aibrainag/Gretchen/README.md

# Gretchen
Gretchen -- An Open-Source Humanoid Robot Development Platform.

## Assembly Manual (wip)
https://github.com/aibrainag/Gretchen/blob/master/documentation/documentation.adoc
