aibrainag/Gretchen/documentation/documentation.adoc

= Gretchen Assembly Documentation
Doc Writer <kubisch@informatik.hu-berlin.de>
v0.1, 2019-03-28
:imagesdir: ./images
:toc:

_This is the Gretchen assembly manual. Following these steps will enable you to build your gretchen walking robot from the assembly kit. We encourage everybody to contribute to this project. Please share your ideas, upgrades, schematics, source-code and tricks._

== Tool and Part List
NOTE: Before starting the assembly. Check that you have all the tools and parts in place. We recommend to read this manual once before starting the assembly.

WARNING: Self-manufacturing of the parts is encouraged but can not be officially supported and hence is to your own risk. If you decide to manufacture your own parts then tolerances may vary depending on the machines and methods you are using.

=== Recommended Tools

You will need these tools to assemble the Gretchen (Dev0) robot.

* Allen keys (hex drivers) sizes M4, M2, M1.6
* Ring spanner and socket wrench, size M8
* Small Phillips screw driver
* Soldering iron with a very fine tip for motor assembly, up to 400°C (regulated) temperature
* Brushes for painting the parts
* Tweezers for motor control board assembly
* Flat-nosed pliers or a crimp tool for custom cabling
* Side-cutting pliers
* Wire stripper
* Utility knife
* crimp tool (see section cable confection)
* Multimeter
* Taps (threading drills), sizes M4, M8
* Clamps (5-10) for glueing parts together
* Sandpaper or files
* Acrylic paint (< 0.5m², color of your choice)
* Acrylic clear coat
* Wood Glue (Express)
* Superglue

*For self-manufacturing the body parts:*

* Lab or home quality 3D printer, e.g. Ultimaker using ABS or tough PLA filament
* Laser cutting or milling machine for the wooden parts

=== Gretchen Assembly Kit Parts

[cols=2*]
|===
2+| *Wooden Parts*
| 2  | Torso plates, 5mm plywood
| 4  | Thigh plates, 5mm plywood
| 4  | Shank plates, 5mm plywood
2+| *3D-Printed Parts*
| 8  | Pulley, D-spline Motor 42T
| 2  | Pulley, D-Spline Motor 33T
| 2  | Pulley, M8 Hexnut
| 2  | Hip X/Y with integrated Pulley
| 2  | Knee (outer part, L/R, with integrated Pulley)
| 2  | Knee (inner part, L/R)
| 2  | Foot
| 2  | Gimbal (Ankle)
| 2  | Pulley for Gimbal 42T
| 2  | Pulley for Gimbal 33T
| 10 | Motor Cover (Sensorimotor to Hitec HS805MG)
| 20 | Belt-Tensioner (optional)
2+| *Drive Parts*
| 20 | Flange Pillow Block Bearing KFL08
| 8  | Timing Belt GT3, U=303mm, D=6mm
| 2  | Timing Belt GT3, U=174mm, D=6mm
2+| *Electronic Parts*
| 12 | Hitec Servo Motor (10 + 2 Spare)
| 10 | Sensorimotor board rev. 1.1
| 10 | Temperature Sensor
| 10 | Electrolytic Capacitor, 220µF
| 10 | Pinheader 2x3 pins
| 20 | Molex SPOX Sockets for Sensorimotor 4-pin rectangluar
| 20 | Molex SPOX Plug 4-pin
| 100 | Molex SPOX crimp terminals
| 15 | Data cable, silicone, black (m)
| 5  | Data cable, silicone, red (m)
| 4 | Termination resistor
| 2   | Sleeving (m)
| 100 | cable ties
2+| *Bolts and Nuts*
2+| *M8*
| 2  | M8 DIN 912, Threaded Bolt, L=70mm, Hex Head, A2
| 6  | M8 DIN 912, Threaded Bolt, L=60mm, Hex Head, A2
| 2  | M8 DIN 912, Threaded Bolt, L=40mm, Hex Head, A2
| 2  | M8 DIN 912, Threaded Bolt, L=30mm, Hex Head, A2
| 28 | M8 DIN 439, Hex Nut, flat form A2
| 20 | M8 DIN 127, Split Lock Spring Washers
| 10 | M8 DIN 125, Split Standard Washers
2+| *M4*
| 4  | M4 DIN 912, Threaded Bolt, L=40mm, Cylinder head, A2
| 2  | M4 DIN 912, Threaded Bolt, L=30mm, Cylinder head, A2
| 16 | M4 DIN 912, Threaded Bolt, L=25mm, Cylinder head, A2
| 48 | M4 DIN 912, Threaded Bolt, L=20mm, Cylinder head, A2
| 16 | M4 DIN 912, Threaded Bolt, L=12mm, Cylinder head, A2
| 64 | M4 DIN 985, Hex Lock Nut
| 80 | M4 DIN 127, Split Lock Spring Washer
| 48 | M4 DIN 125, Standard Washer
2+| *M2*
| 20 | M2 DIN 912, Threaded Bolt, L=30mm, Hex Head, A2
|===

*For self-manufacture your robot's body parts:*

Home or lab-quality printers shall suffice. Print with "Tough" PLA or ABS plastic using 20% infill for the parts.
Print using 0.1 mm layer height for parts that contain pulleys (tooth belts need precision here). Print using 0.2 mm layers for all other parts. We recommend using water soluble support structure if available.

When using professional 3D-printing service, consider SLS (Selective Laser Sintering).

== Glueing

The wooden parts are approx. 5mm thick. Each Gretchen body part (lower torso, thigh or shank) is composed of two 5mm wooden plates glued together to reach the 10mm needed. Hence, in your assembly kit you should have 4x shank, 4x thigh, 2x torso plates.

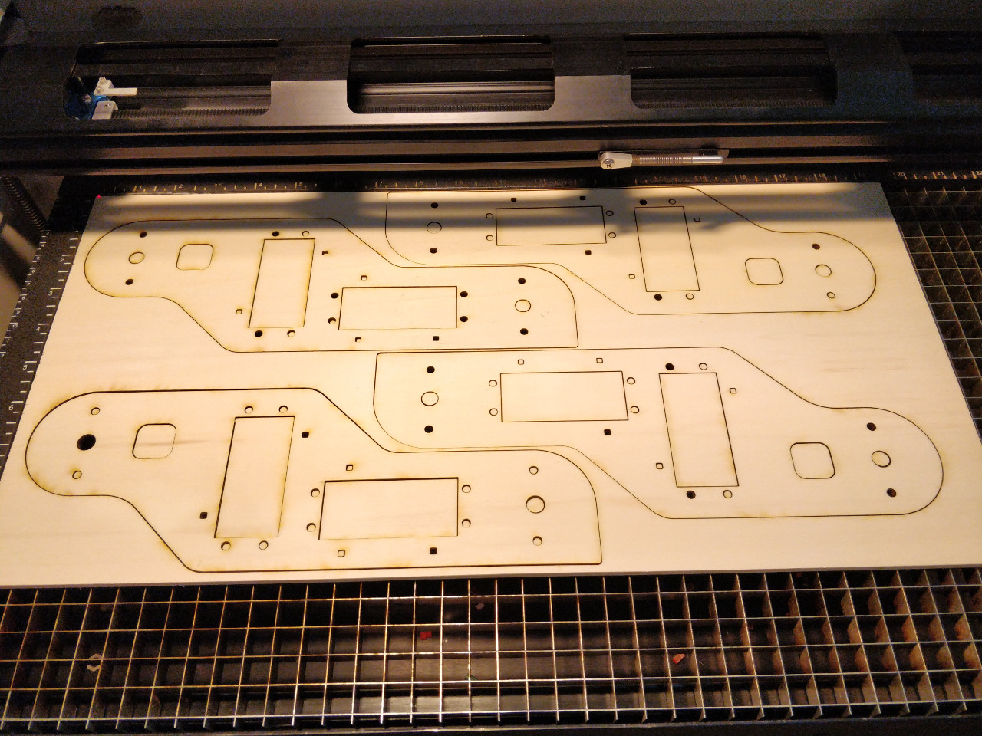
[picture p1: documentation/images/lasercut_parts.jpg]


=== Prepare workbench.
Make sure you have all the tools needed for glueing:

* a lot of clamps (5 - 10 small clamps)
* Sandpaper or fine file
* small screwdriver
* cutter knife
* express wood glue

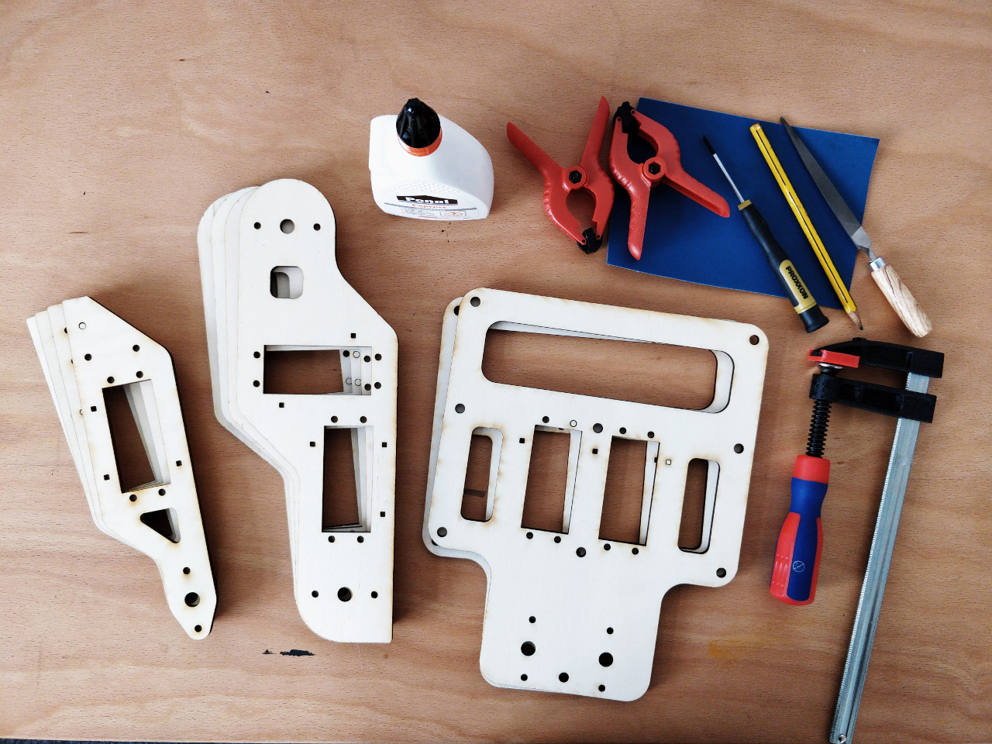
[picture p2: documentation/images/prepare_workbench_and_tools.jpg]


=== Prepare the wood parts for glueing.
Gently remove the remaining loose parts and price stickers, if any are present. Depending on the laser cut depth, it may appear that remaining parts (clippings) must be removed carefully with a cutter knife or sandpaper.

Approximated time needed: 5 - 10 minutes

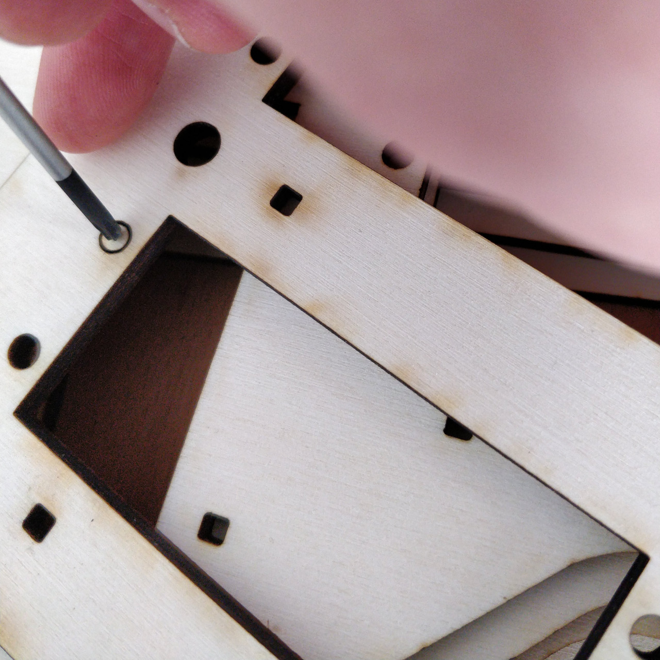
[picture p3: documentation/images/remove_loose_parts.jpg]

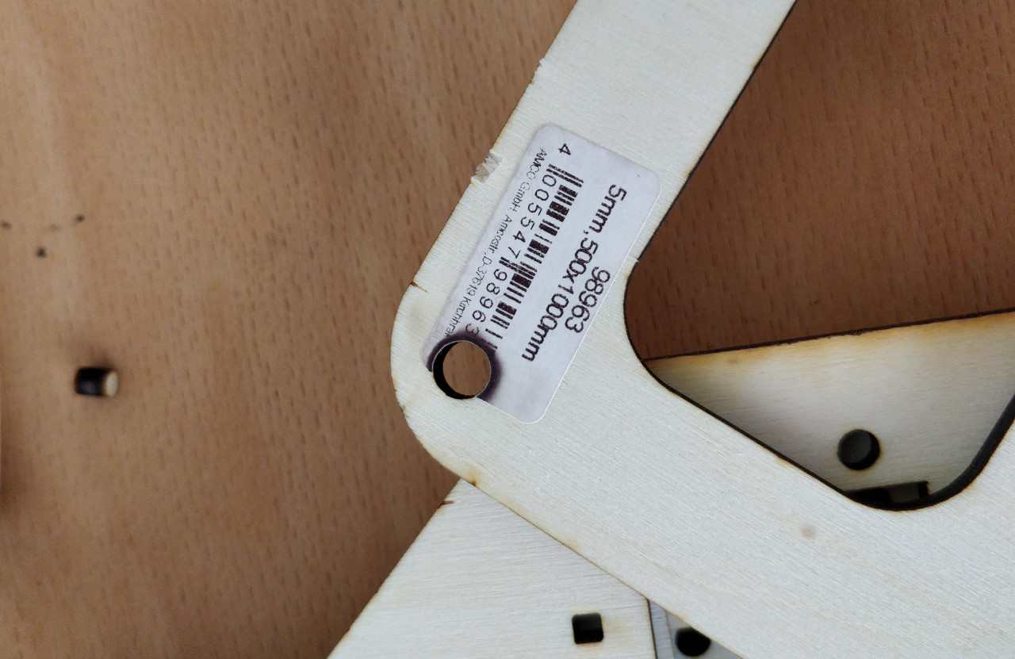
[picture p4: documentation/images/remove_stickers.jpg]


=== Glue the parts together.
Glue the parts together preferably using express wood glue. Apply glue uniformly following the recommendations of the specific glue user manual.

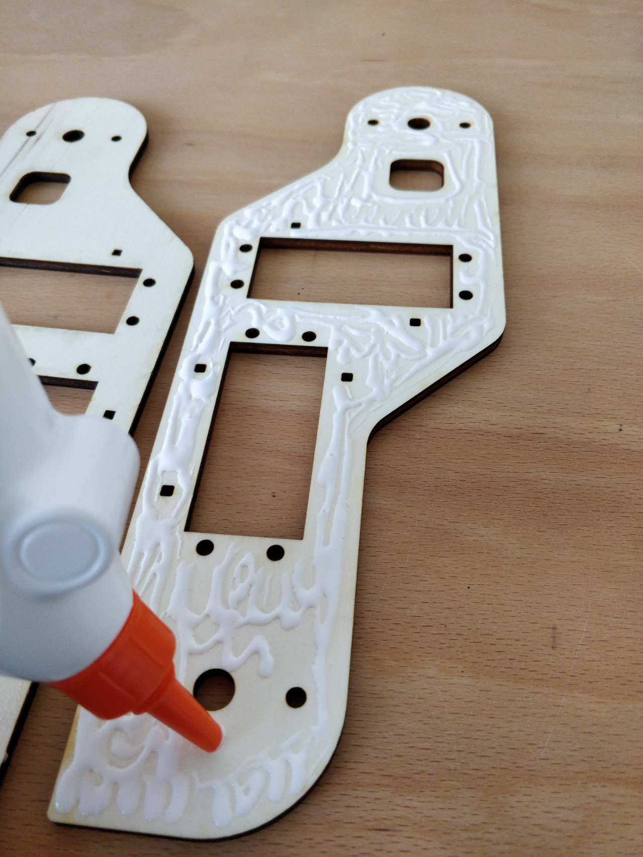
[picture p5: documentation/images/apply_glue_uniformly.jpg]

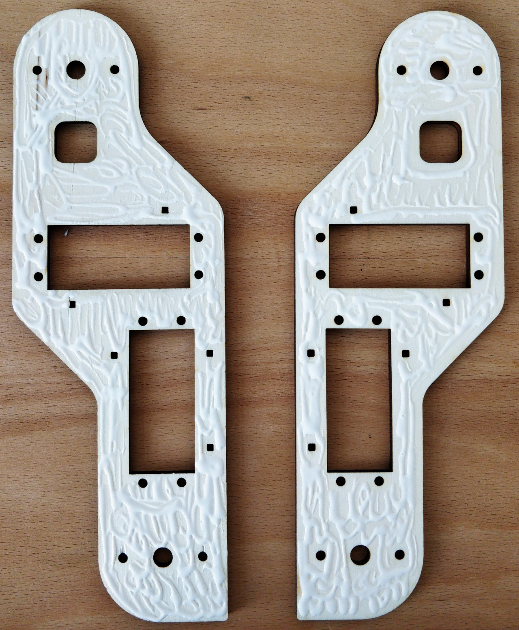
[picture p6: documentation/images/ready_for_glueing.jpg]


Use many small clamps to apply appropriate pressure distributed on the full surface. Use some of M4 screws to hold the parts in place and assure that the parts are nicely aligned before the glue gets dry.

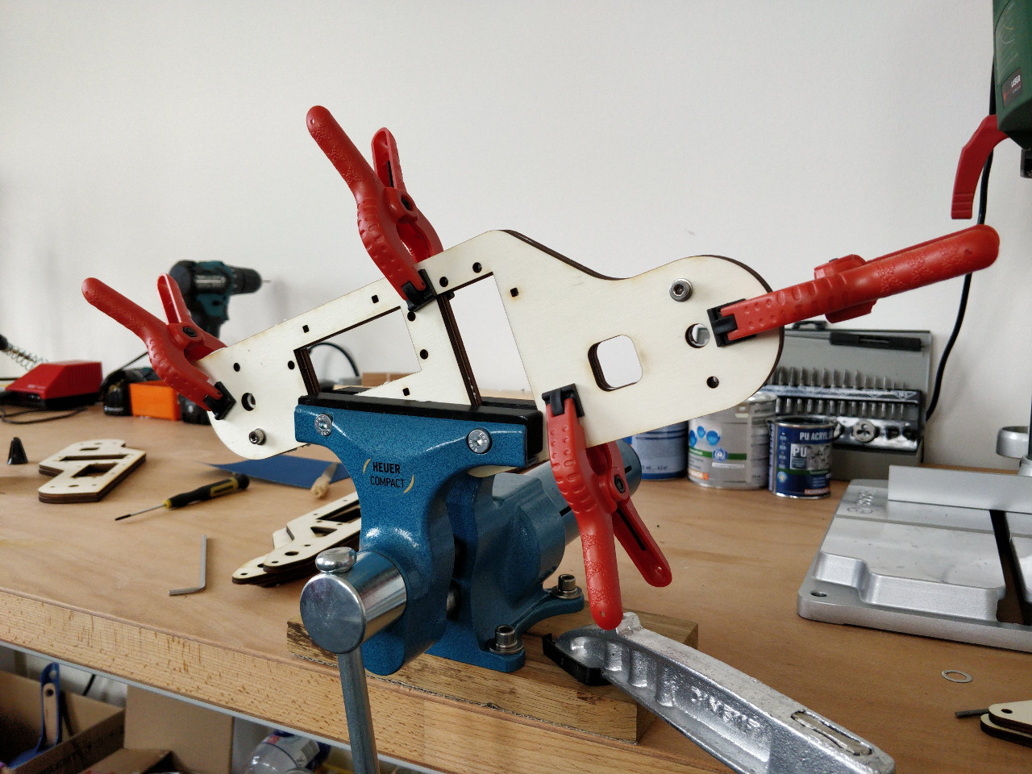
[picture p7: documentation/images/clamping_parts.jpg]

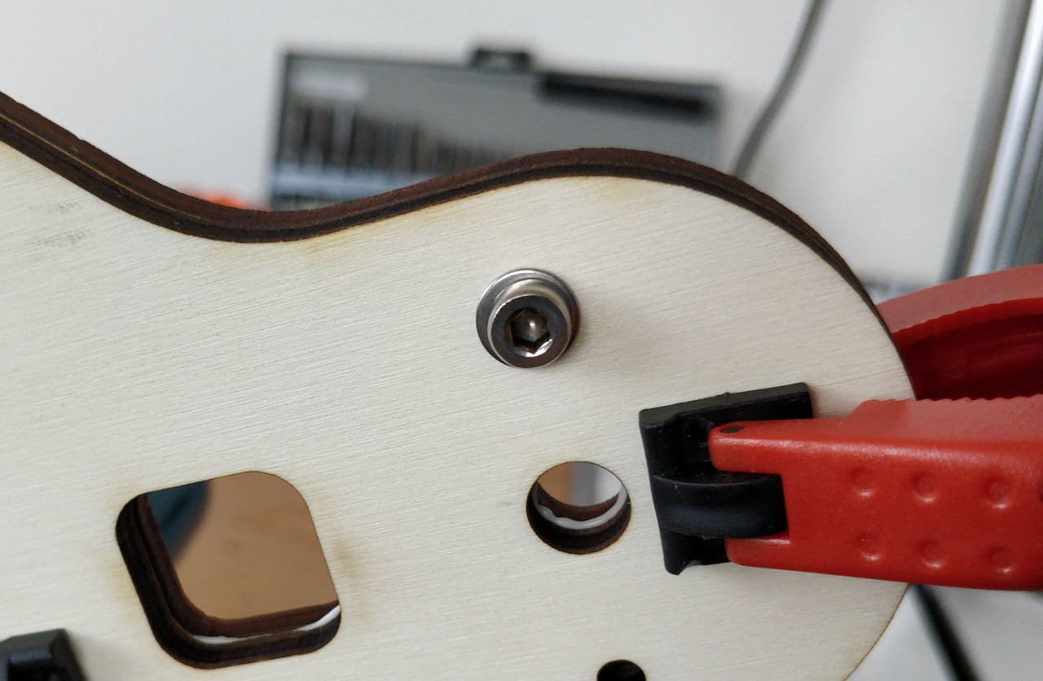
[picture p8: documentation/images/align_and_fix_with_screw.jpg]


Let the assembly dry for some time with the clamps attached. Follow specific instructions depending on the glue you are using. Remove remaining glue _after_ drying. Since otherwise smeared adhesive on the wood parts can not be painted well.

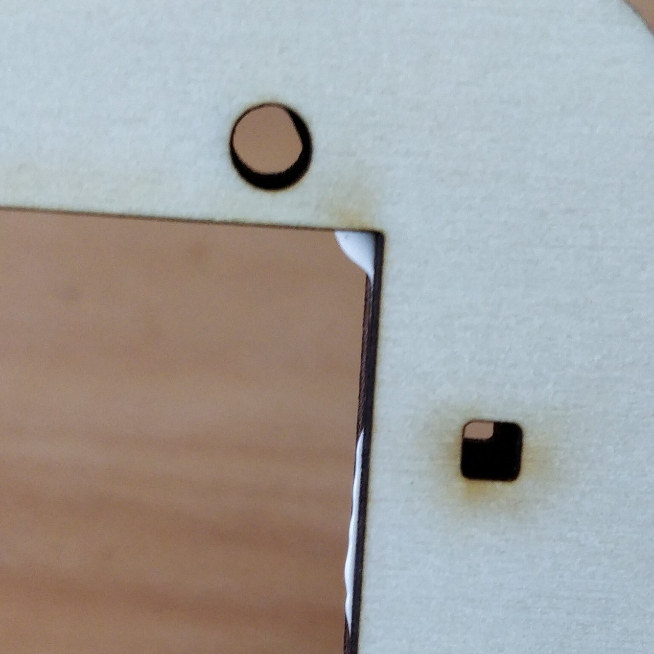
[picture p9: documentation/images/excessive_glue.jpg]


Glueing takes approximately *10 - 15* minutes per part. But drying will probably take *1 - 2* hours depending on the glue you are using. Repeat the process for all wooden parts, i.e. one lower torso, two thighs, two shanks.

The result should look like this:

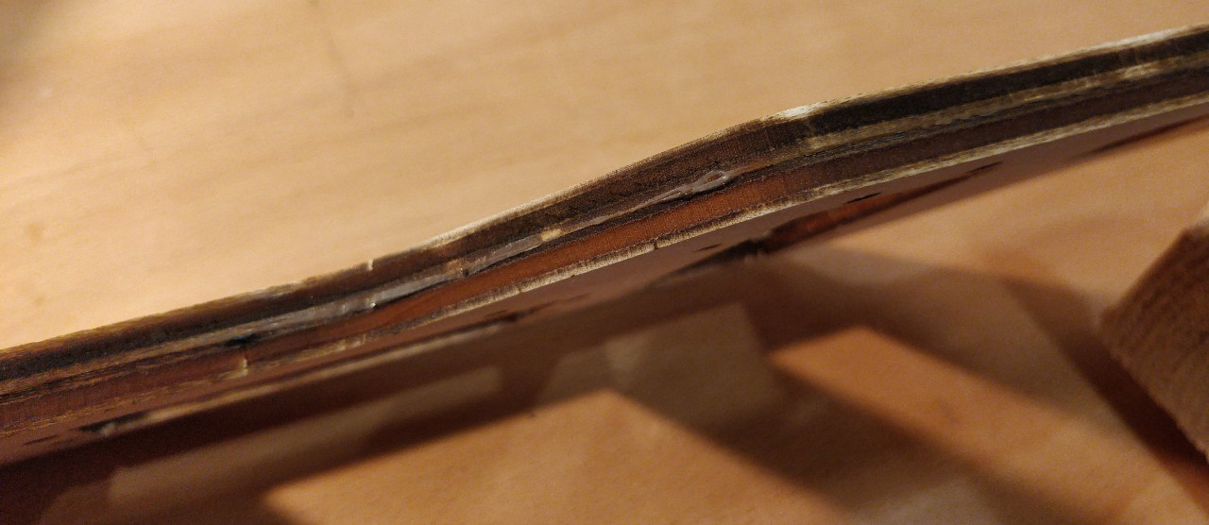
[picture p10: documentation/images/glue_result.jpg]


== Coloring

Color is of course optional but gives your Gretchen an individual character. Nonetheless it is recommended to apply some clear coat to protect the wooden parts from humidity and fat.

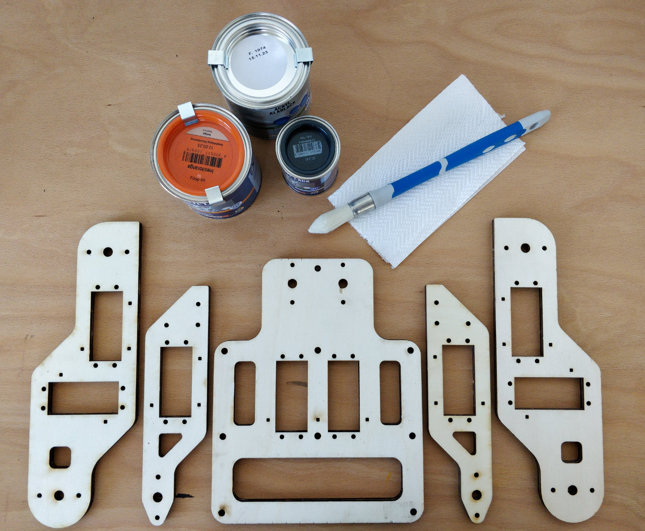
[picture p11: documentation/images/coloring_parts_start.jpg]


=== Paint the parts
We recommend coloring the surfaces of the wooden parts and leave the nicely burned laser cut edges unpainted.

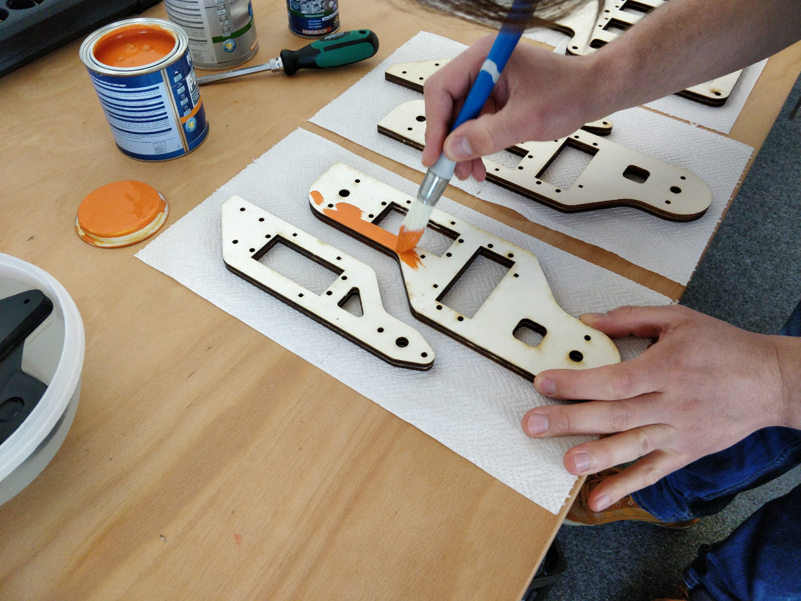
[picture p12: documentation/images/coloring_parts_doing.jpg]


For instance we painted the outer surfaces orange and the inner surfaces antrazit.

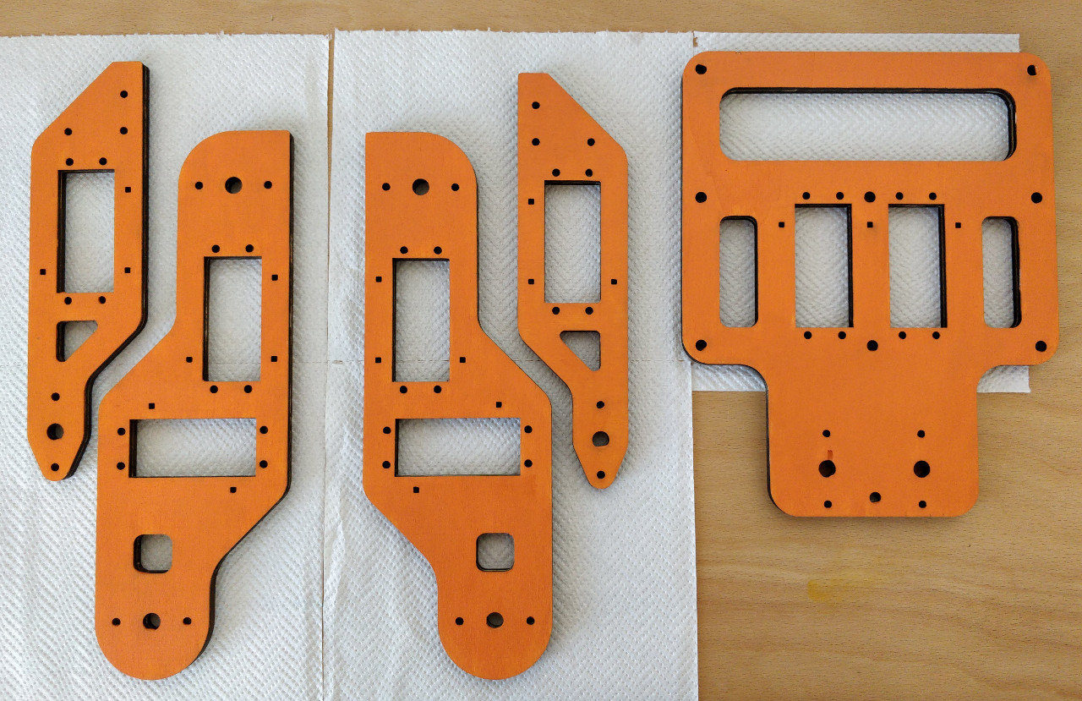
[picture p13: documentation/images/coloring_parts_orange.jpg]

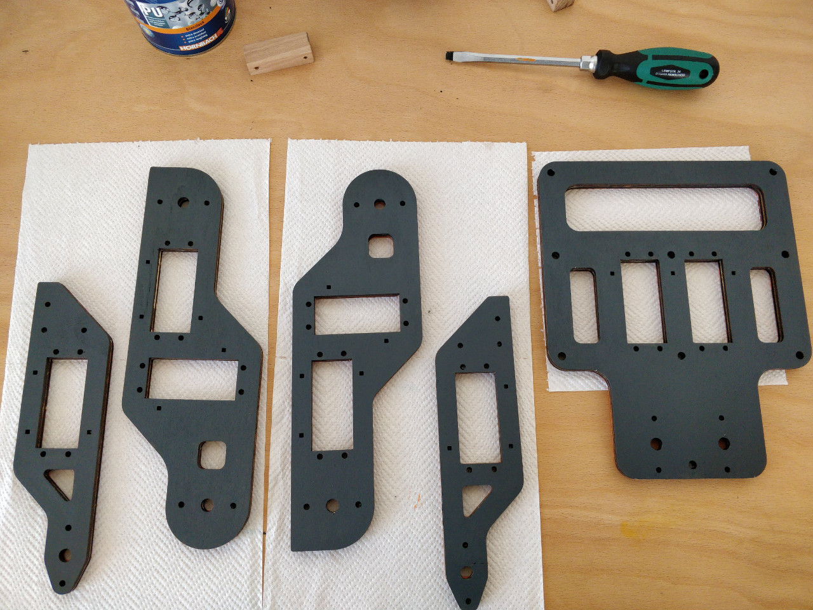
[picture p14: documentation/images/coloring_parts_antrazit.jpg]


In the end it could look like this:

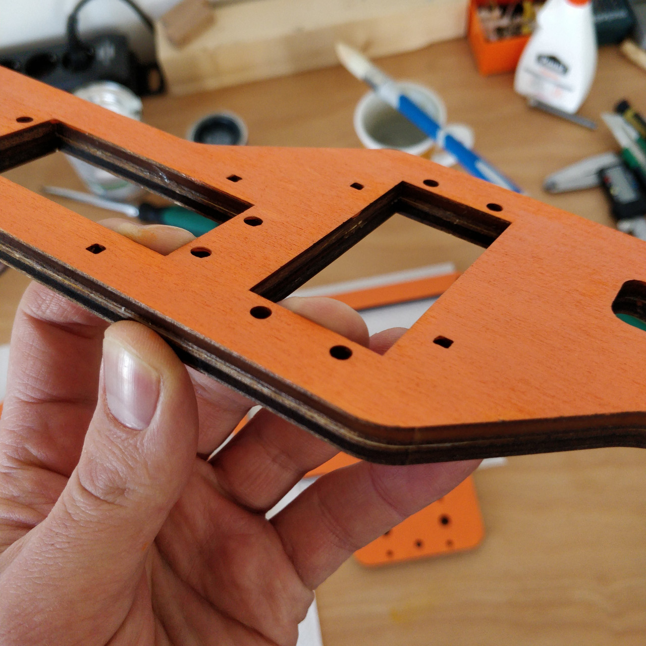
[picture p15: documentation/images/coloring_parts_ready.jpg]


=== Applying clear coat

After coloring or coating the wooden parts for the first time, little bristles come up and the surface feels very rough and bristly.
Before finishing with the last coating layer, carefully use sandpaper to make the surface smooth without removing the color.

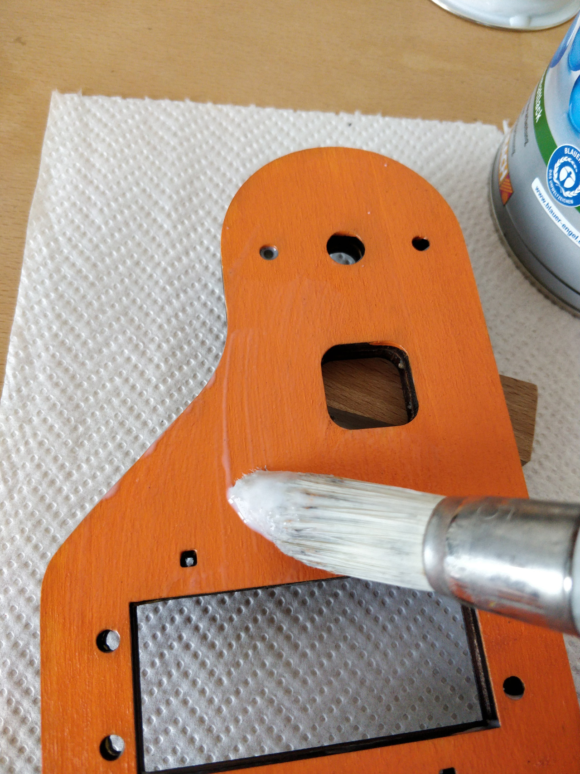
[picture p16: documentation/images/coloring_parts_clearcoat.jpg]


== Assembly

Assembly is done in several steps. Although there are many possible ways to assemble, we recommend the order given in the manual.

=== Bearings

We begin the assembly with mounting the bearings. You need:

* all five wooden parts
* 16 bearings KFL08
* 16 screws M4 x 25 mm
* 16 lock nuts M4
* 32 spring washers M4
* an M4 hex screw driver and complementary a spanner

Note: If you consider to use an electric screw driver we recommend using torque control.

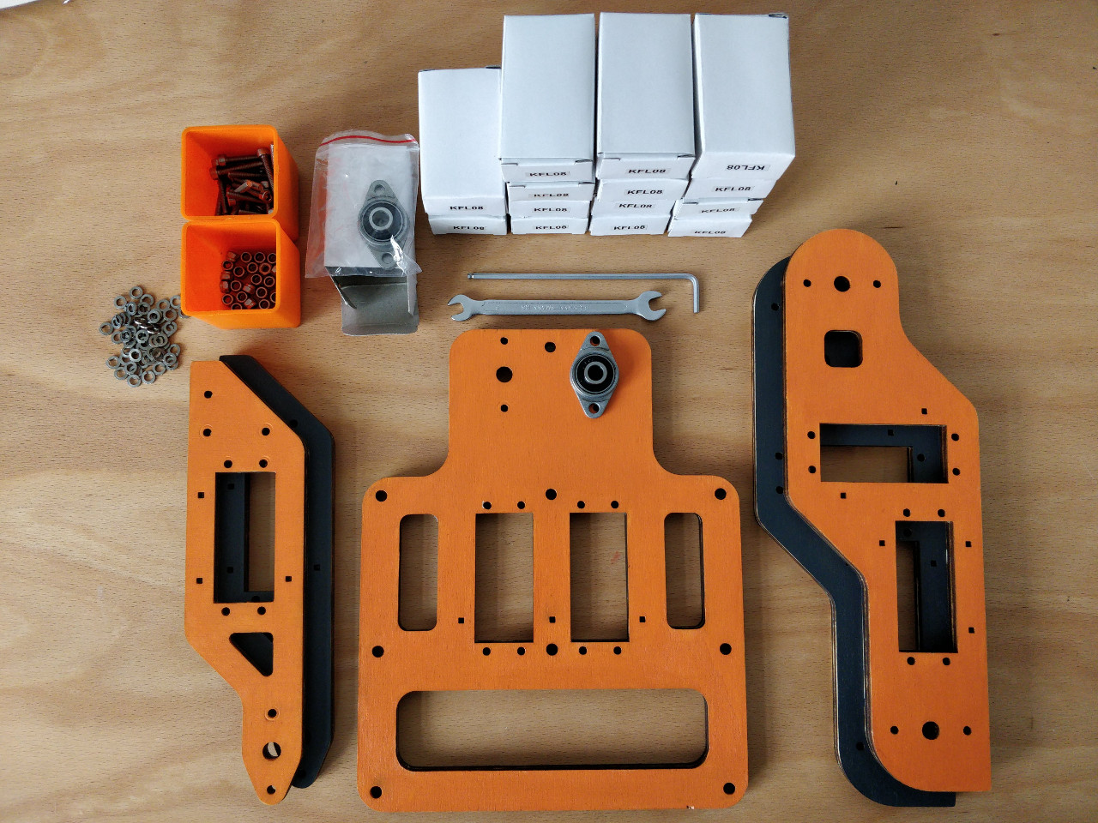
[picture p17: documentation/images/prepare_bearing_mounting.jpg]


Before starting, make sure to remove remaining glue from the screw holes. Use a drill or hex screw driver to remove the dried glue.

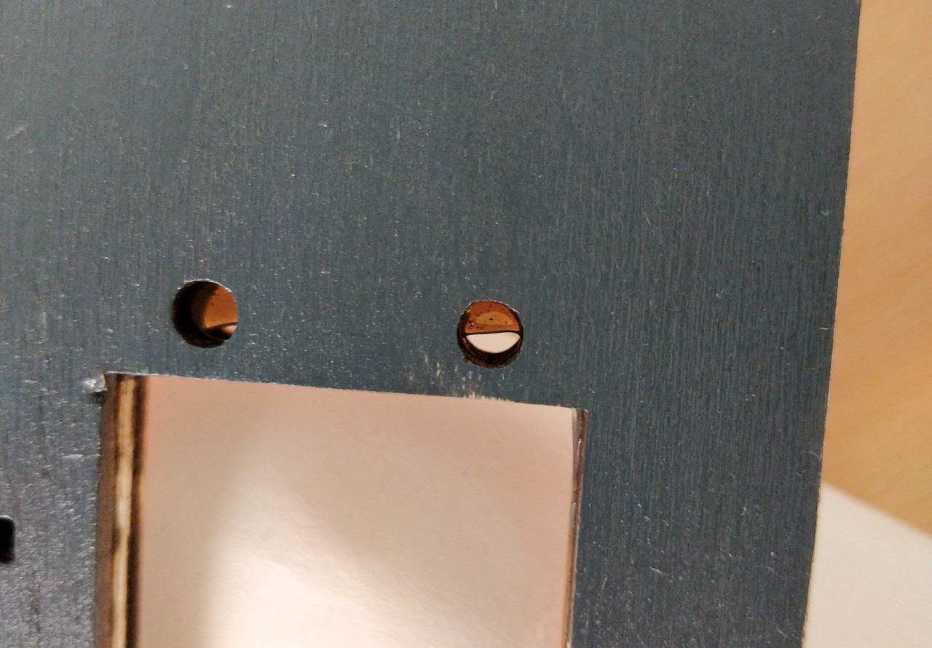
[picture p18: documentation/images/remove_glue_in_holes.jpg]


The bearings are self-aligning, i.e. they can change their axes' direction. Bearings must be properly aligned, to guarantee a solid belt tension later. You should initially move the bearings once to slightly loosen the connection and more easily correct the alignment.

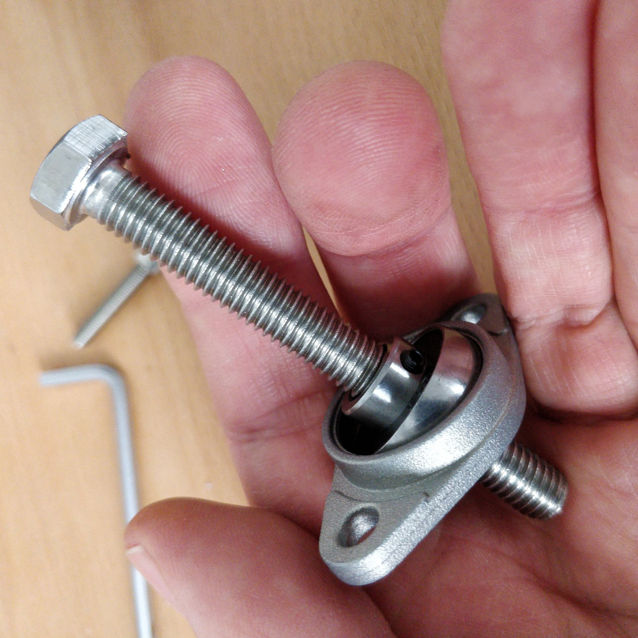
[picture p19: documentation/images/centering_bearings.jpg]


Mount the bearings on both sides (dual bearing) using the M4 x 25 mm screws as shown in the picture. You should only tighten the screws loosely in the first place and than correct the axis to be perpendicular to the surface.

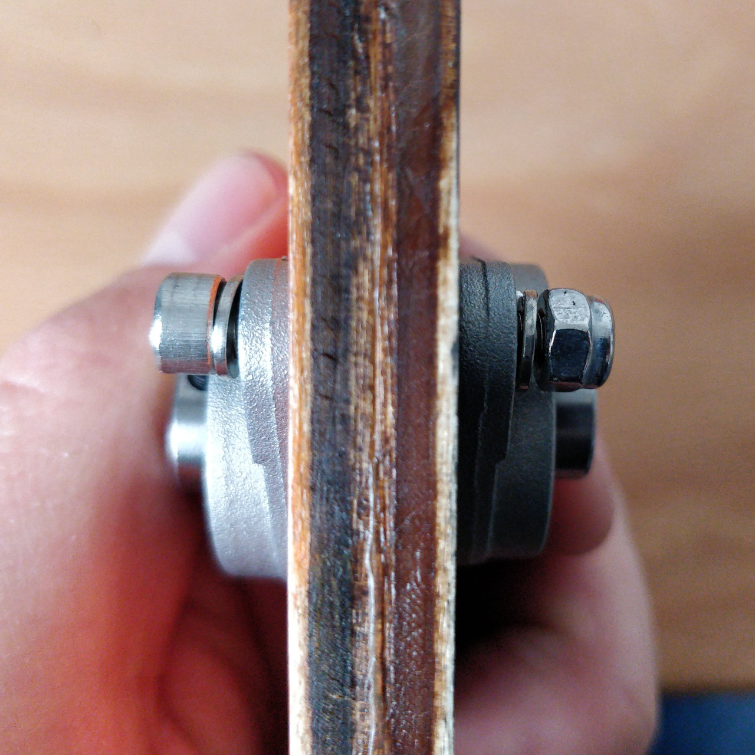
[picture p20: documentation/images/assemble_loosly.jpg]


Check the proper rotation of the axes.

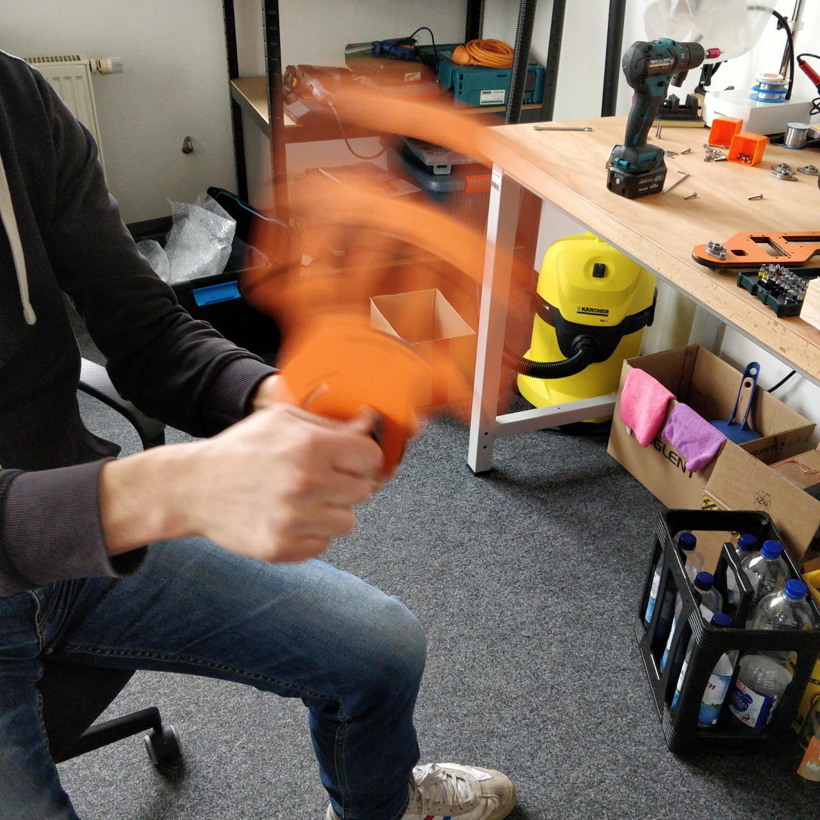
[picture p21: documentation/images/check_bearing.jpg]


After proper centering the bearing, tighten screws. The final result should look like this.

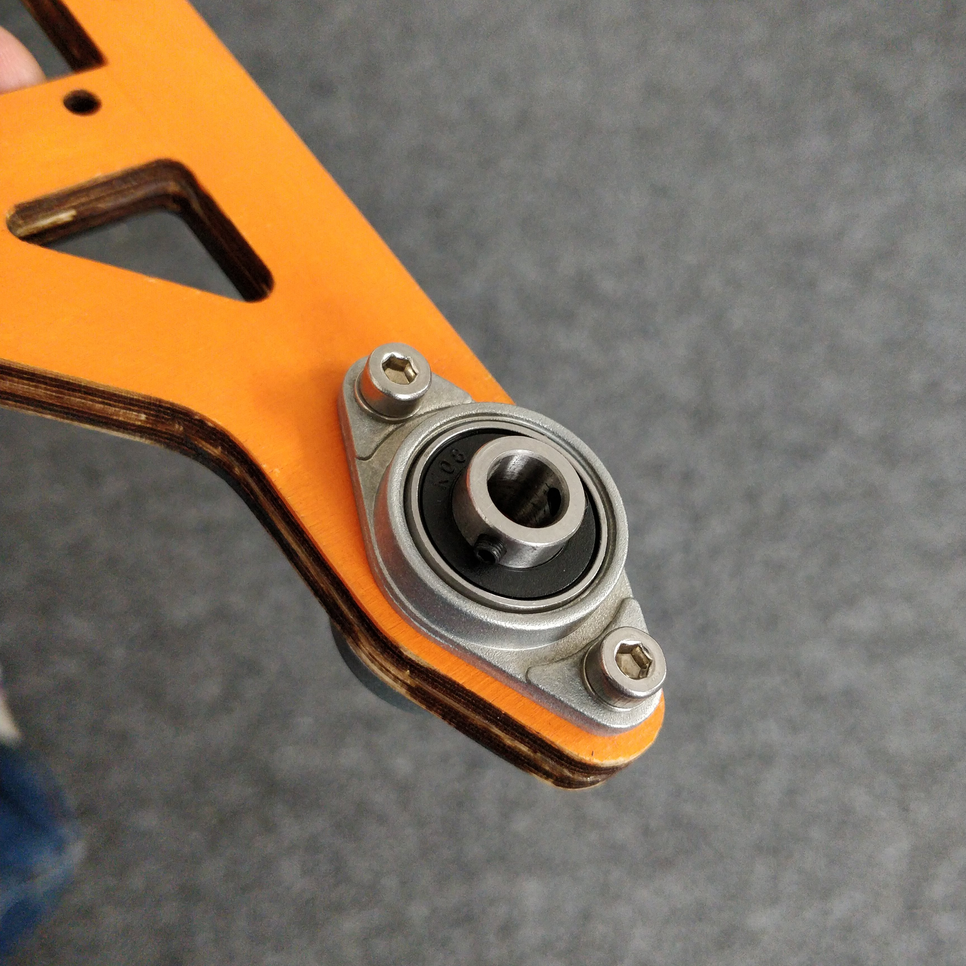
[picture p22: documentation/images/bearing_mounted_0.jpg]


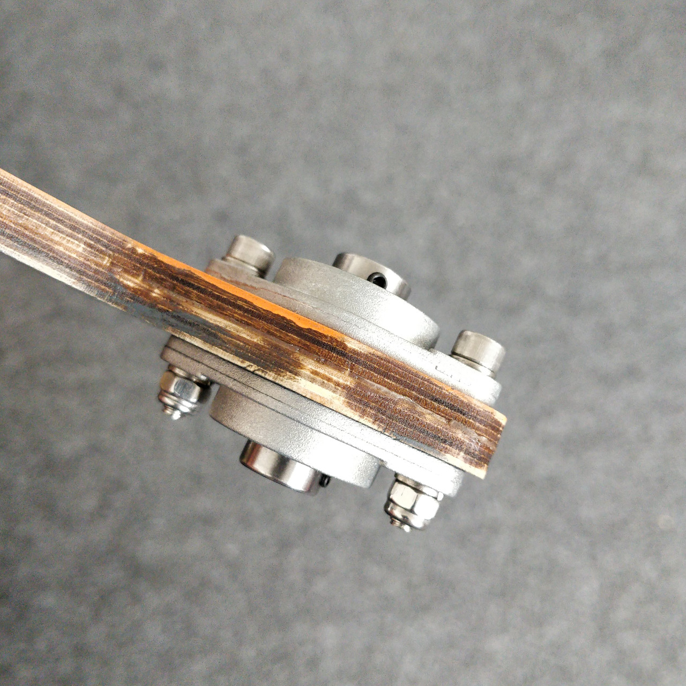
[picture p23: documentation/images/bearing_mounted_1.jpg]


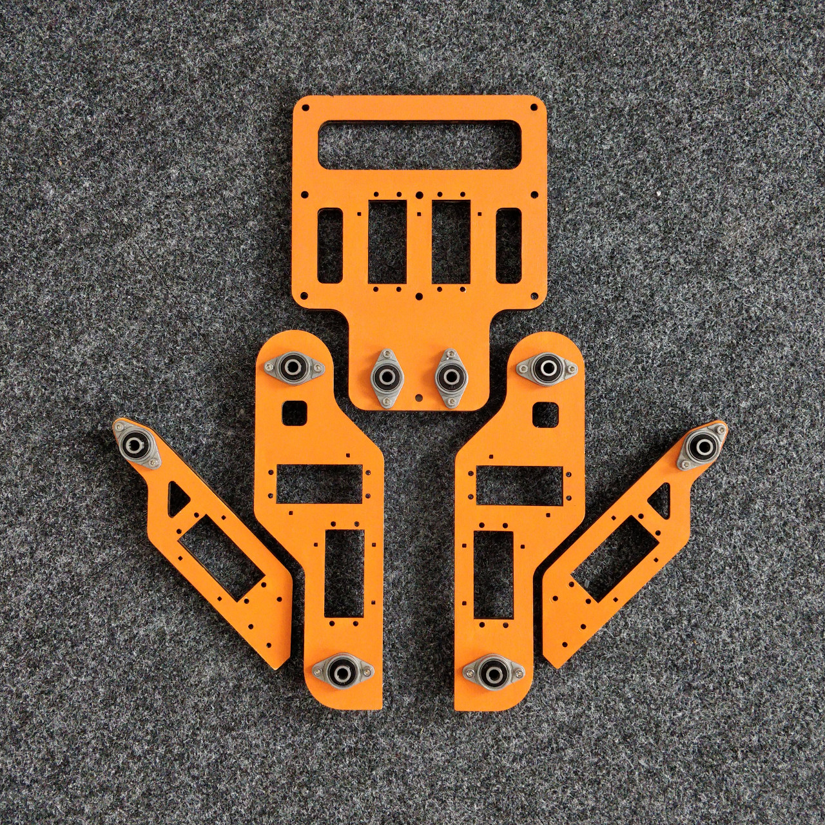
[picture p24: documentation/images/bearing_mounted_finished.jpg]


=== Knee

The next step is mounting the knees. Prepare workbench by compiling the needed parts (per knee):

* shank with bearings
* knee inner
* knee outer (with integrated tooth belt pulley)
* 2x M4 x 40 mm screws
* 1x M4 x 30 mm screw

Tools:

* (electric) screwdriver,
* clamp (optional),
* M5 drill (optional)

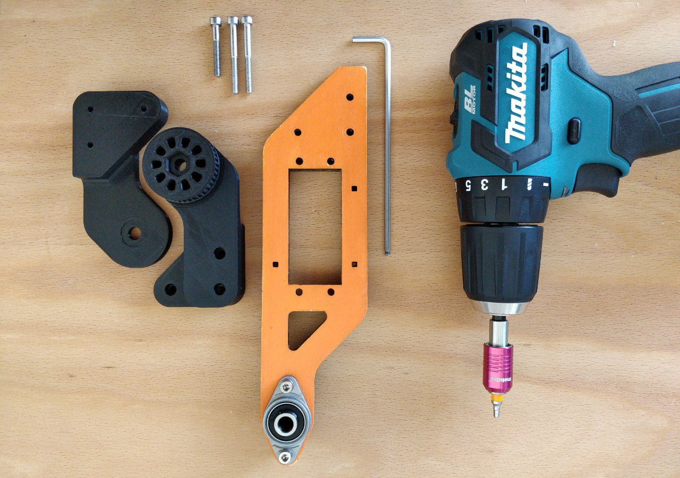
[picture p25: documentation/images/prepare_mounting_knee.jpg]


Insert the 3 screws into the outer knee part (with pulley). Insert only as deep as the screw tips are barely visible, just enough to find the corresponding hole in the wooden part.

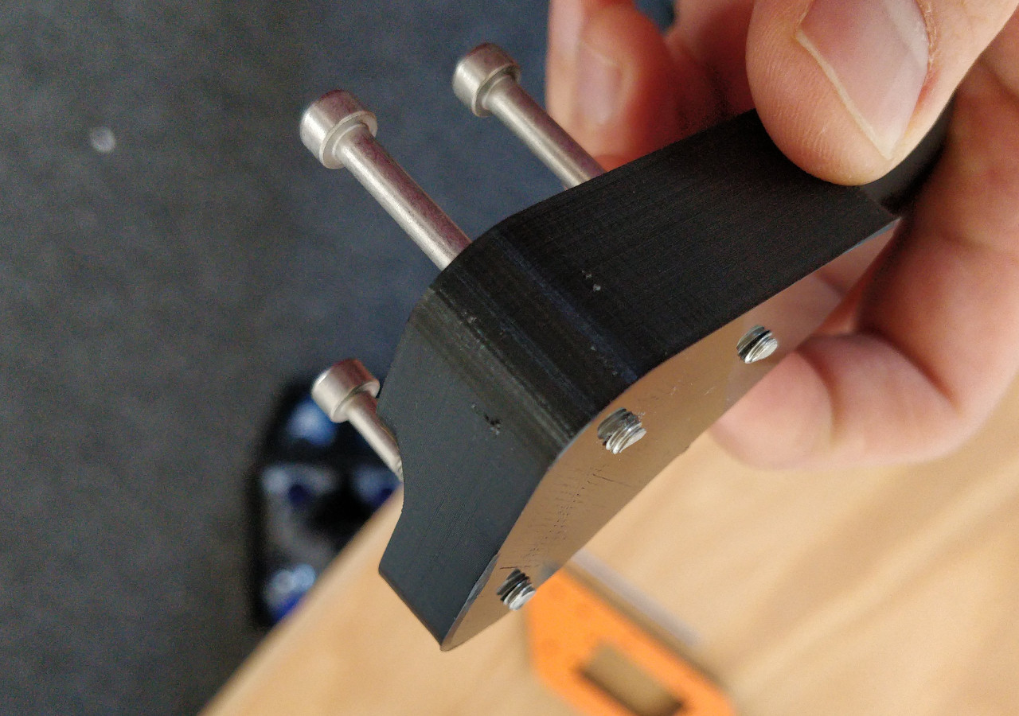
[picture p26: documentation/images/knee_mounting_0.jpg]


Screw the two parts together. Probably pressing the part down to the workbench might help to get the screws inserted. Again, turn only as far as the tips of the screws are barely visible.

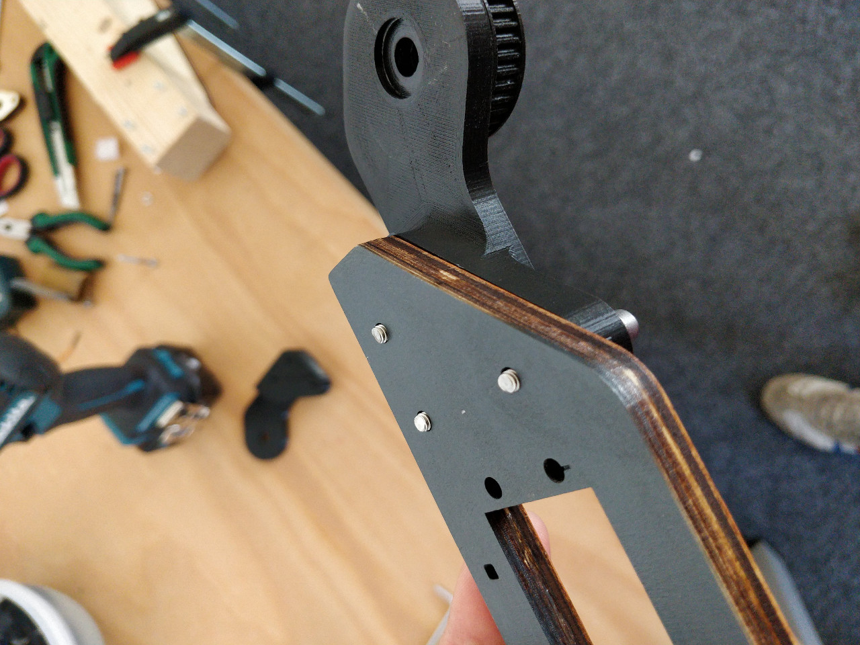
[picture p27: documentation/images/knee_mounting_1.jpg]


Carefully sinking the holes of the inner side of the second plastic part with a drill of size 5mm will help the screws _finding_ the holes. Sink less than 1mm.

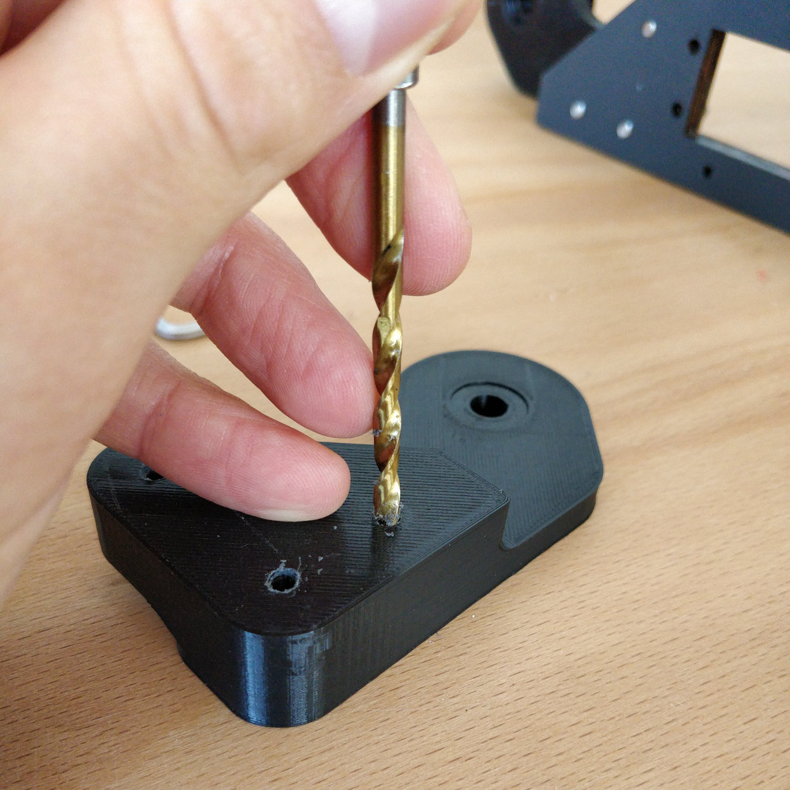
[picture p28: documentation/images/knee_mounting_sink_hole.jpg]


Mount the second part, optionally using a clamp, to have the parts perfectly aligned. Since there are no dedicated nuts here, don't turn to fast and powerful, the screw will create their own thread into the plastic, which must be preserved.

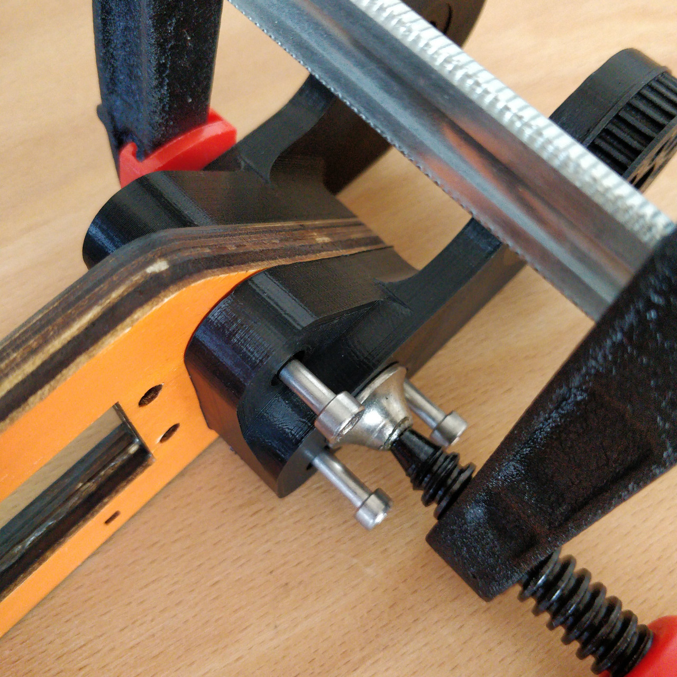
[picture p29: documentation/images/knee_mounting_2.jpg]


After mounting the knee, the result should look like this. Again, don't overturn here. Use torque limiter on your electric screwdriver.

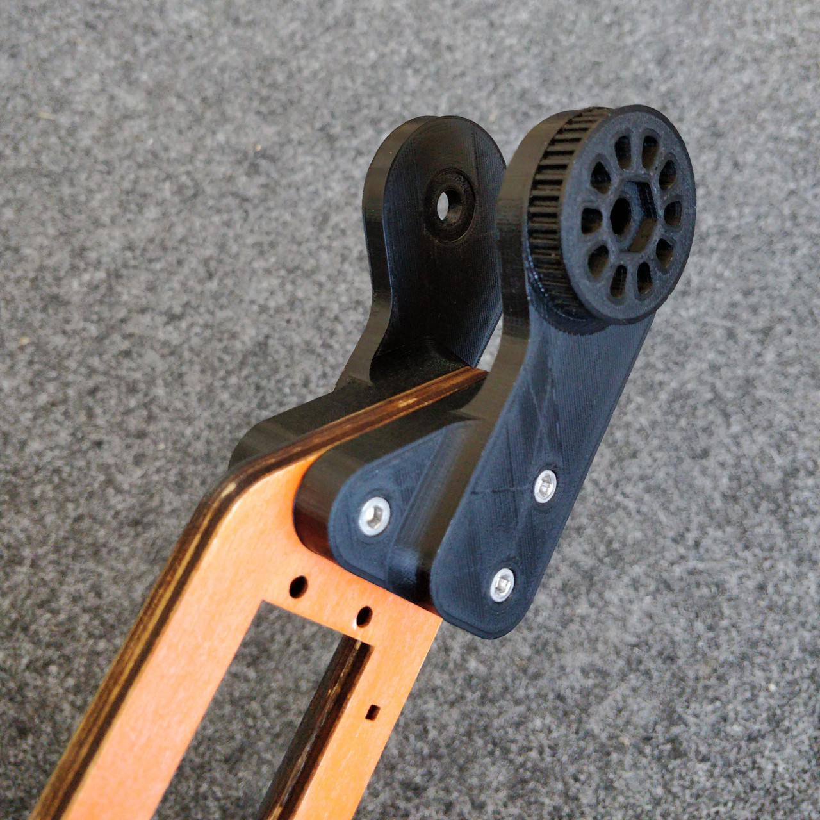
[picture p30: documentation/images/knee_mountin_ready_0.jpg]


Repeat the process with the second knee.

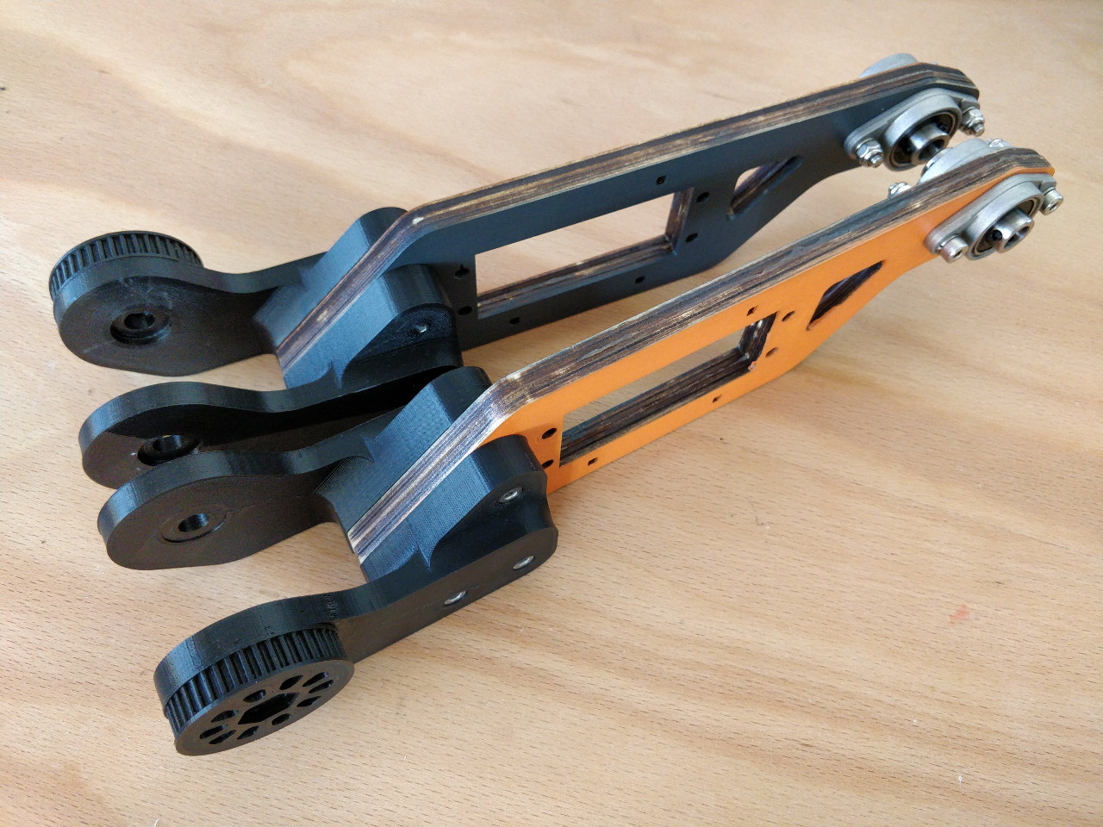
[picture p31: documentation/images/knee_mountin_ready_both.jpg]


=== Hip

Always remember: *Easy does it. Don't push too hard.* In German: "Nach fest kommt ab." (After firmly comes off.)

==== Assemble Hex Nut Pulleys
Prepare workbench for assembly, you need the both pulleys and 2 hex nuts with flat form. Depending on the print tolerances you either need addionally a *clamp* for adding a little force to insert or need some *express glue* to keep the hex nut in place, if it is too loose.

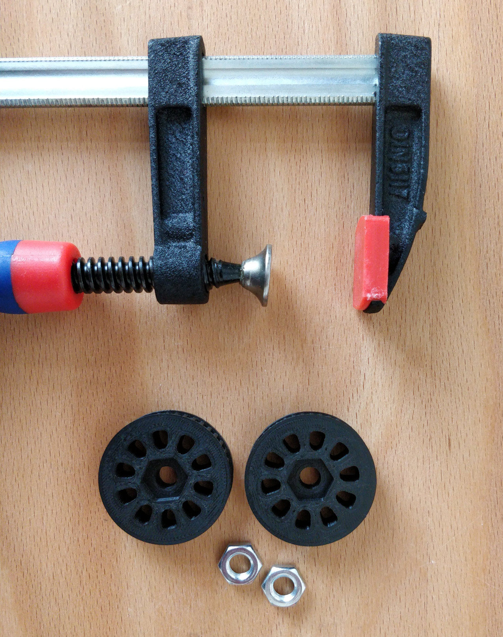
[picture p32: documentation/images/prepare_hex_nut_pulley.jpg]


This is how the hex nut should be inserted.

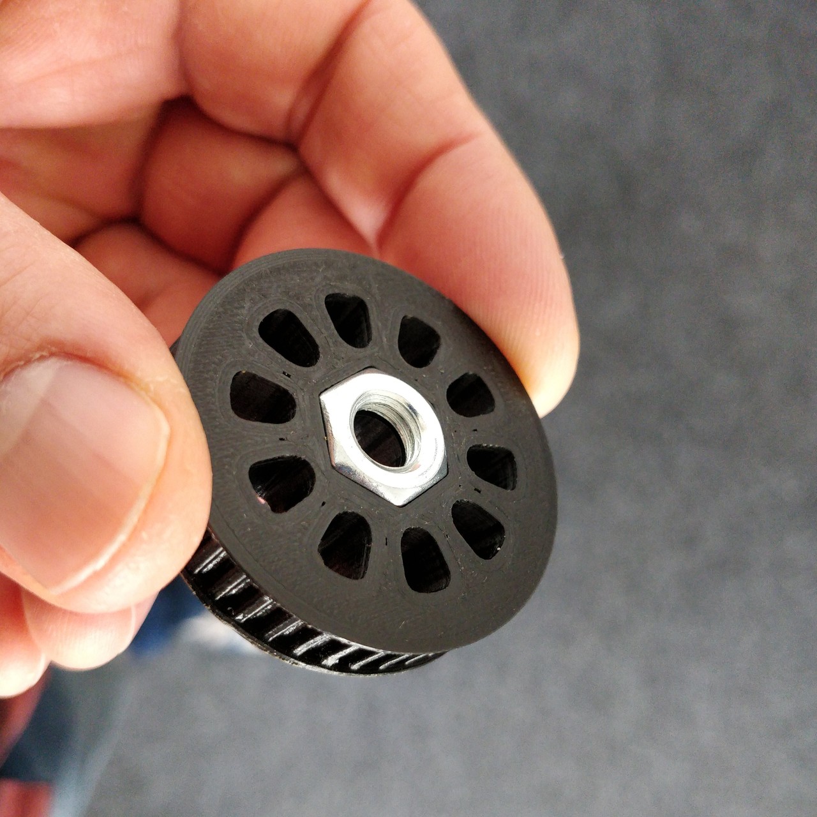
[picture p33: documentation/images/hex_nut_inserted_into_pulley.jpg]


If the pocket is too tight, use the clamp for insertion. If it is too loose use a little drop of express glue to keep it in place.

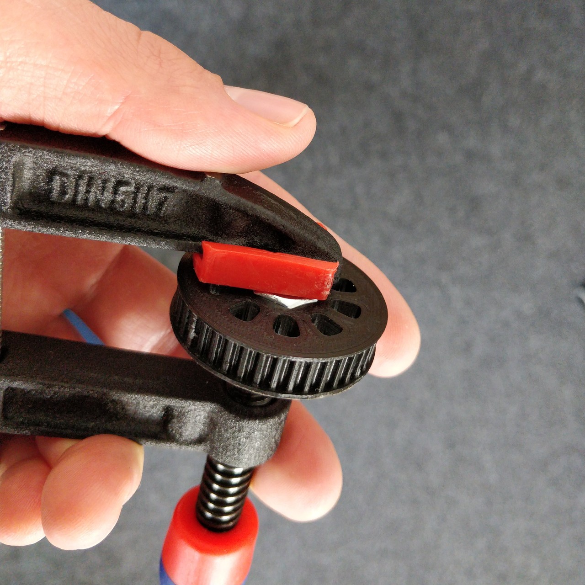
[picture p34: documentation/images/forcing_hex_nut_insertion_with_clamp.jpg]


==== Inserting the bolts' threading into pulley
Next step is to cut the threading into the pulleys.

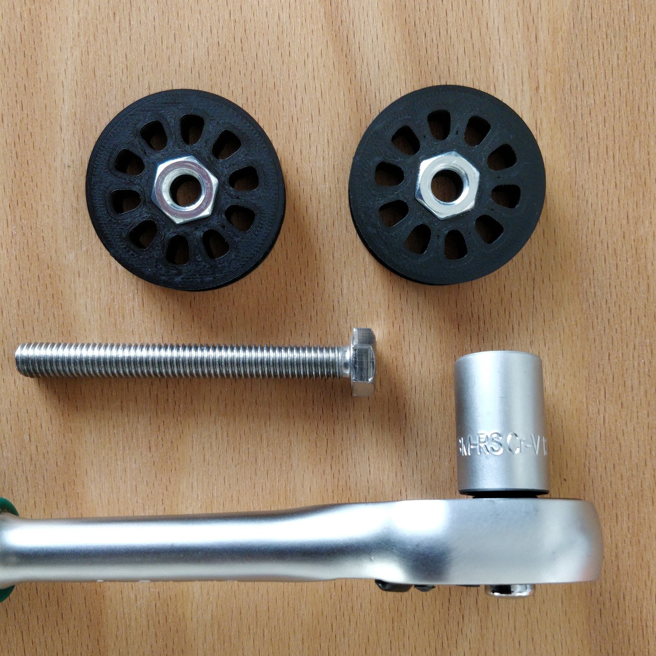
[picture p35: documentation/images/prepare_hex_nut_pulley_bolt_insertion.jpg]


If you have an M8 threading drill at hand, use this, otherwise use the M8 screw directly to cut the threading. Always begin with the cutting from the nut side, in order to assure a continuos threading between nut and plastic.
Using the wrench for cutting will need a little power, so prepare for the turning to need a little more torque than usual.

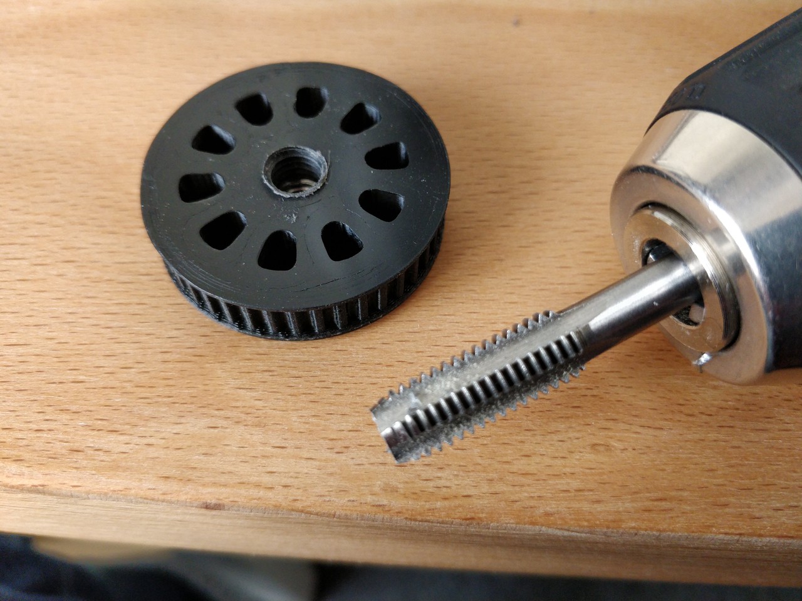
[picture p36: documentation/images/hex_nut_pulley_threading_with_drill.jpg]


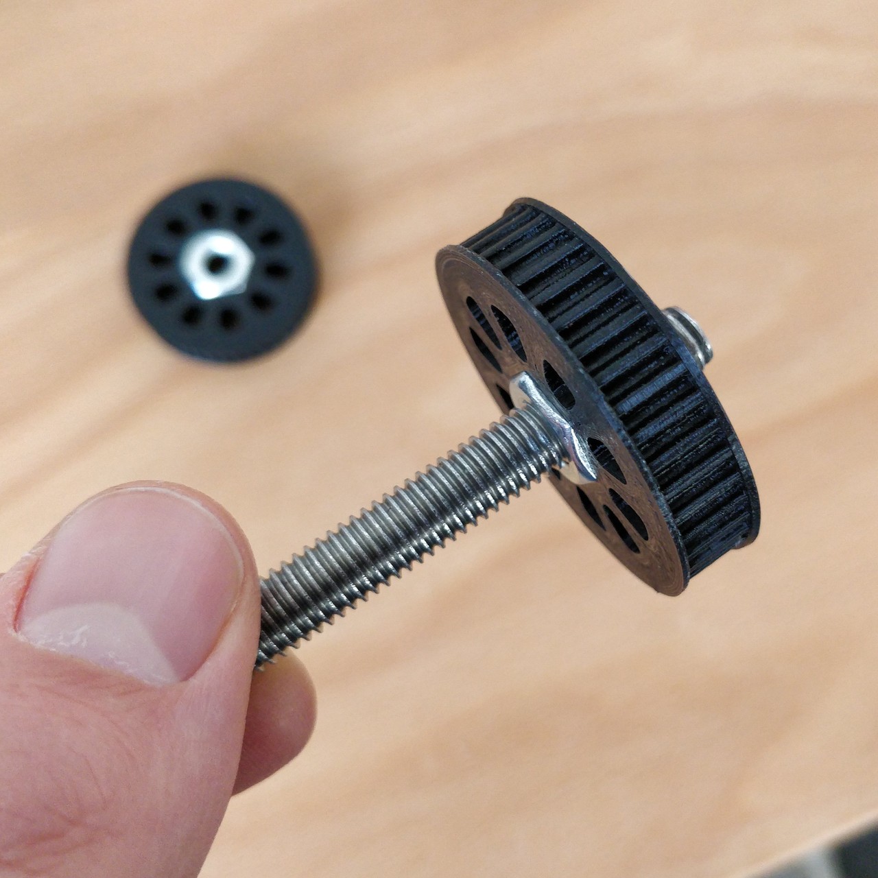
[picture p37: documentation/images/hex_nut_pulley_threading_with_bolt.jpg]


Insert the bolt from the other side and repeat the process for the second pulley.

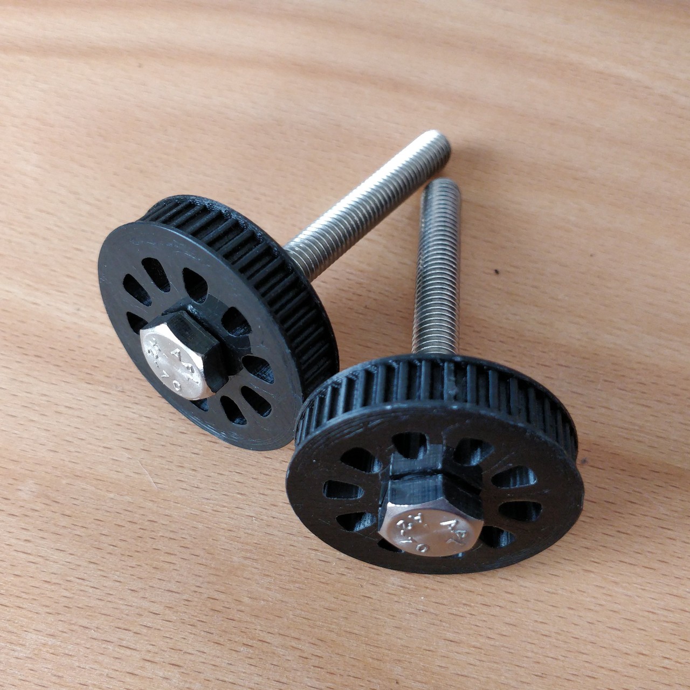
[picture p38: documentation/images/hex_nut_pulleys_with_bolts_ready.jpg]


Remove remaining overextruded plastic or sharp edges using sand paper or cutter.

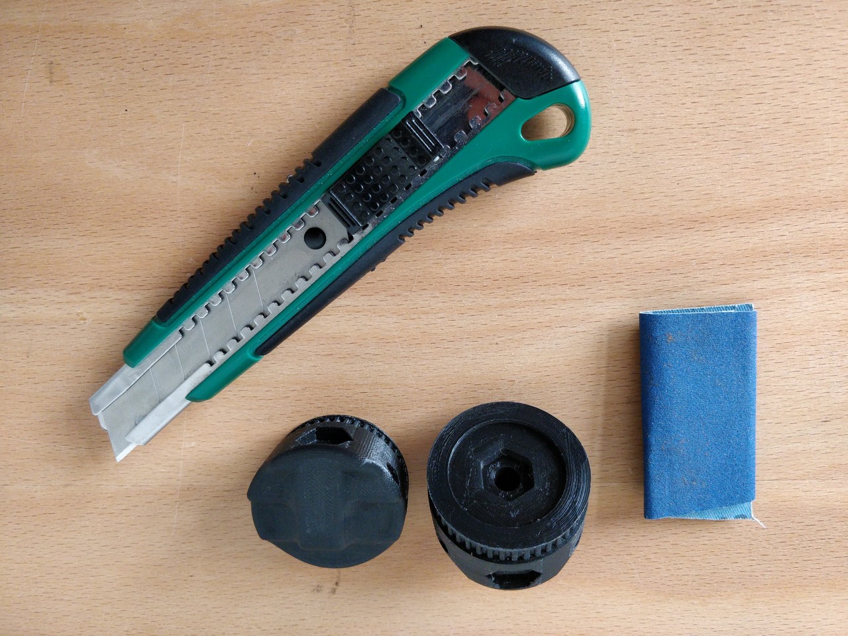
[picture p39: documentation/images/clean_sand_hip_parts.jpg]


Check for clean and even pockets and glue the nuts into the pockets using express glue. Probably check the nut for good quality to guarantee a perpendicular bolt alignment.

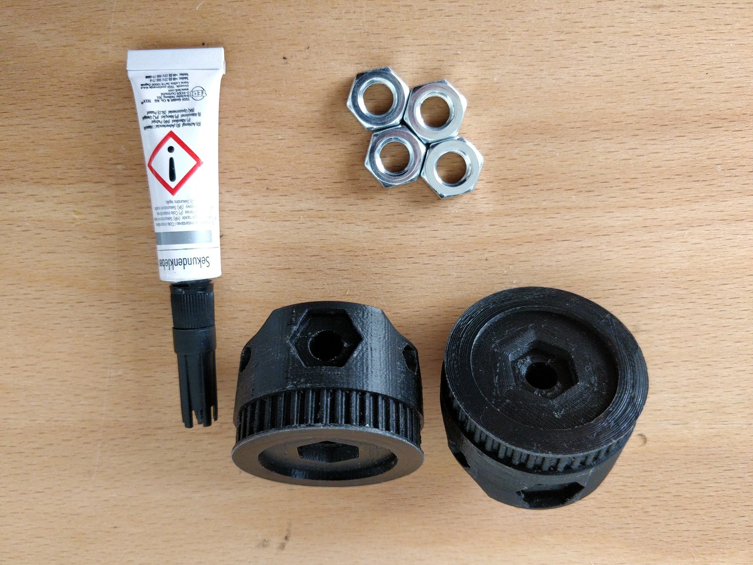
[picture p40: documentation/images/glue_nuts_into_pockets.jpg]


Use clamps while let drying the glue.

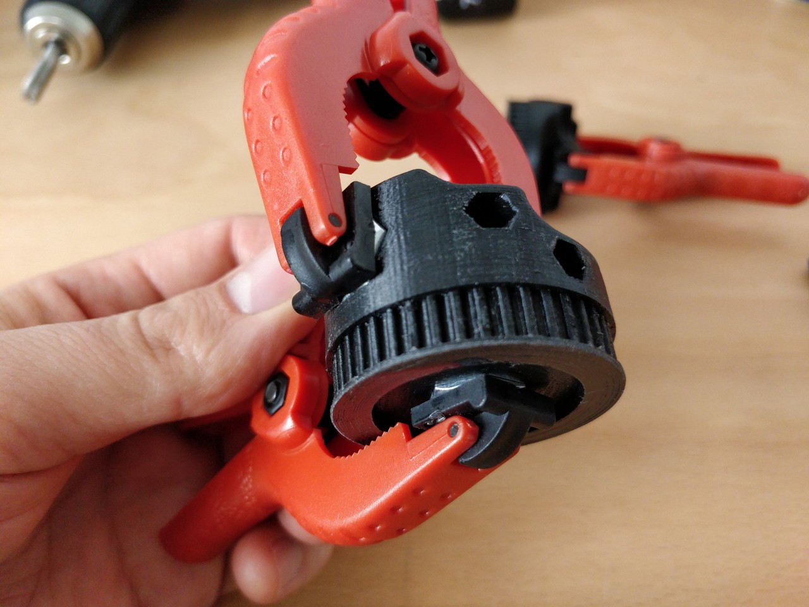
[picture p41: documentation/images/use_clamps_to_dry_glued_nuts.jpg]


As before use the threading drill carefully with limited torque.

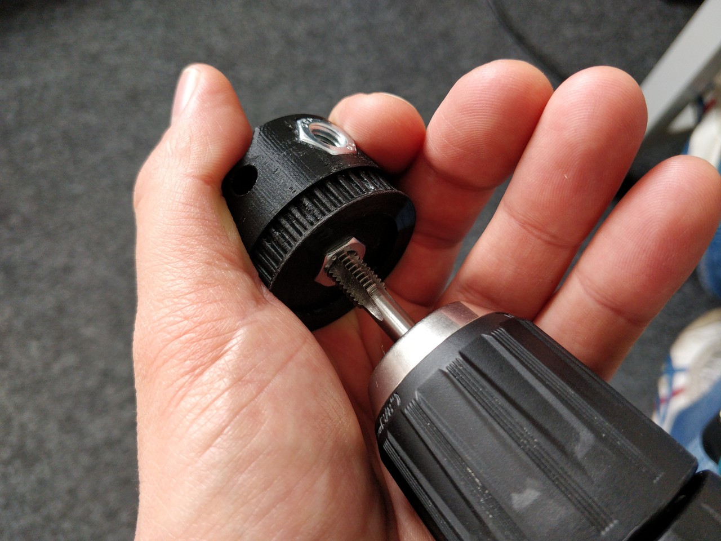
[picture p42: documentation/images/drill_threading_hip_part.jpg]


Turning bolts into threading holes should be moderately easy, otherwise check threading.
Again, always drill using the nut to assure a continouosly cutted threading.

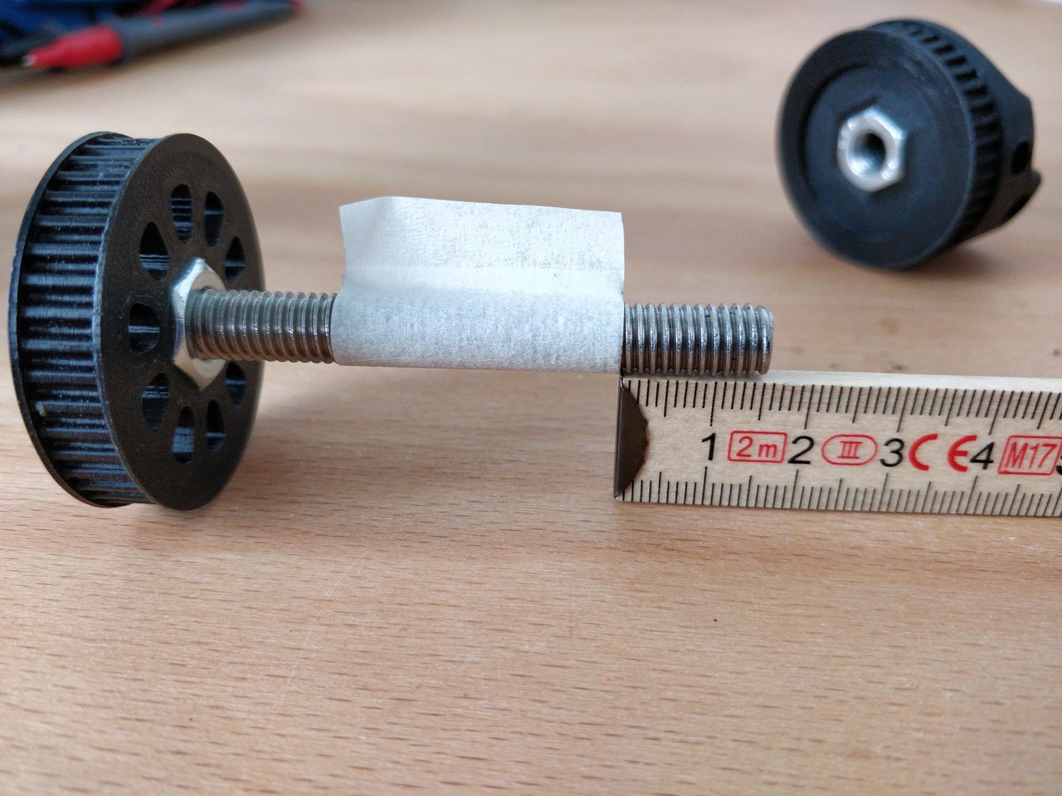
[picture p43: documentation/images/check_hole_depth.jpg]


The holes should be around 15 mm in depth. Check with the bolt and some removable tape for instance.

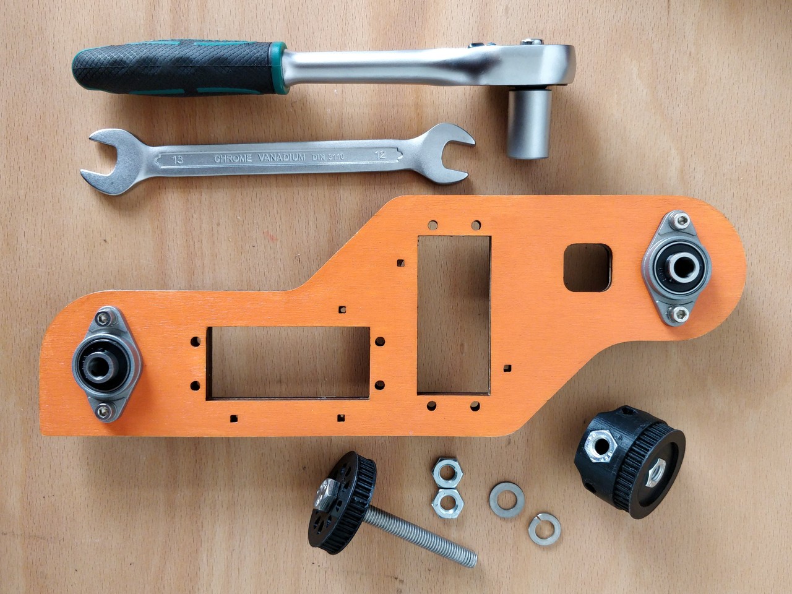
[picture p44: documentation/images/prepare_tools_workbench_hip_assembly.jpg]


Get all tools and parts ready for assembly.
Turn one of the nuts onto the bolt with the pre-assembled pulley and lock it to the nut in the hex pocket to form a solid connection with the bolt (locking nut).

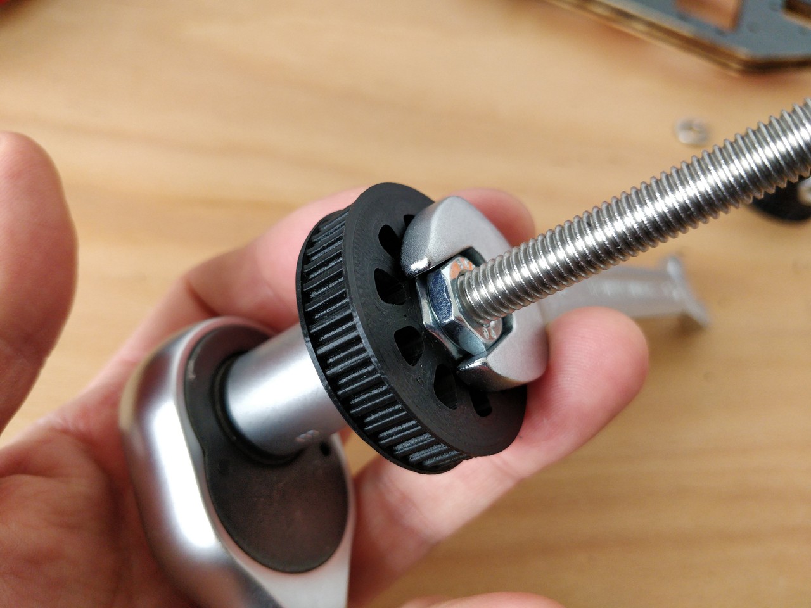
[picture p45: documentation/images/tighten_M8_nut_on_hip.jpg]


Insert the distance washer and thigh as depicted below and finally add the hip axel connector (also using a nut for locking).
The normal washer must be inserted to the outer side (lower profile) and the spring washer to the inner side. The spring washer is just for eating up the free space preventing play and should not be tensed. Check this with turning the axis, if it feels spongy then the spring washer is tensed too much.

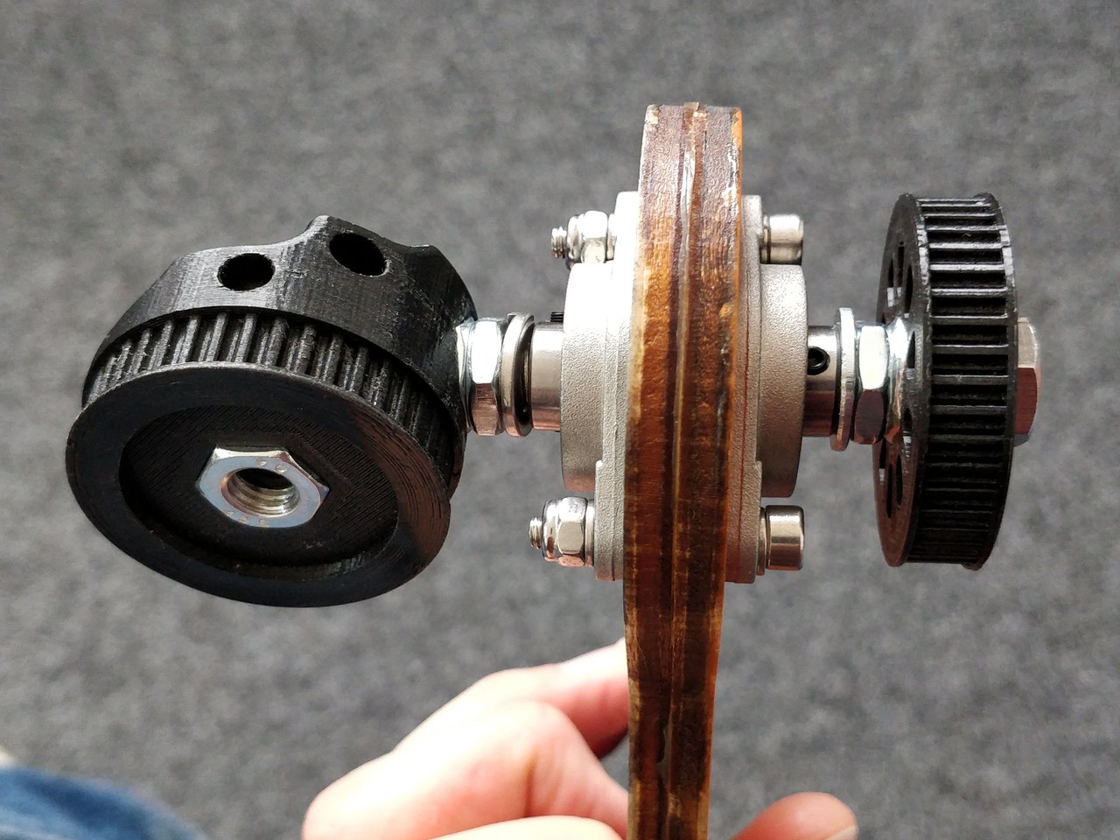
[picture p46: documentation/images/hip_result_using_washers_for_distance.jpg]


Repeat with the second hip accordingly.

=== Foot

=== Motors

Prepare workbench and get all the needed tools.

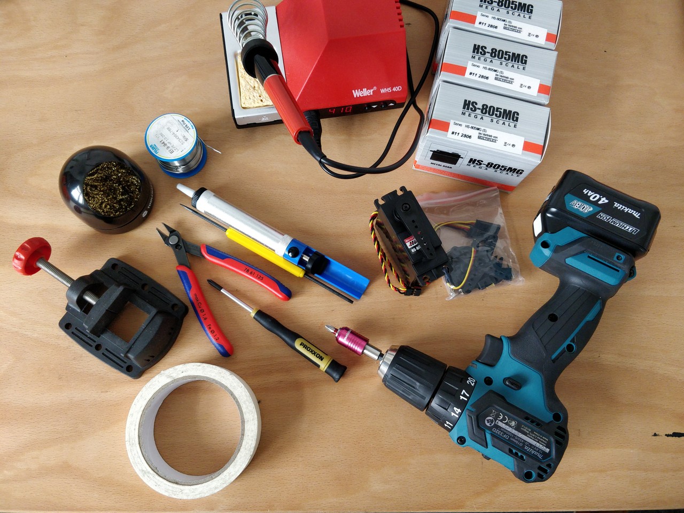
[picture p47: documentation/images/desolder_tools.jpg]


==== Remove servo controller.

See some videos for a quick overview. Read text and see images below for detailed step by step explanations on how to desolder the servo motors printed circuit boards and install the Sensorimotors.

video: https://www.youtube.com/watch?v=jpkWSJoK_m4[sensorimotor_assembly_01_removing_old_controller]

video::jpkWSJoK_m4[youtube]

video:  https://www.youtube.com/watch?v=5hQtV_ZHUZk[sensorimotor_assembly_02_desoldering_detail]

video::5hQtV_ZHUZk[youtube]

Secure the gearbox with some removable tape.

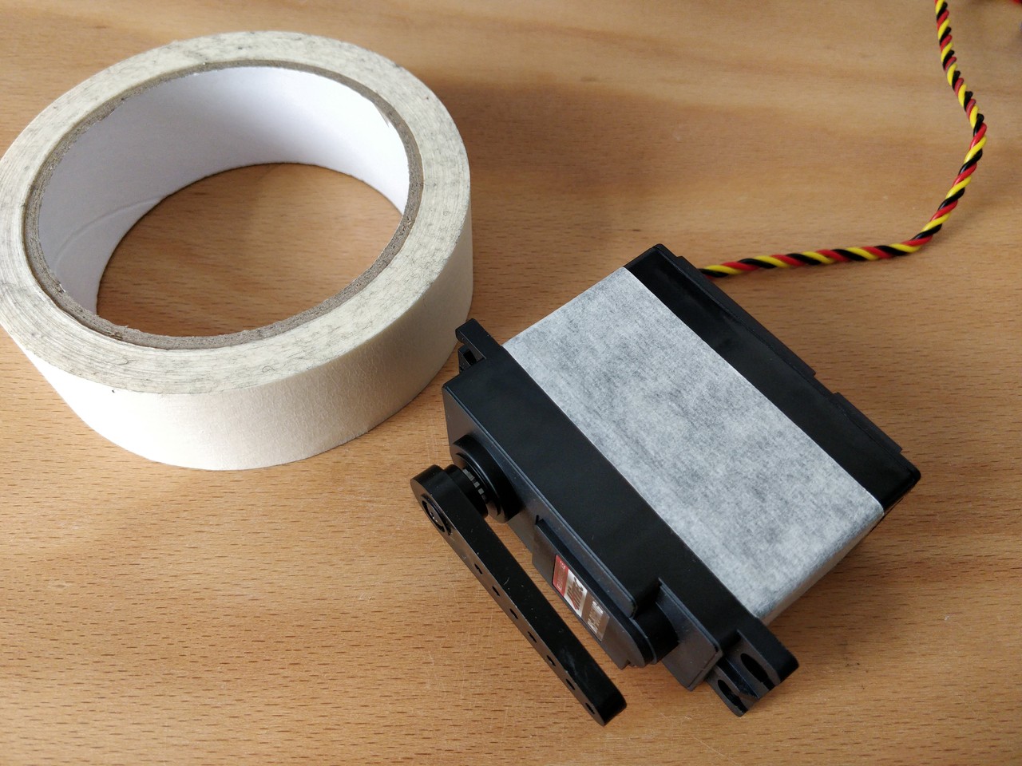
[picture p48: documentation/images/tape_motorbox.jpg]


Unscrew the six housing screws and remove the cover and keep the screws separately (we will need them later).

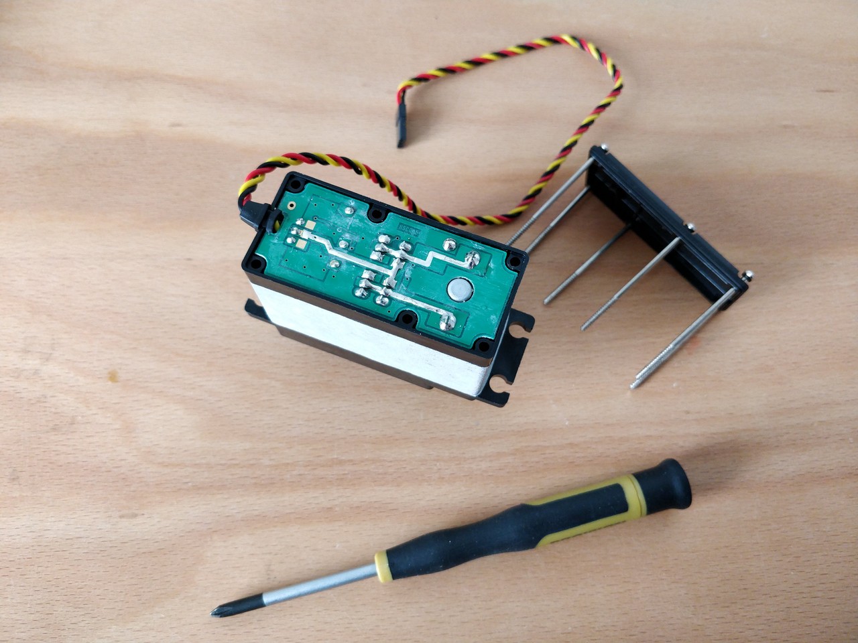
[picture p49: documentation/images/unscrew_motor_cover.jpg]


Stabilize the motor using a clamp or similar.
Use a desolder pump to remove solder from the motor pins.
Consider using a higher soldering temperature (e.g. 410°C) since the (power-)pads will sink a lot of heat. And depending on the soldering station/iron you are using this may drop the temperature on the tip of the iron a little below melting piont, and thus makes desoldering hard. We recommend to always add flux or add a little fresh solder (which has flux included) to make desoldering easier.

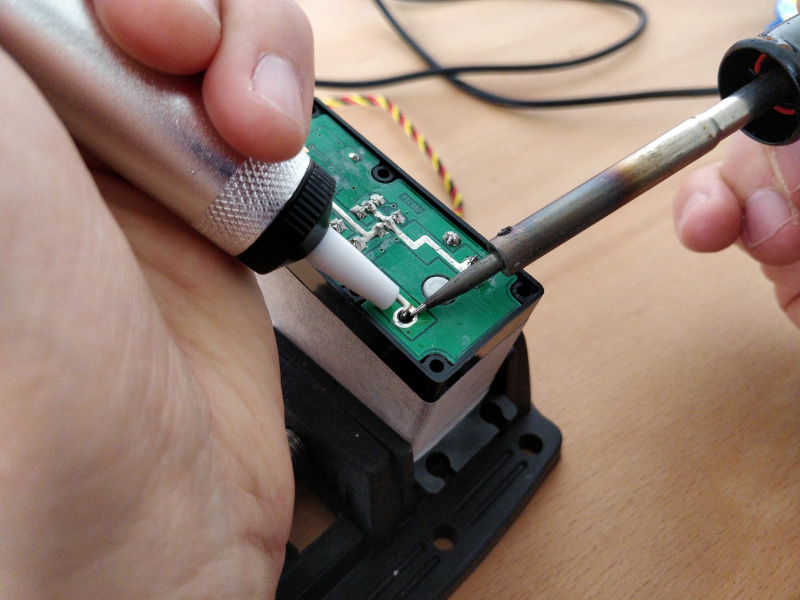
[picture p50: documentation/images/desolder_motorpins.jpg]

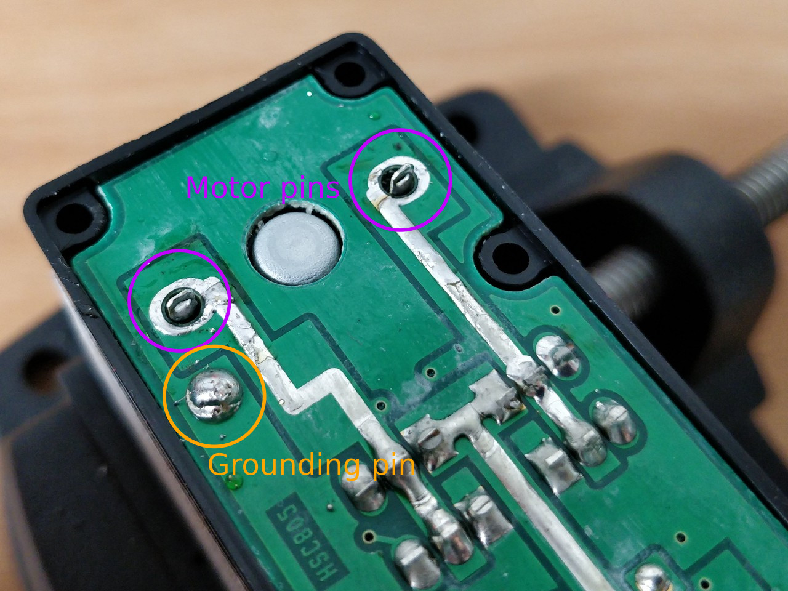
[picture p51: documentation/images/desolder_motorpins_result_commented.jpg]


Heat up the grounding pin and lift the board with a pointed tool while continuing heating. The grounding pin either remains at the motor case or on board side, no matter remove it or leave it for later use.
The grounding pin will sink excessive heat, so be patient and use enough heat and time to thoroughly melt the solder.

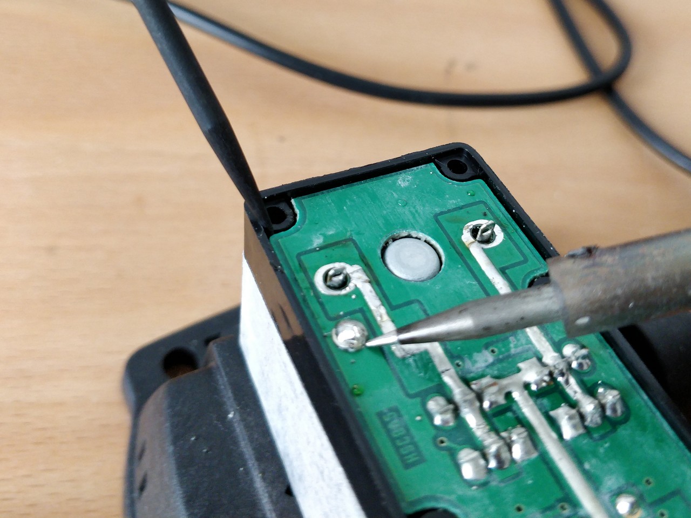
[picture p52: documentation/images/desolder_grounding_pins.jpg]


Cut the red, yellow and green cable very close to the boards and remove the board, be carefull the edges of the board may be hot due to heaten up ground layer which is going close to the edges.

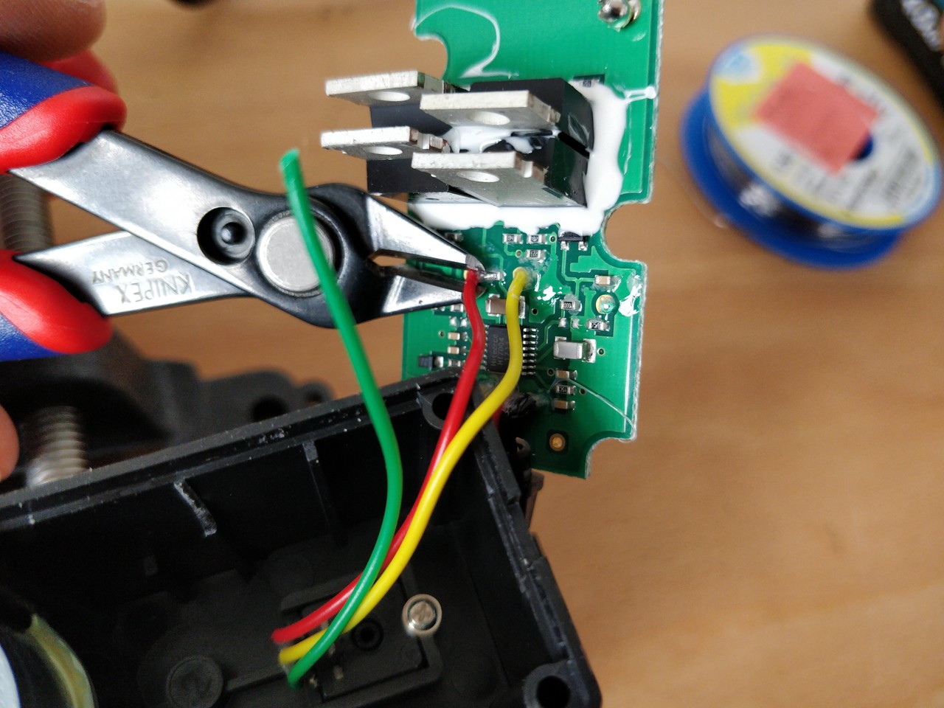
[picture p53: documentation/images/cut_cables_and_remove_board.jpg]


Remove any loose solder remainings carefully. Use vacuum cleaner if needed. Remove any loose glue remaining. Recycle or archive the boards, covers and accessoires, since we do not need them anymore. Keep the screws, will be needed later.

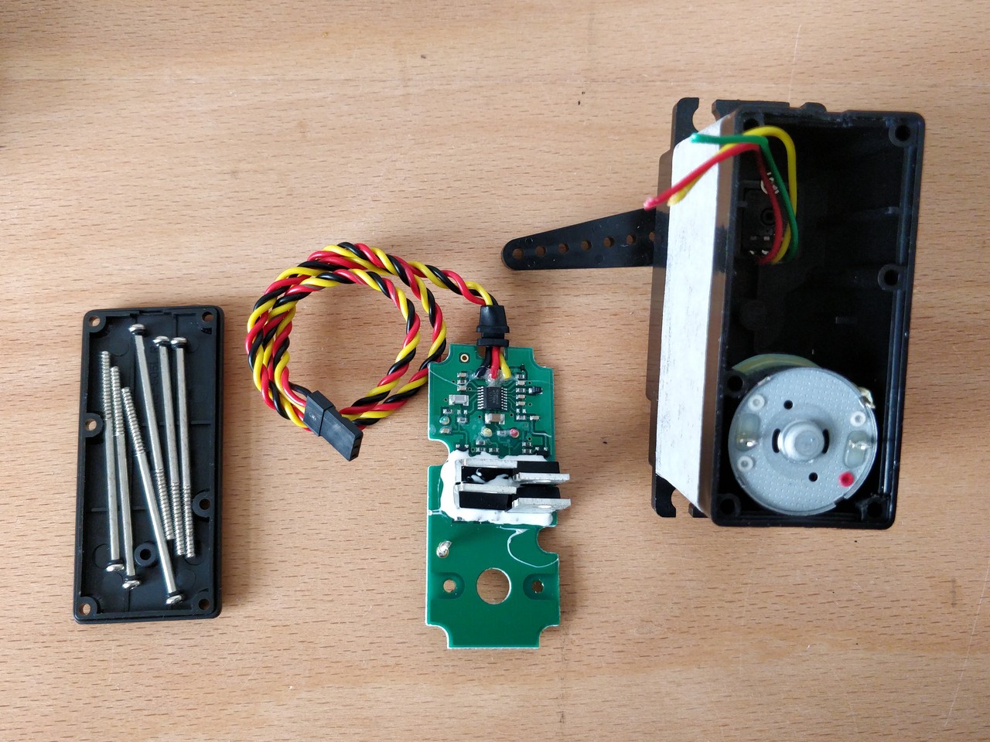
[picture p54: documentation/images/motorboard_removal_complete.jpg]


Repeat the process for all motors.

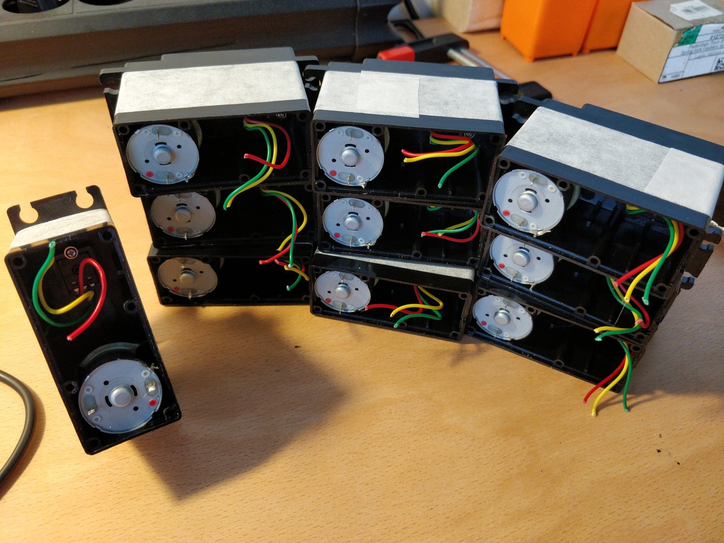
[picture p55: documentation/images/all_motors_ready.jpg]


==== Assemble Sensorimotor Board

video:  https://www.youtube.com/watch?v=D0k9pQJAyEo[sensorimotor_assembly_03_soldering_through_hole_parts]

video::D0k9pQJAyEo[youtube]

Get the 10 sensorimotor board and the through hole parts which need to be soldered.

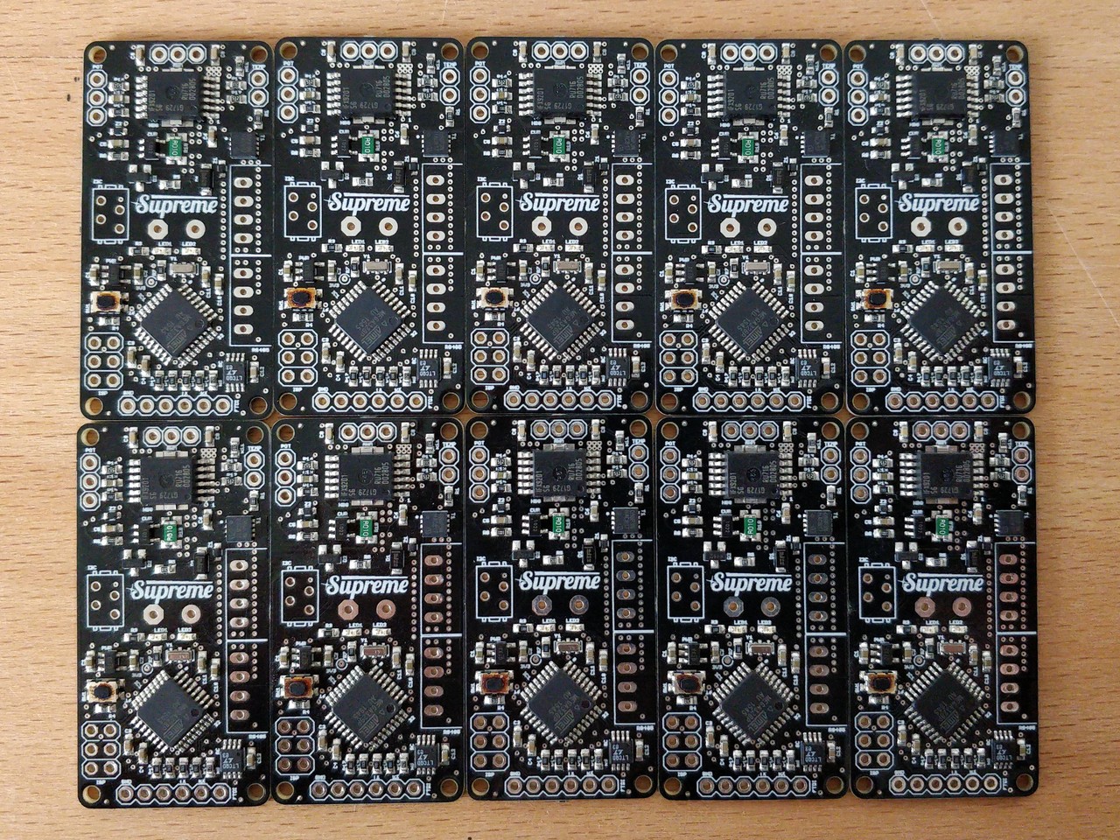
[picture p56: documentation/images/get_sensorimotors.jpg]

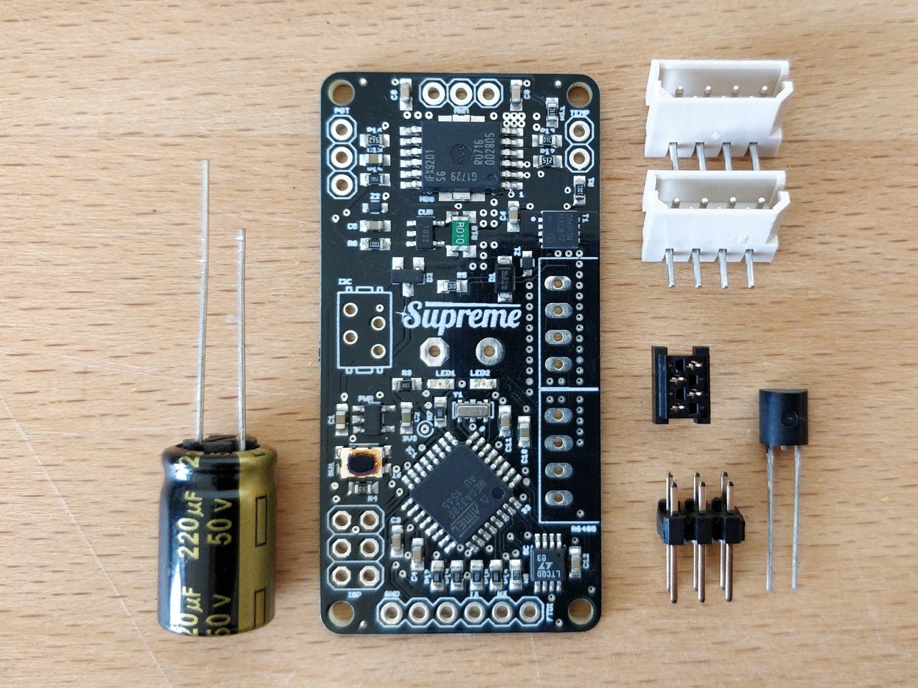
[picture p57: documentation/images/sensorimotor_through_hole_parts.jpg]


Get all the needed and recommended tools. Use a fine solder tip and thin solder for the best quality. Set solder temperature a little above recommended for compensating the heat sink due to power pads.

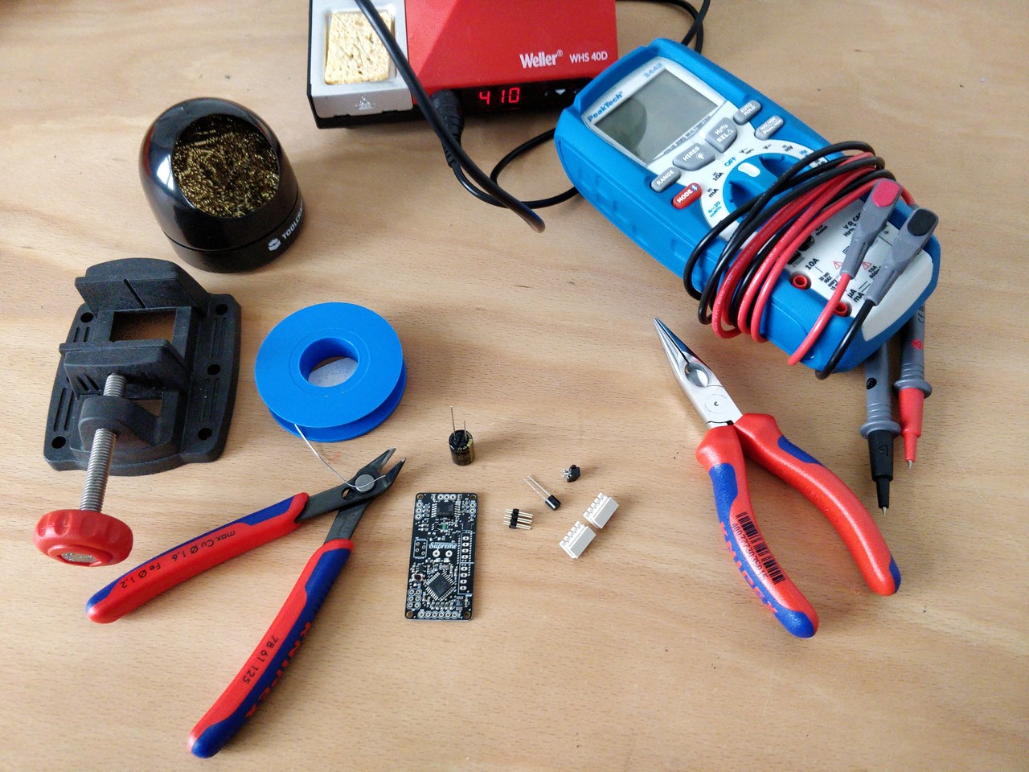
[picture p58: documentation/images/sensorimotor_tools_needed.jpg]

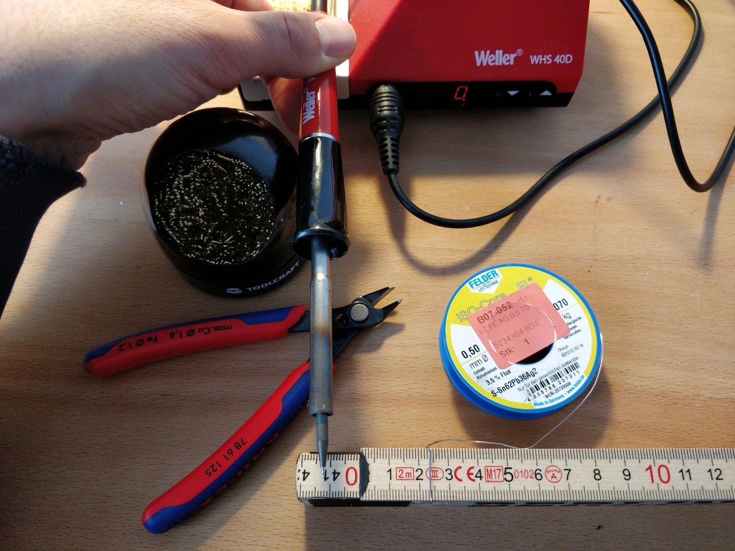
[picture p59: documentation/images/sensorimotor_recommended_solder_tools.jpg]

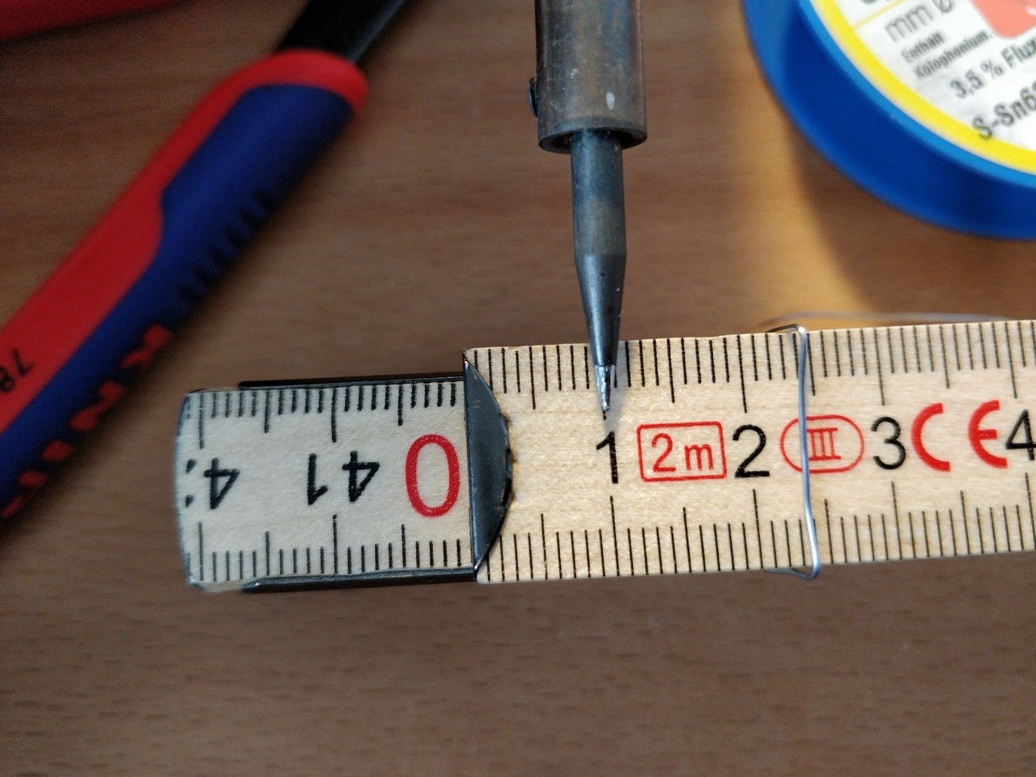
[picture p60: documentation/images/sensorimotor_recommended_fine_pitch_solder_tip.jpg]


Insert the Motorcord (RS485, 4-pin, white, rectangluar) sockets and the I2C connector (black) from top side and solder from bottom side. Check for clearly separated pins.

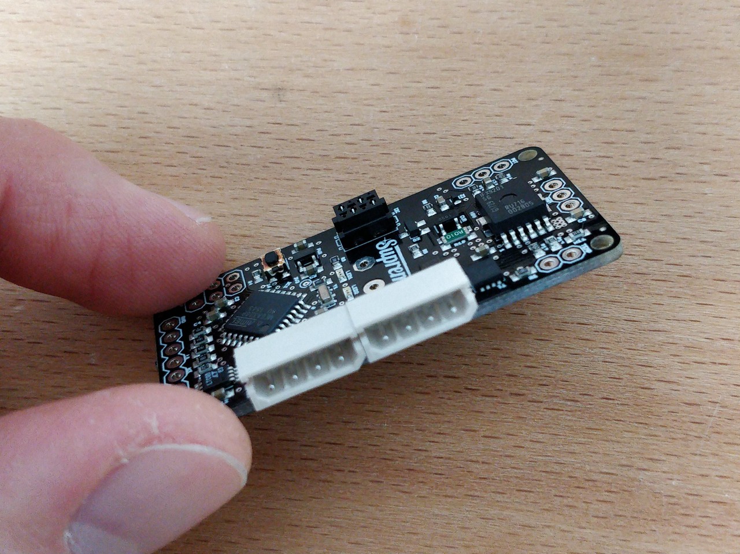
[picture p61: documentation/images/sensorimotor_insert_sockets.jpg]

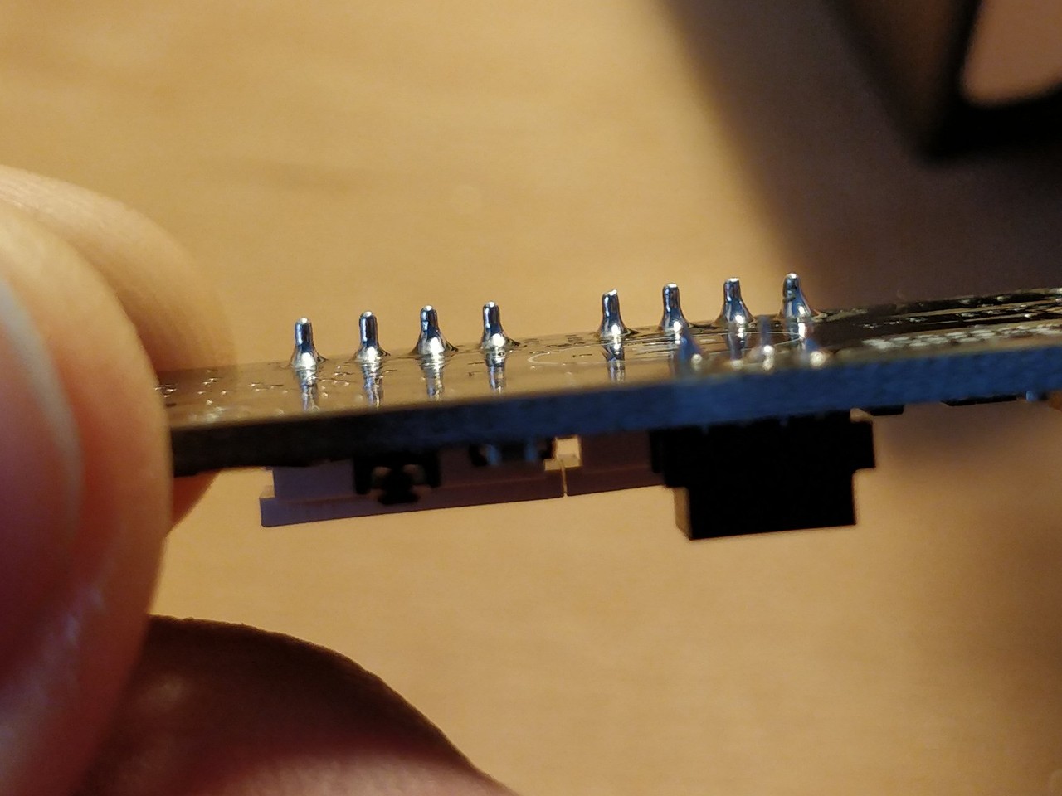
[picture p62: documentation/images/sensorimotor_check_solder_pins.jpg]


Insert and solder the ISP 6-pin header next. You can use the capacitor to balance the board.

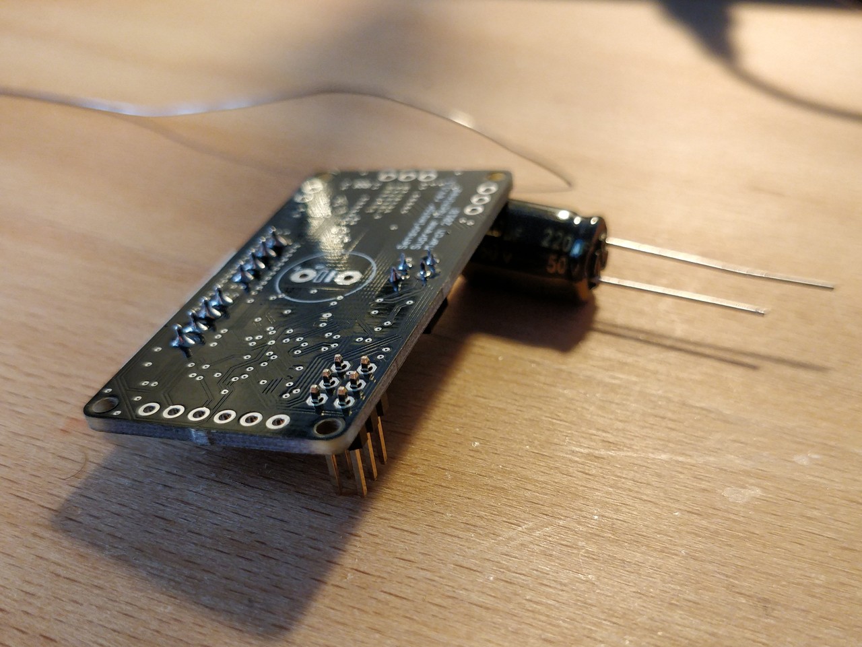
[picture p63: documentation/images/sensorimotor_solder_ISP_header.jpg]

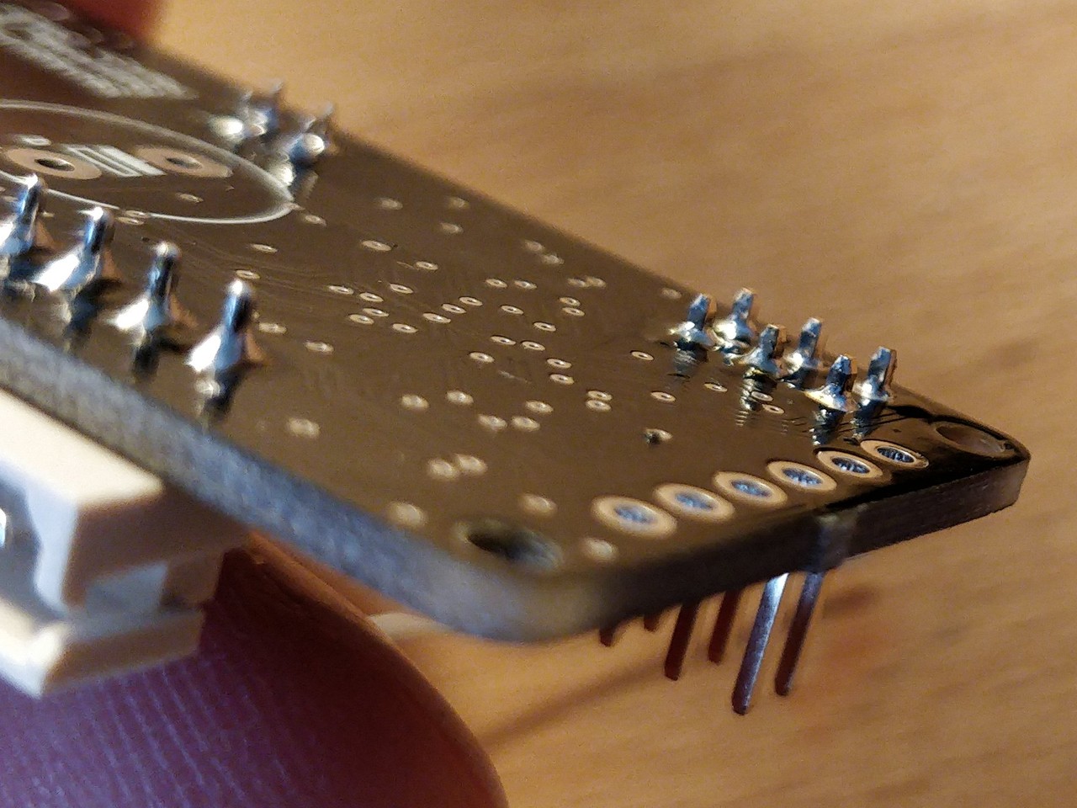
[picture p64: documentation/images/sensorimotor_check_ISP_pins.jpg]


Bend the two pins of the thermistor (TO92 housing) by 90 degrees and solder to the bottom of the board, the thermistor body should be placed left below the H-bridge with the flat side close to the surface.

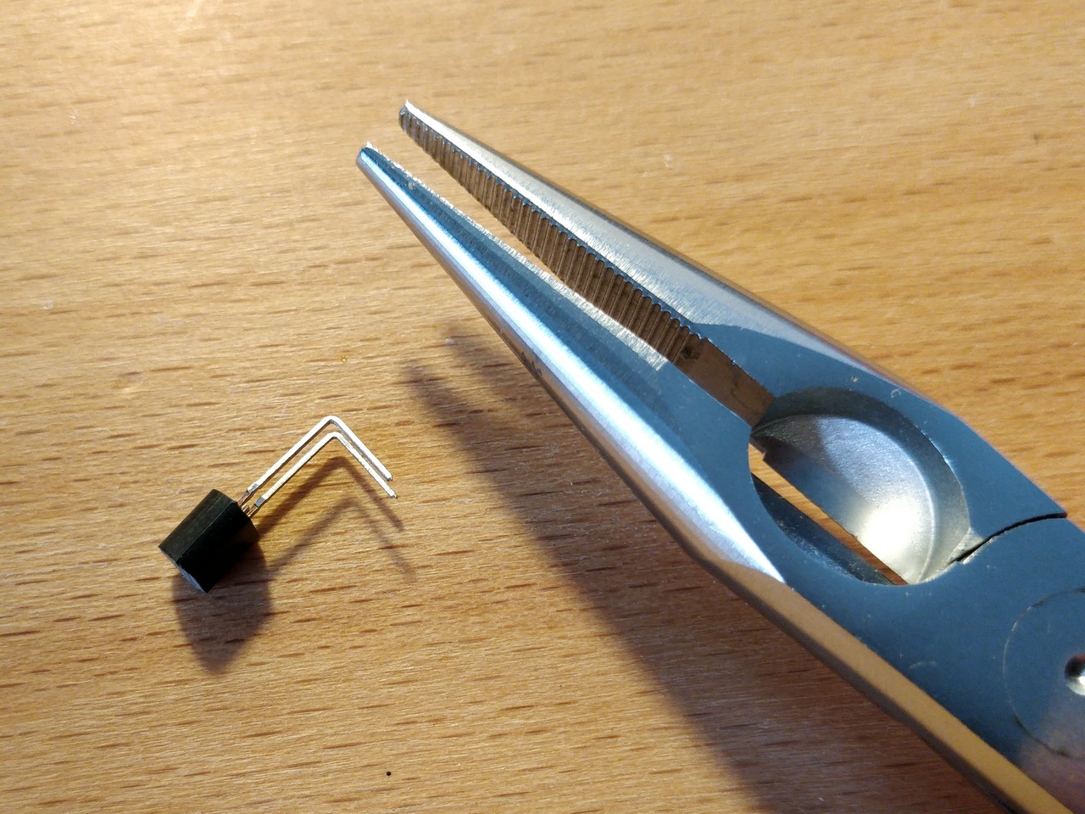
[picture p65: documentation/images/sensorimotor_bend_thermistor.jpg]

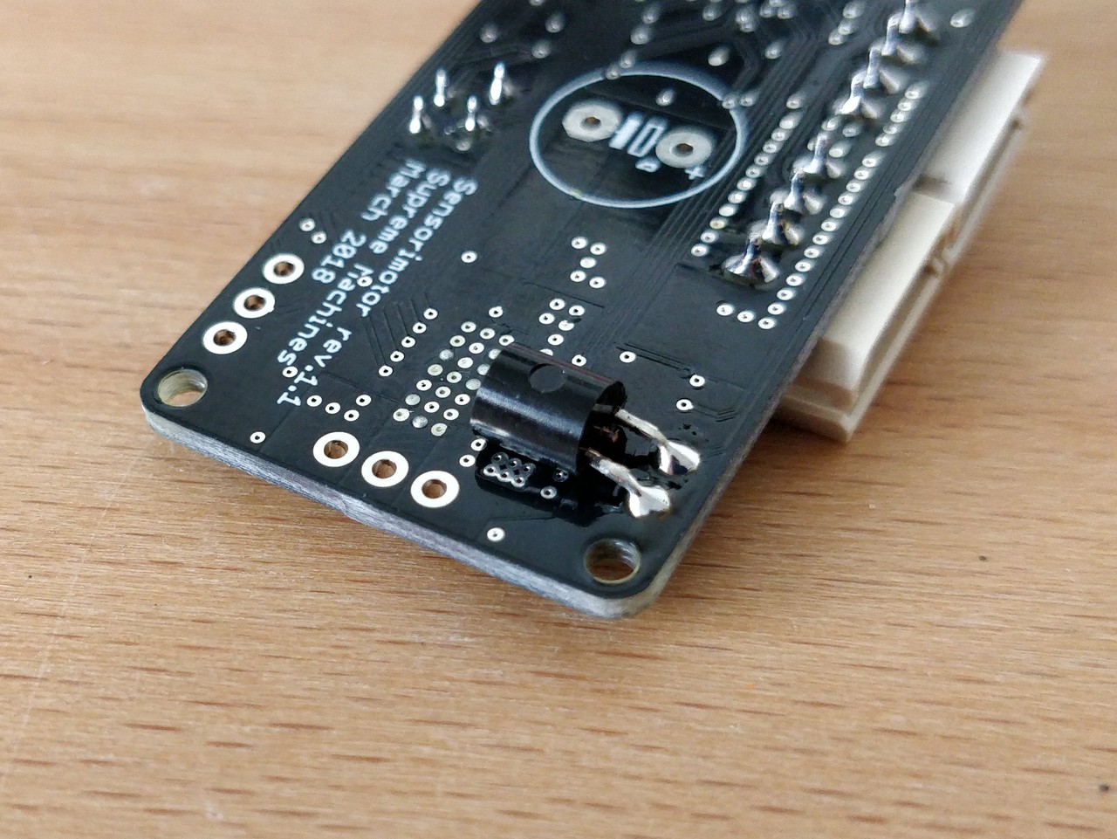
[picture p66: documentation/images/sensorimotor_solder_thermistor.jpg]


Insert the electrolytic capacitor from bottom side, check for correct polarity and solder. The negative (GND) pin will be sinking a lot of heat because it is directly connected to a large ground plane, be prepared for this taking some more seconds for the solder/pad to reach the melting temperature. Cut/remove the remaining material close to the board

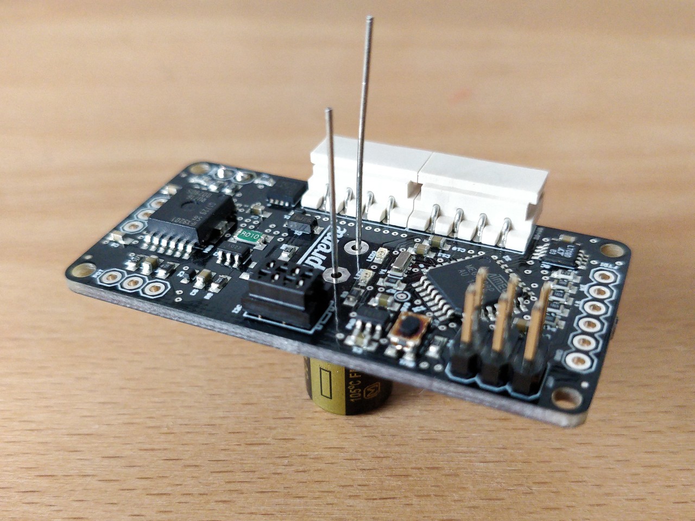
[picture p67: documentation/images/sensorimotor_insert_polarized_capacitor.jpg]

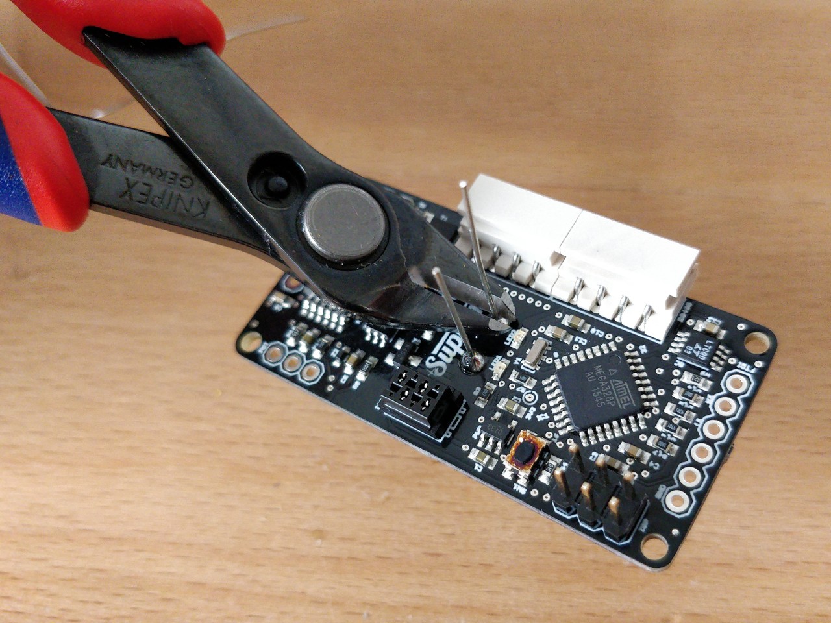
[picture p68: documentation/images/sensorimotor_remove_remaining_pin.jpg]


Repeat the process for all sensorimotor boards.

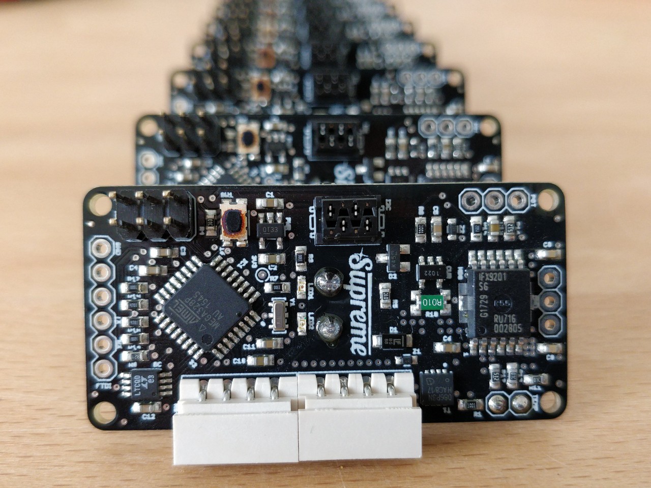
[picture p69: documentation/images/sensorimotor_ready_1.jpg]


==== Installing Sensorimotor into Servo

video:  https://www.youtube.com/watch?v=W5wTd_JIoqk[sensorimotor_assembly_04_prepare_cover]

video::W5wTd_JIoqk[youtube]

video:  https://www.youtube.com/watch?v=vMh9dKeaUrc[sensorimotor_assembly_05_installing board]

video::vMh9dKeaUrc[youtube]

Get all the tools and prepare workbench for installation.

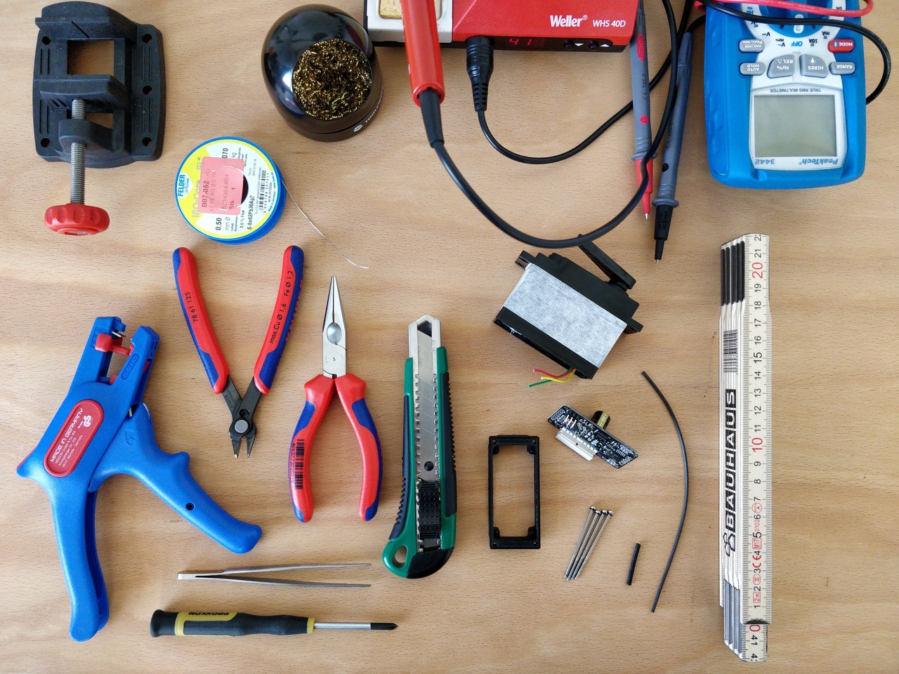
[picture p70: documentation/images/tools_for_installing_sensorimotor.jpg]


Check if cover fits to the servo box, remove any remaining support material or grain. Check if Sensorimotor board fits into cover frame.

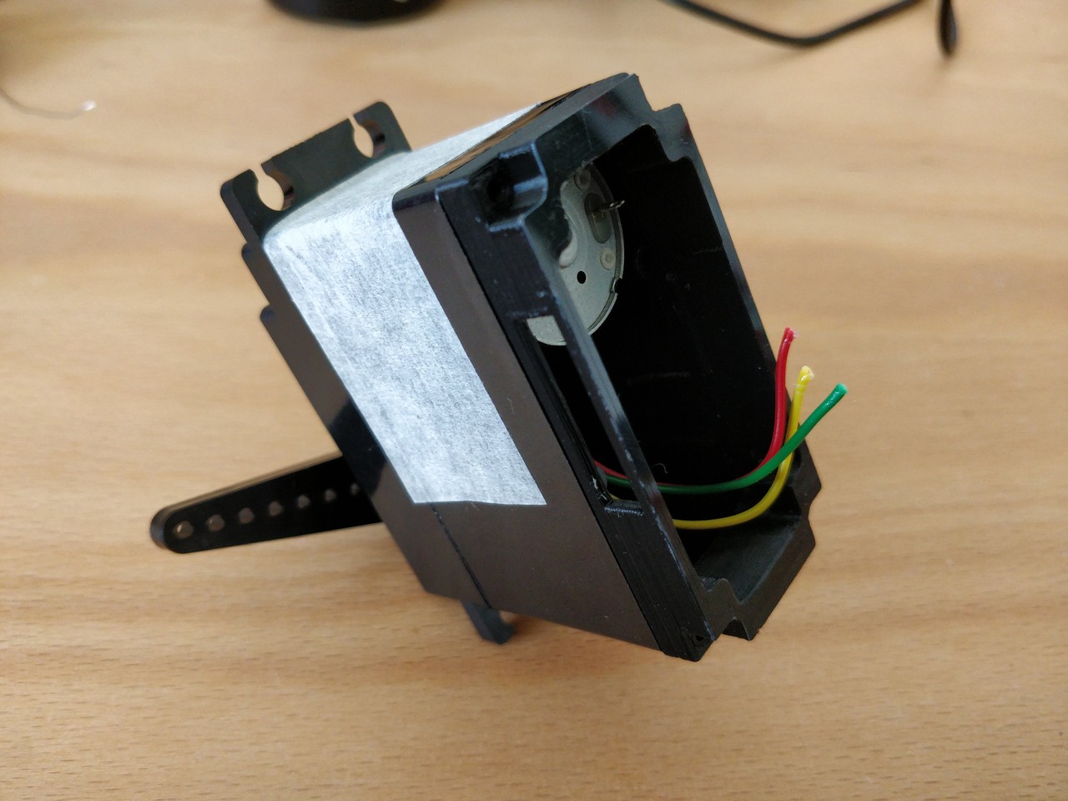
[picture p71: documentation/images/check_cover_fits_on_motorbox.jpg]

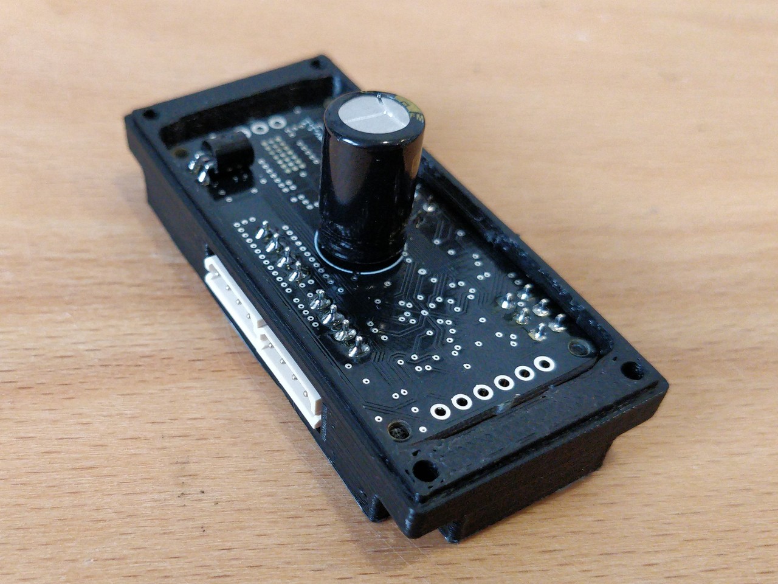
[picture p72: documentation/images/check_sensorimotor_fits_into_cover.jpg]


Strip the wires of the potentiometer, twist/focus the wires' ends with your finger tips and pre-solder the wires to best fit into solder holes.

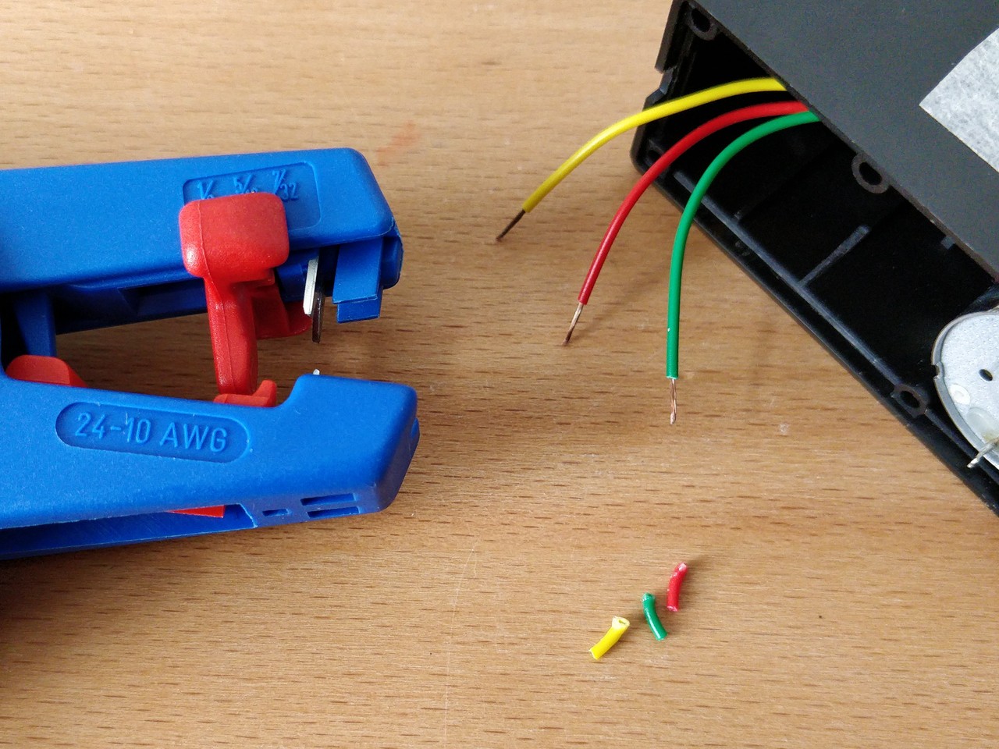
[picture p73: documentation/images/strip_wires_of_potentiometer.jpg]

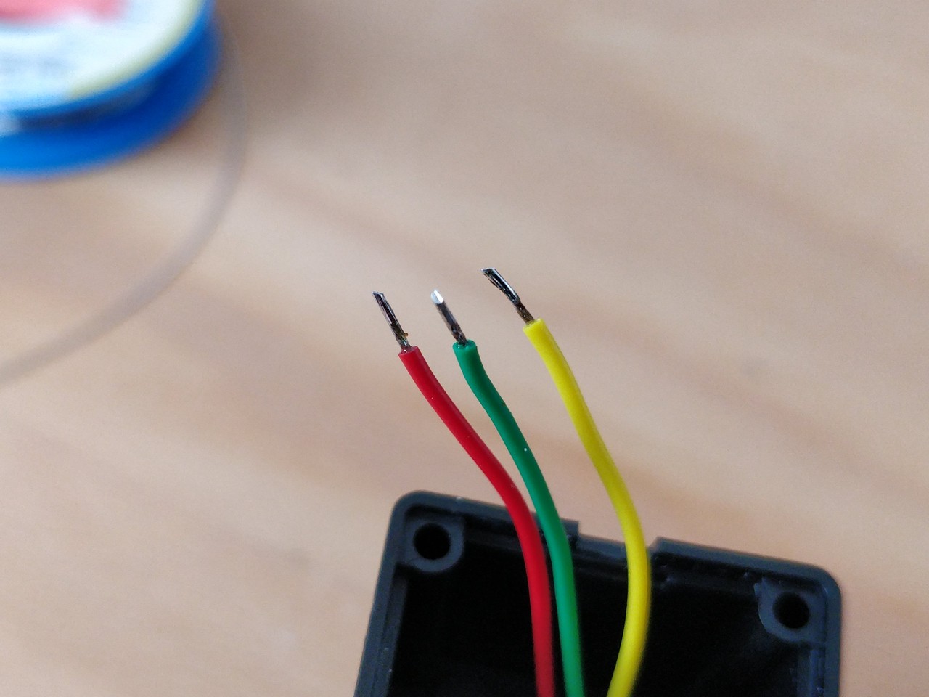
[picture p74: documentation/images/potentiometer_wires_pre-soldered.jpg]


Solder potentiometer pins in the shown order! Be careful, the cables' isolation may melt (and then retract) quickly. Cut the cables' ends close above the board.

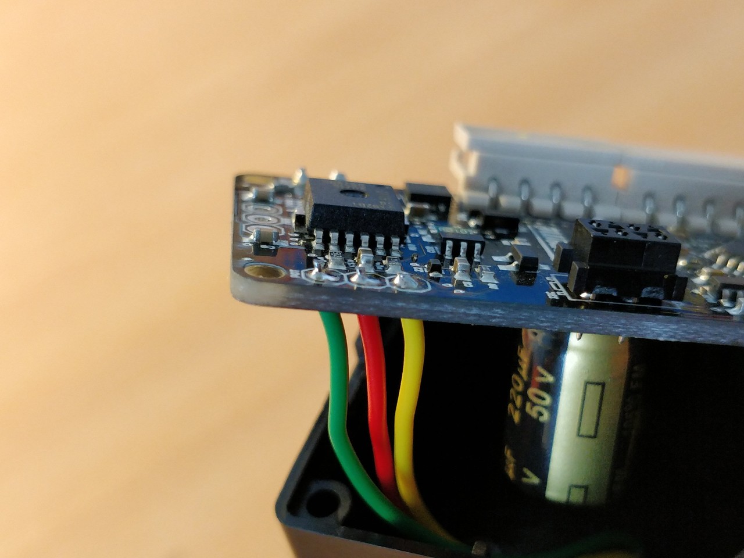
[picture p75: documentation/images/solder_potentiometer_pins.jpg]


Cut, strip and pre-solder the motor wires, approximately 5cm each.

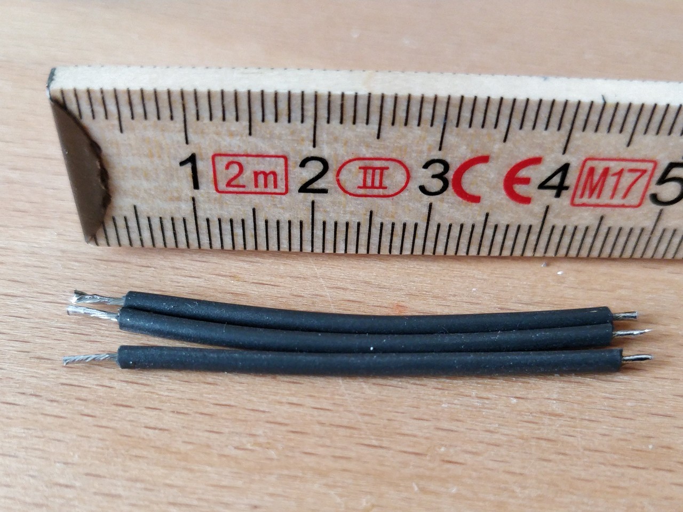
[picture p76: documentation/images/motor_wires_5cm.jpg]


Solder the motor wires and the grounding cable in the shown order. Soldering the ground cable to the motor shielding is sinking much heat, this will probably require to give your soldering station a boost (e.g. I use to solder this cable with 450°C).
Attention: We recommend to use shrinking tubing to isolate the motor pins here, since the cables will be very close to each other and short circuits are otherwise very likely.

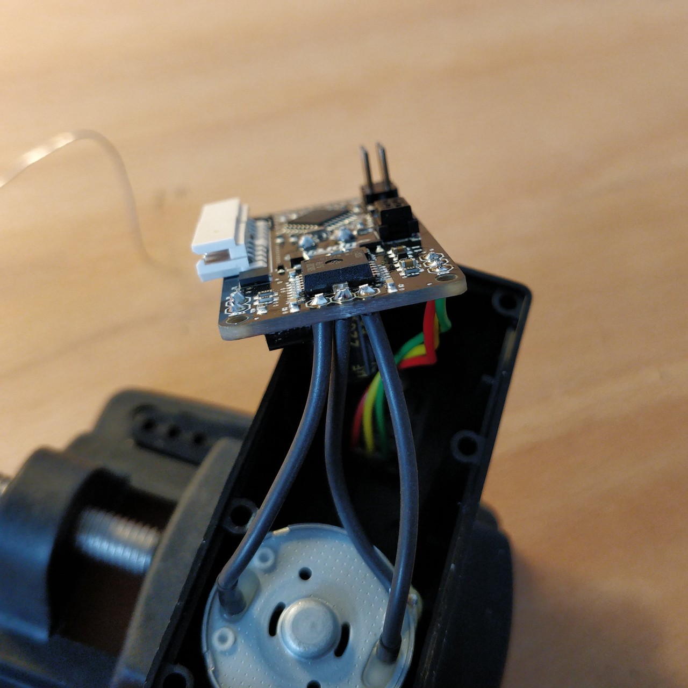
[picture p77: documentation/images/solder_motor_wires.jpg]


Bend the motor wires carefully to fit below the board and push down the cables, check if everything will fit.

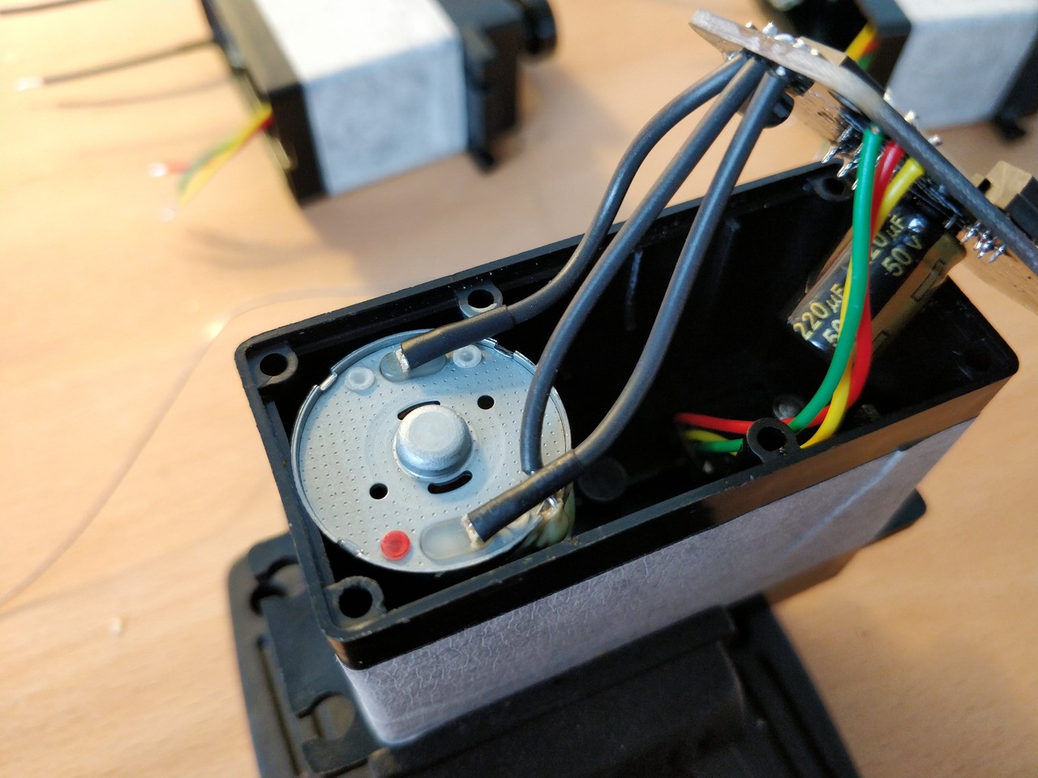
[picture p78: documentation/images/bend_motor_wires.jpg]

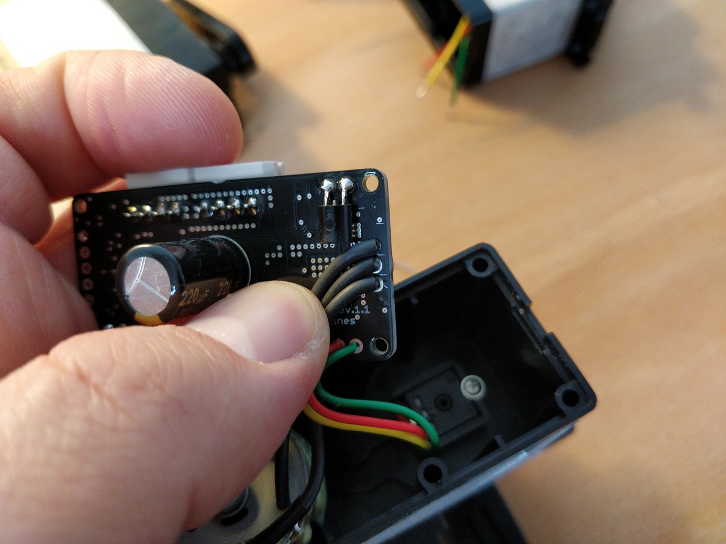
[picture p79: documentation/images/bend_motor_wires_2.jpg]

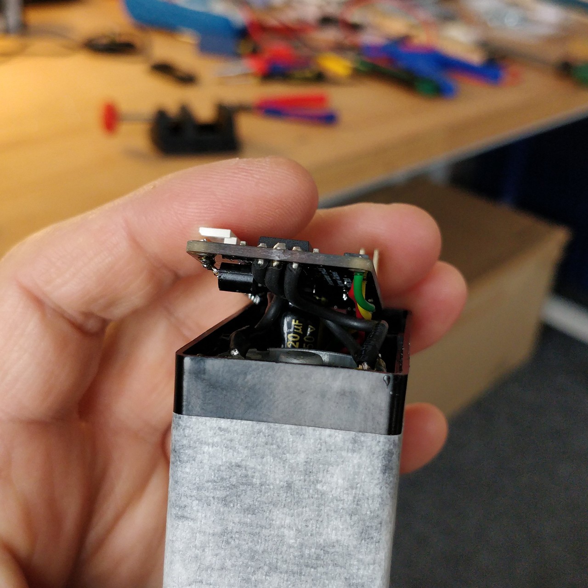
[picture p80: documentation/images/push_down_cables_carefully.jpg]


Mount the 3D-printed plastic cover on the boards and install the screws.

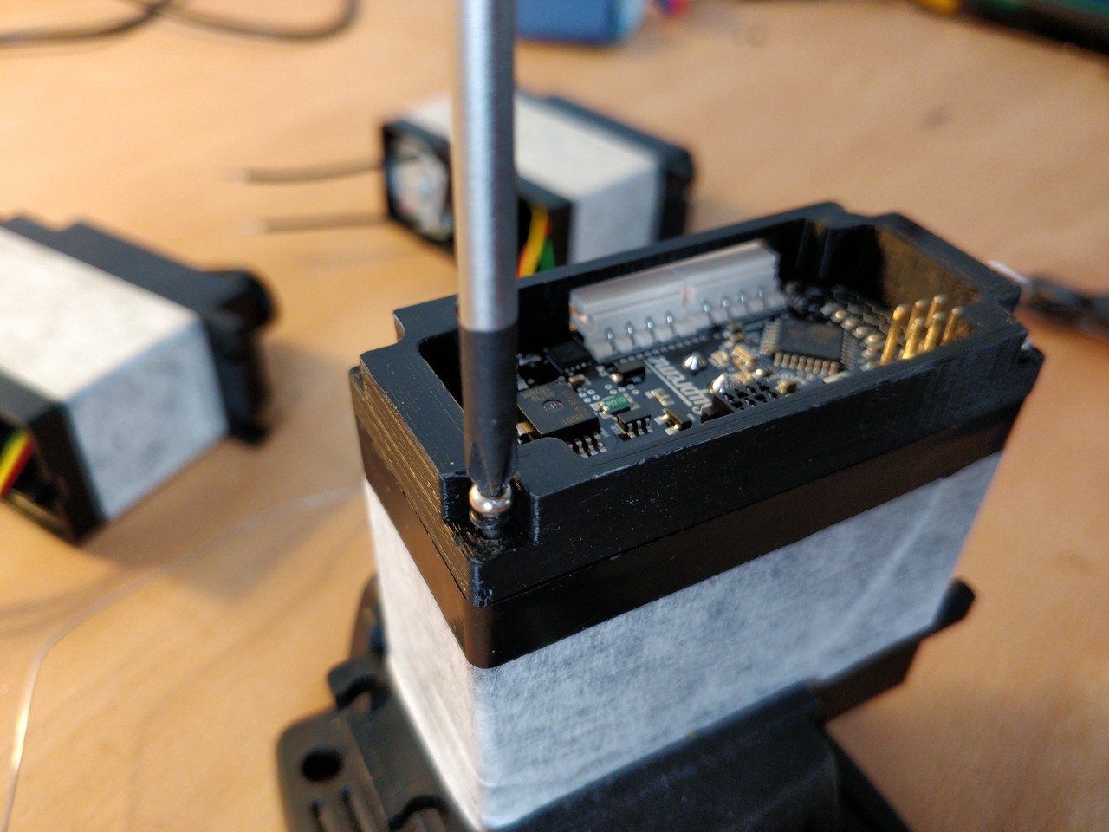
[picture p81: documentation/images/mount_cover_to_motorbox.jpg]


This is how the motor should look like when fully assembled.

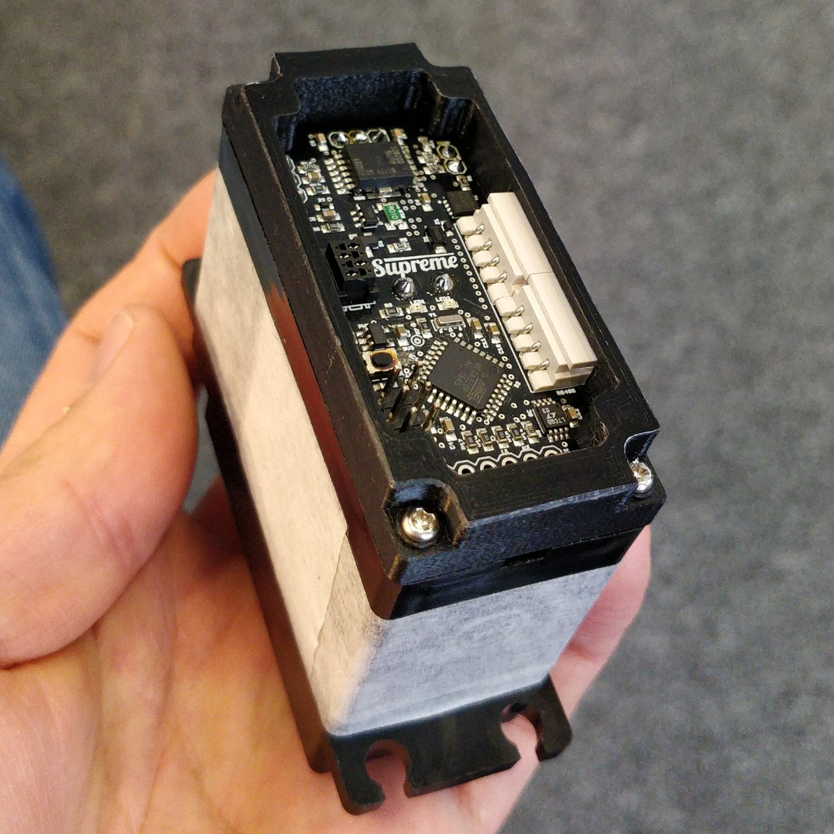
[picture p82: documentation/images/sensorimotor_fully_assembled_with_servo.jpg]


Use the multimeter to check for potential short circuits on every recently soldered connections visible from the top side (i.e. check resistance, most devices will bleep when there is no sufficient resistance.) Between the motor connections there should be a low resistance, since you checking for the motor coil. All other connections must be free of short circuits.

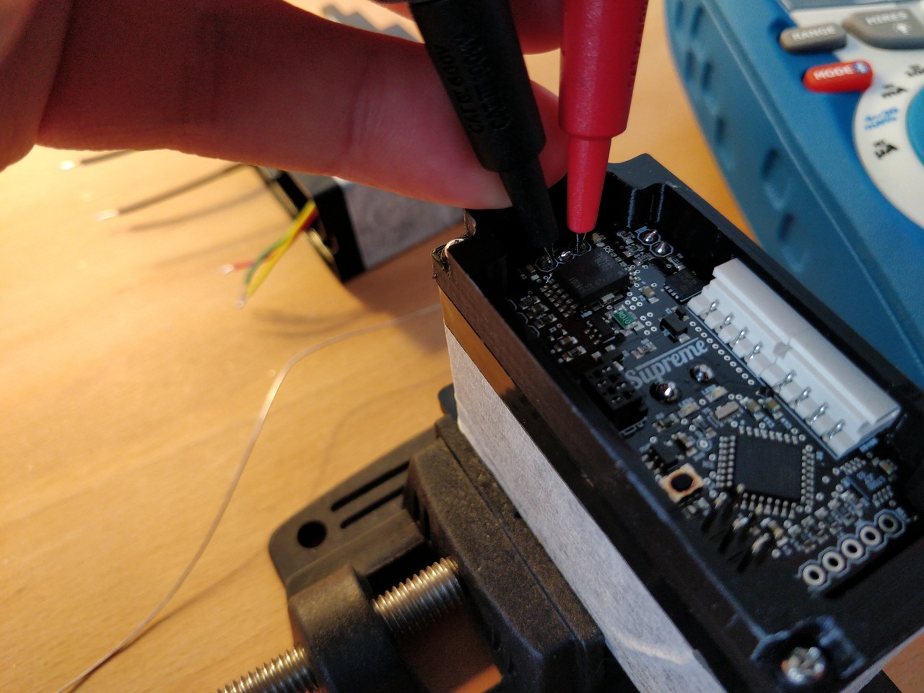
[picture p83: documentation/images/shortcircuit_check.jpg]


Repeat the process for the rest of the motors.

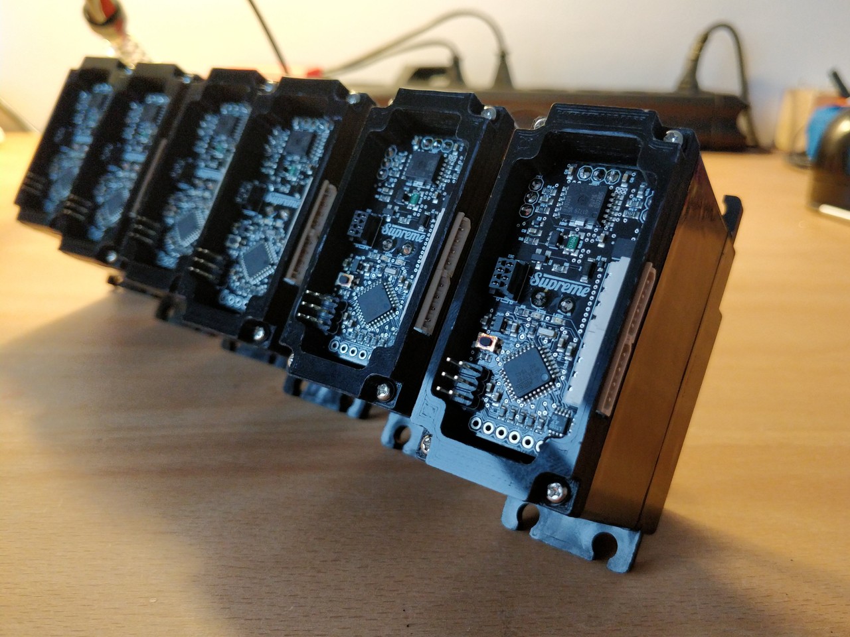
[picture p84: documentation/images/sensorimotors_finished.jpg]


Get some labels with the motors' IDs and put them on each individual motor.

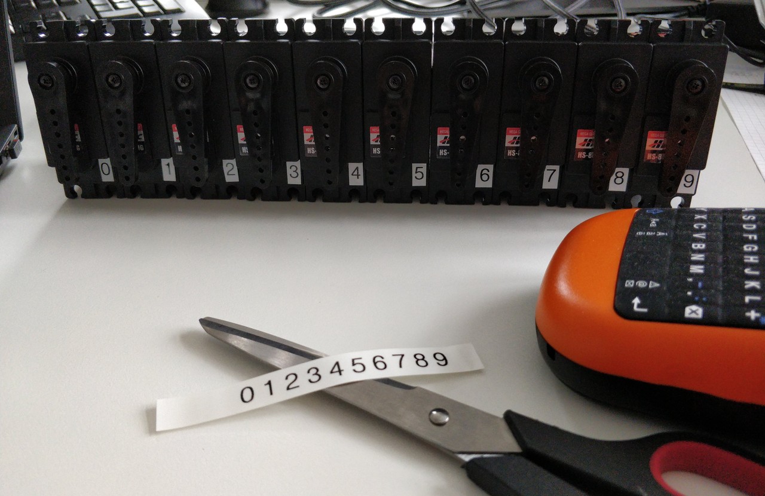
[picture p85: documentation/images/label_motor_ids.jpg]


=== Flashing Firmware
How to flash the motors firmware is described best on the projects website link:http://sensorimotor.de[Sensorimotor.de].

You will need a flasher tool for AVR processors. E.g. from
link:https://www.reichelt.de/usb-isp-programmer-for-all-avr-controllers-diamex-all-avr-p110345.html[Diamex]

If you dont have a flasher tool available you can create one yourself by utilizing an Arduino, this is called Arduino ISP. There are several tutorial out there showing you how to do that.
Arduino ISPs can also be link:https://store.arduino.cc/arduino-isp[bought].

Firmware of Sensorimotor boards is flashed in two steps, assuming no firmware was ever installed, otherwise it is only the second step.

*Step 1:* Flash the initial basic blink program and set the fuses.
----
cd blinky
make
make install
----

*Step 2:* Flash the most recent firmware:
----
cd Firmware
scons program
----

video:  https://www.youtube.com/watch?v=vXhYqfAI-04[sensorimotor_assembly_06_test_and_setting_fuses]

video::vXhYqfAI-04[youtube]

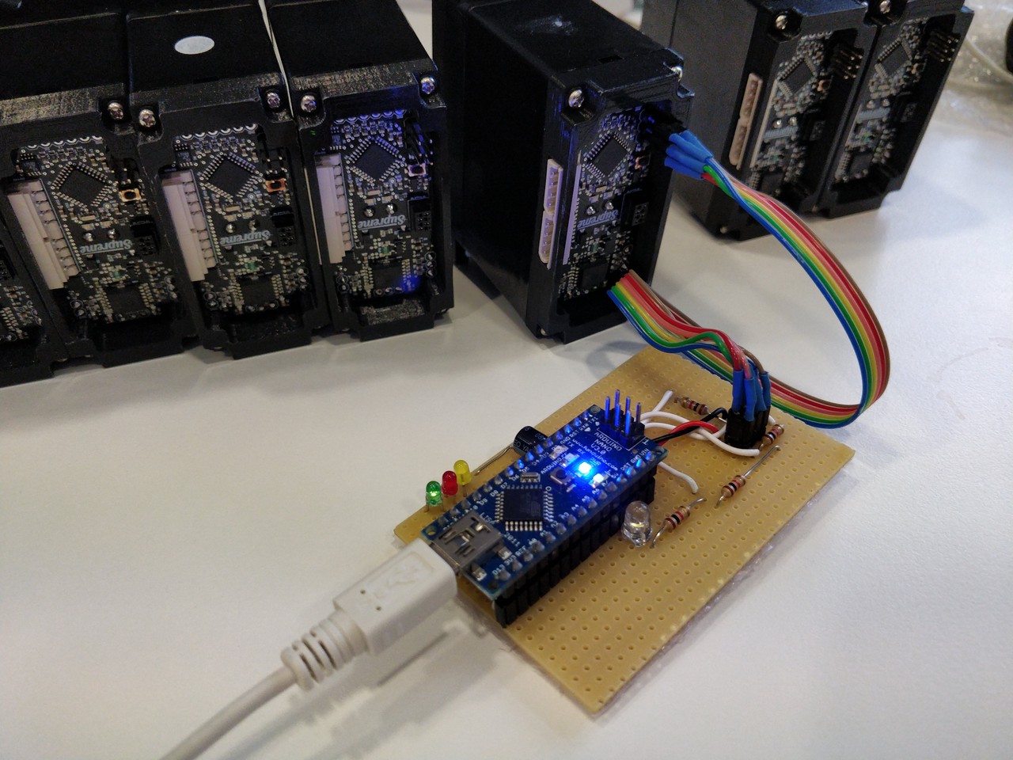
[picture p86: documentation/images/sensorimotor_flashing_firmware.jpg]


=== Setting Motors IDs

Get the tools and cables needed to set the motors's IDs.

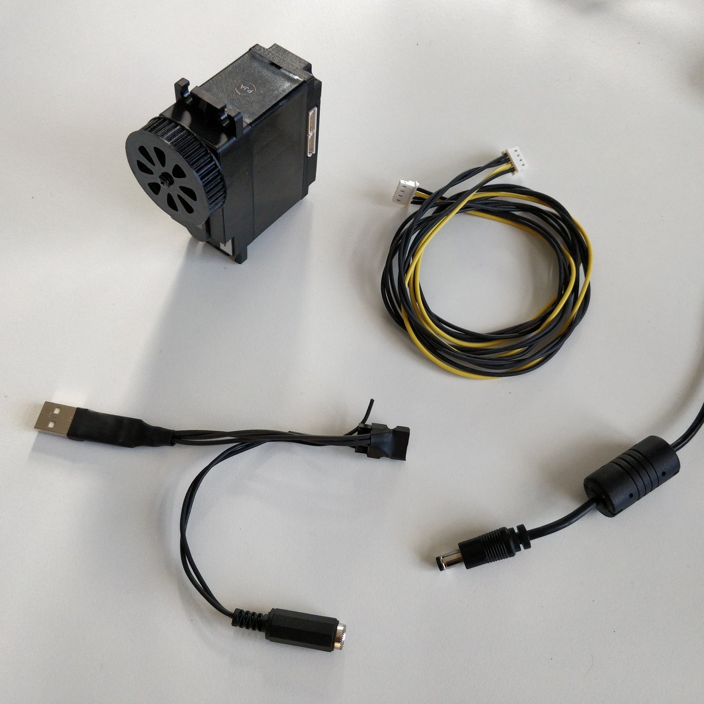
[picture p87: documentation/images/tools_for_setting_motor_id.jpg]


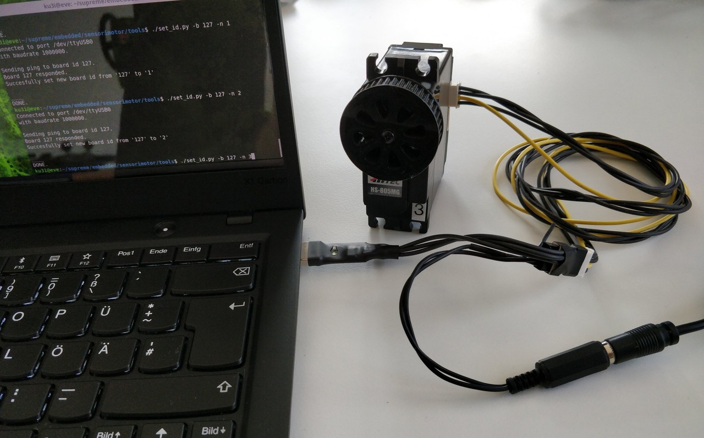
[picture p88: documentation/images/connect_interface_for_pc_motor_com.jpg]


To set the motors IDs connect motors to the RS-485-to-USB adapter, one after another, each motor separately. Go to the tools directory and find the python script called `set_id.py`.

Run the python script
....
python set_id.py
....
in any terminal or
....
./set_id.py
....
in your Linux shell to scan for motor ids. Motors which do not yet have an ID set are set by default to `127`.
To set a motor's ID, specify the board number with `-b 127`, (127 in case the motor was never given an ID or firmware was updated and ID erased) and specify new ID `-n 7` e.g. if you desired new motor ID shall be `7`

....
./set_id.py -b 127 -n 7
....

video: https://www.youtube.com/watch?v=aV9UtVvDbz4[sensorimotor_assembly_08_setting_individual_motor_ids]

video::aV9UtVvDbz4[youtube]

Repeat for all motors and finally check if all IDs were successfully set.

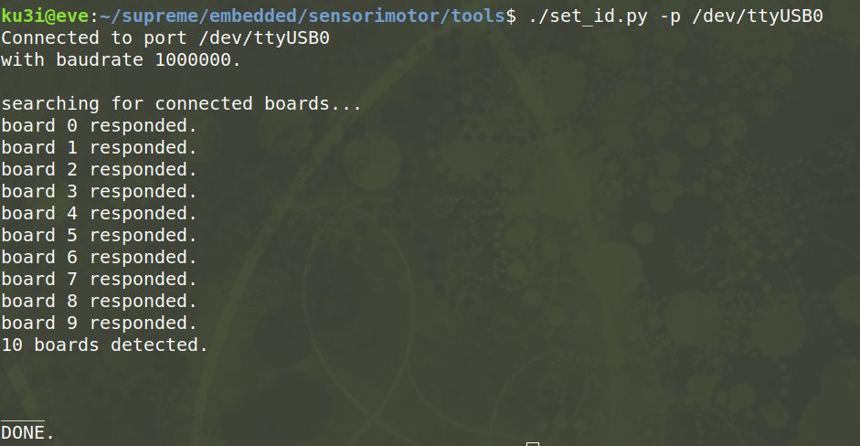
[picture p89: documentation/images/motors_respond_to_ping.png]


video: https://www.youtube.com/watch?v=CWDaAJ0dNk8[sensorimotor_assembly_09_checking_all_motors_ids]

video::CWDaAJ0dNk8[youtube]

=== Assemble the Legs

Get all the tools and parts.

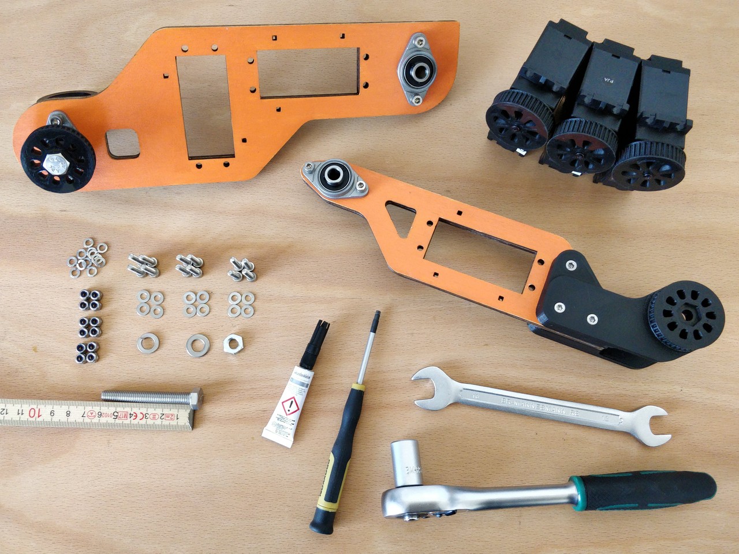
[picture p90: documentation/images/parts_and_tools_for_leg_assembly.jpg]


It is important that all remaining glue is removed and that the motor holes are clean and even to have the motor best fit into it.

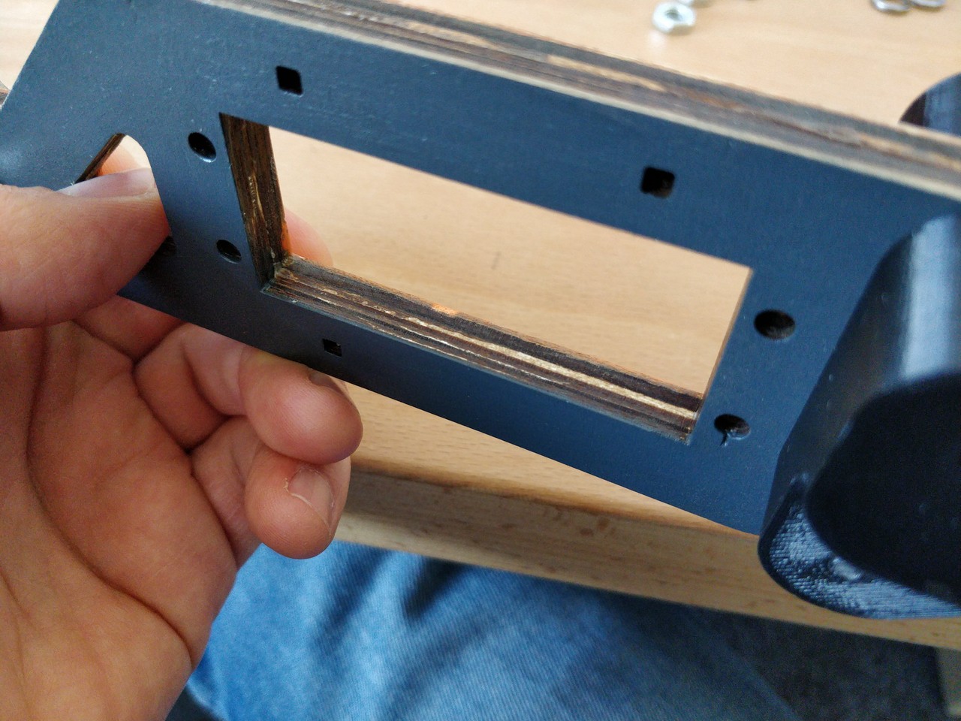
[picture p91: documentation/images/remove_remaining_glue_from_servo_hole.jpg]


Insert hex nut same as before, use a clamp or exress glue.

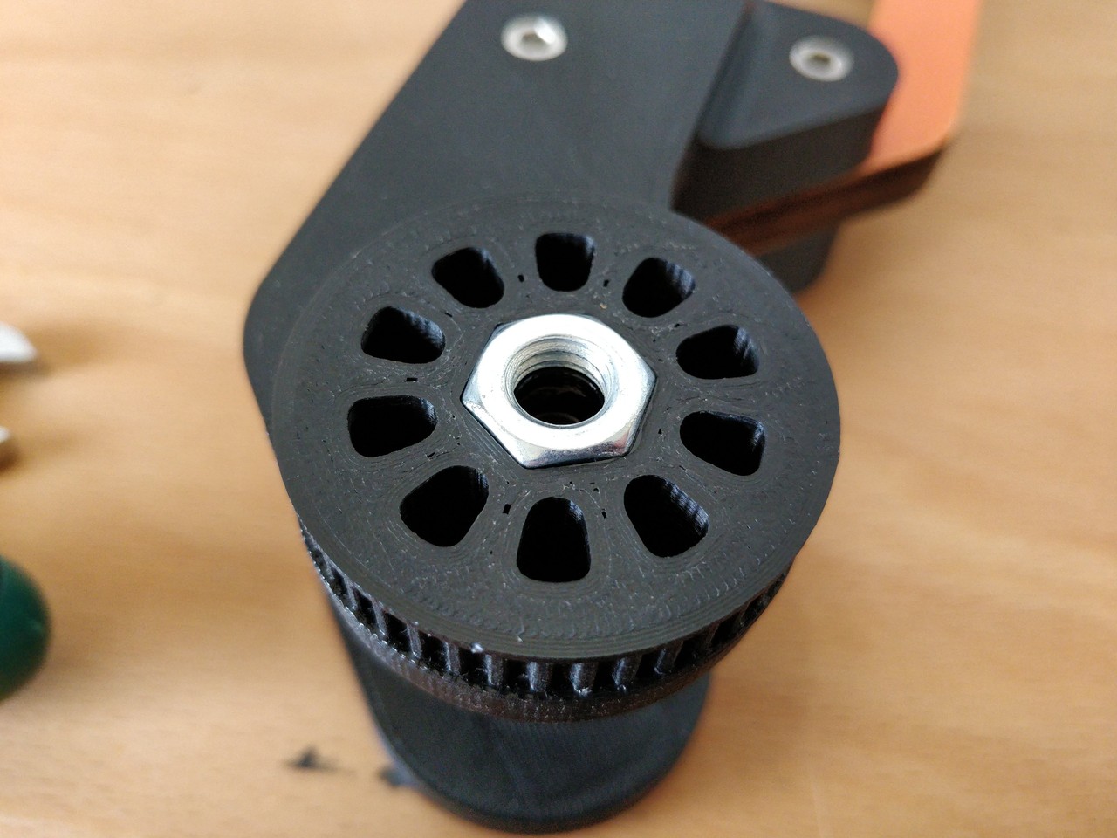
[picture p92: documentation/images/insert_nut_into_knee_pulley.jpg]


Cut the threading same as before using the hex nut. Test the threading with the 60mm M8 bolt.

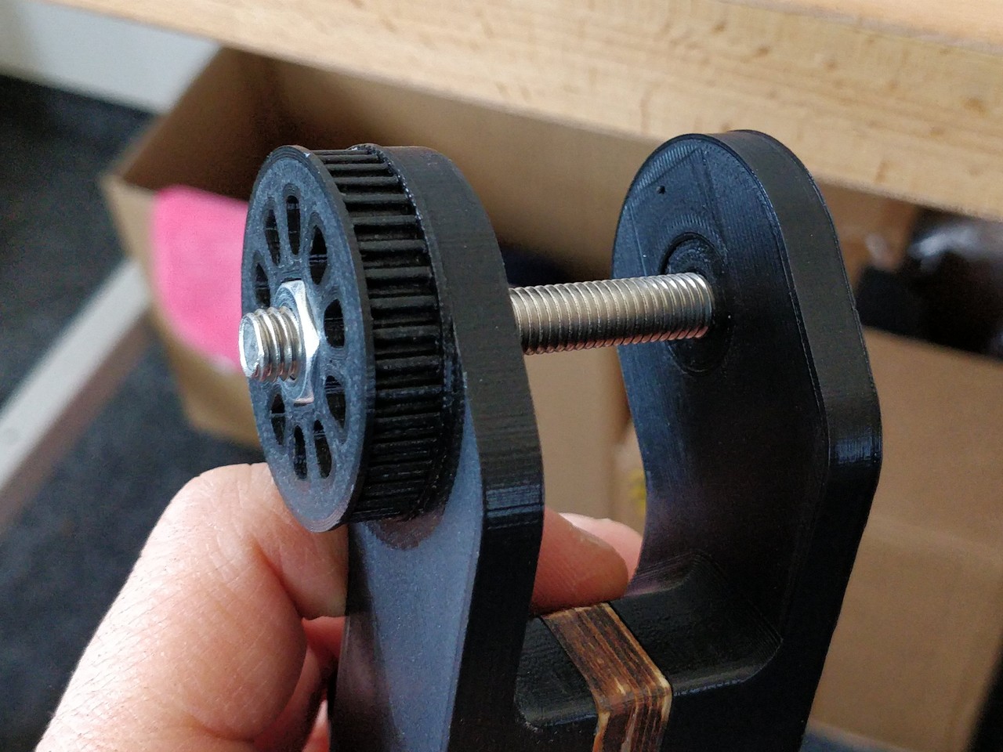
[picture p93: documentation/images/cut_threading_and_test_bolt.jpg]


Insert the two thigh motors (hip-pitch and knee pitch), pay attention to mount them in the correct orientation.

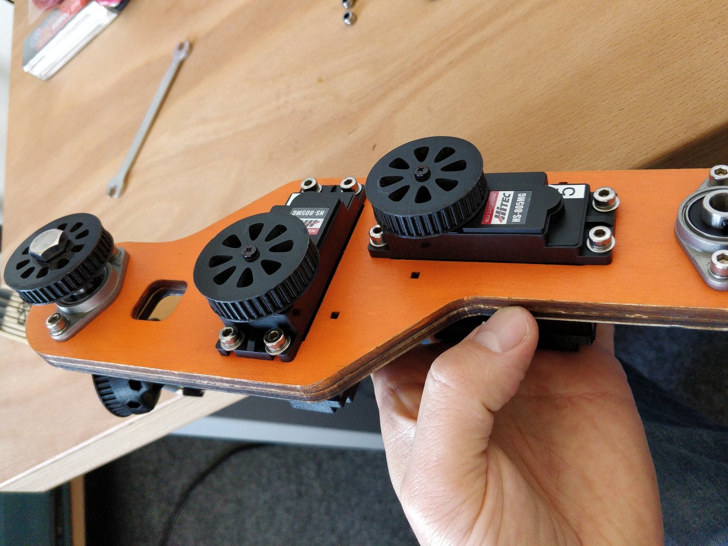
[picture p94: documentation/images/insert_thigh_motors.jpg]


Make sure using washers to protect the motors plastic screw holes and wood surface from the turning bolt heads and nuts.

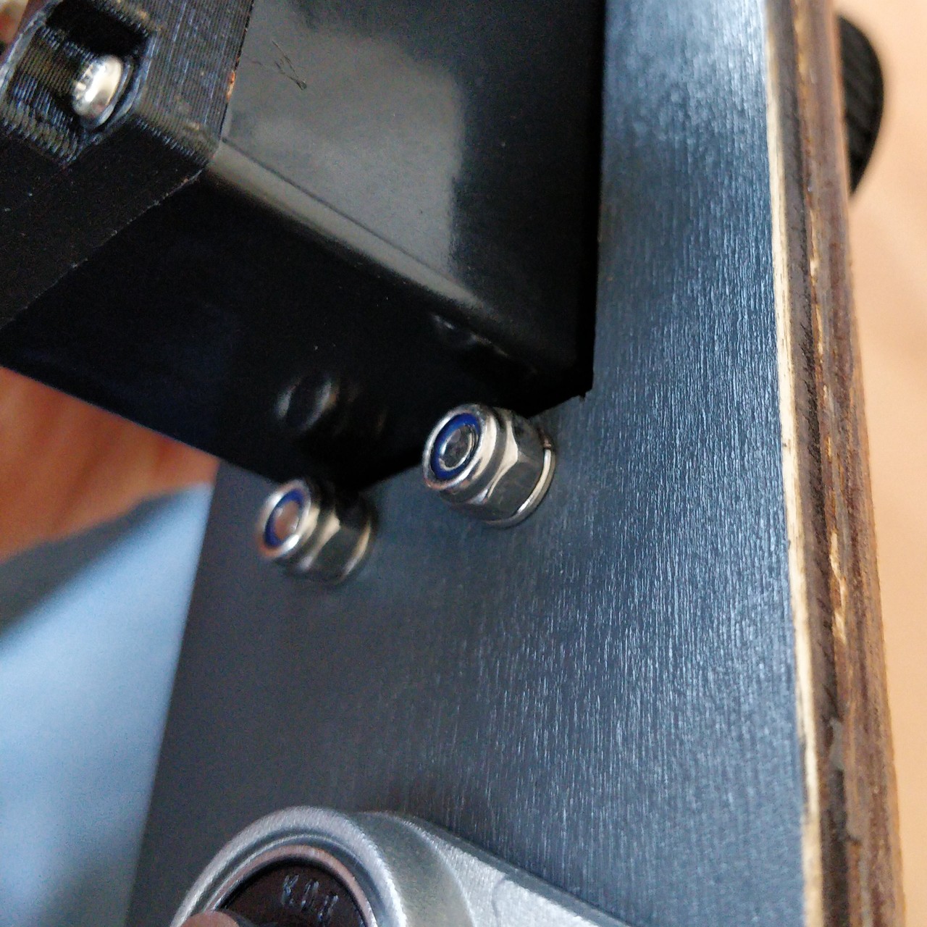
[picture p95: documentation/images/use_washers_for_the_motor_bolts.jpg]


Insert the shank motor, again pay attention to mount it in the correct orientation.

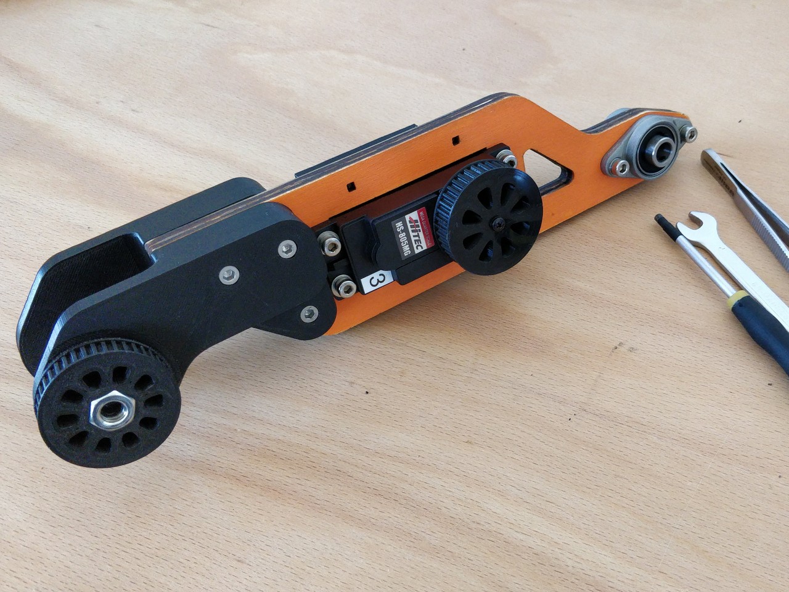
[picture p96: documentation/images/insert_shank_motors.jpg]


Use washers to fill the gap on the inside and a spring washer to tense the bolt.

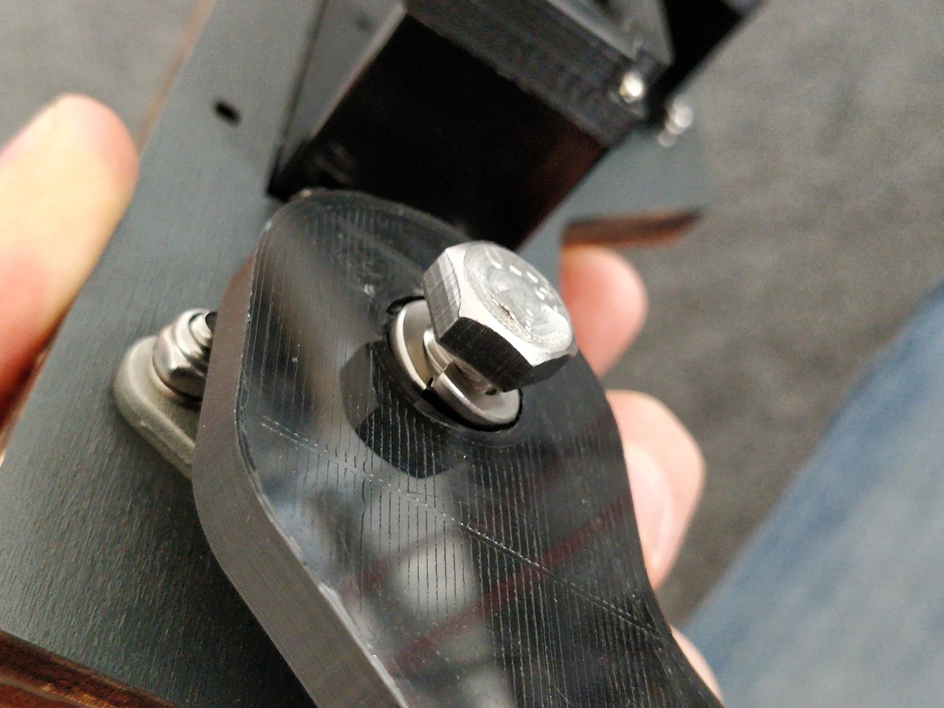
[picture p97: documentation/images/use_spring_washer_for_knee_bolt.jpg]

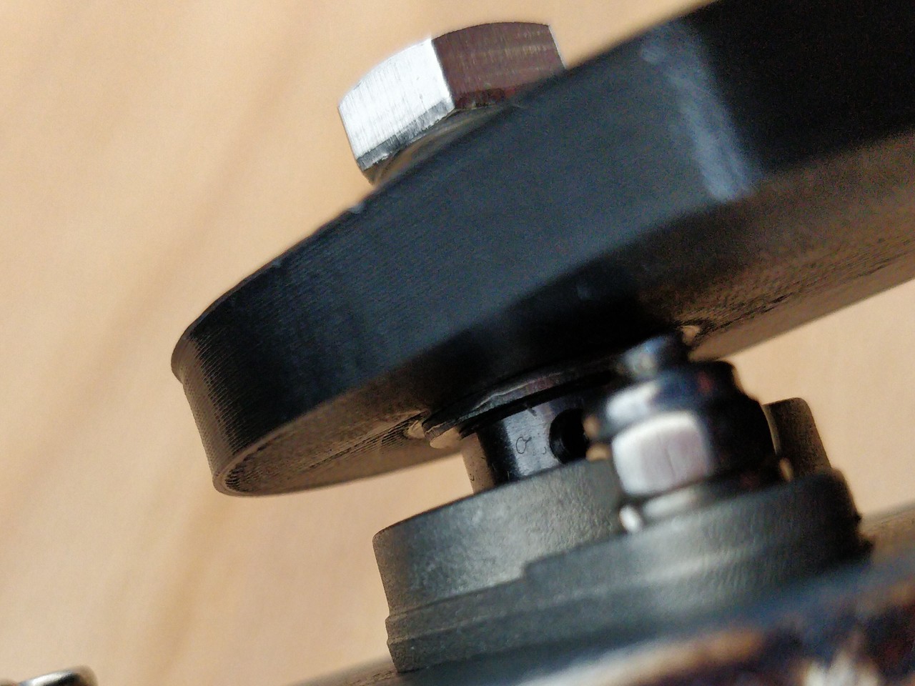
[picture p98: documentation/images/use_washer_inside.jpg]


Add a counter locking nut.

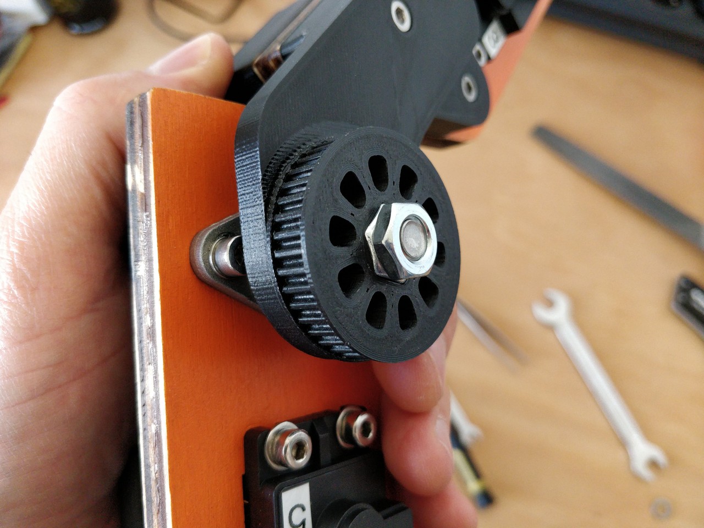
[picture p99: documentation/images/use_counter_nut_for_locking.jpg]


Repeat with the second leg following the same procedure. This is result.

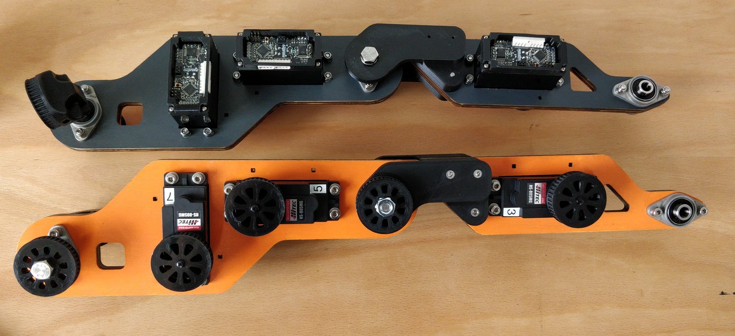
[picture p100: documentation/images/legs_ready_for_next_step.jpg]


=== Assemble the Lower Torso

Get the parts and tools needed to assemble the lower torso. Follow the same procedure for the torso motors as with the leg motors using washers and spring washers accordingly.

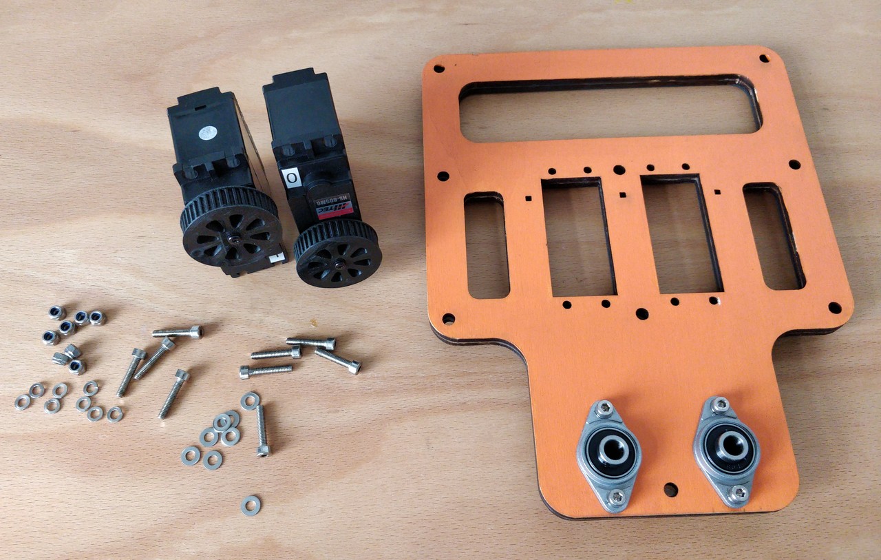
[picture p101: documentation/images/assemble_body.jpg]


Insert the motors given the orientation shown in the pictures.

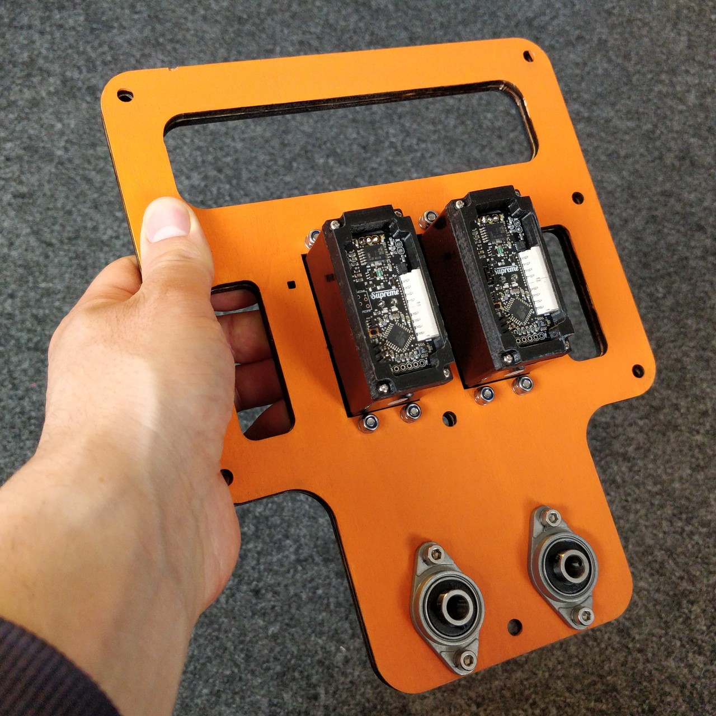
[picture p102: documentation/images/insert_motors_to_lower_torso.jpg]

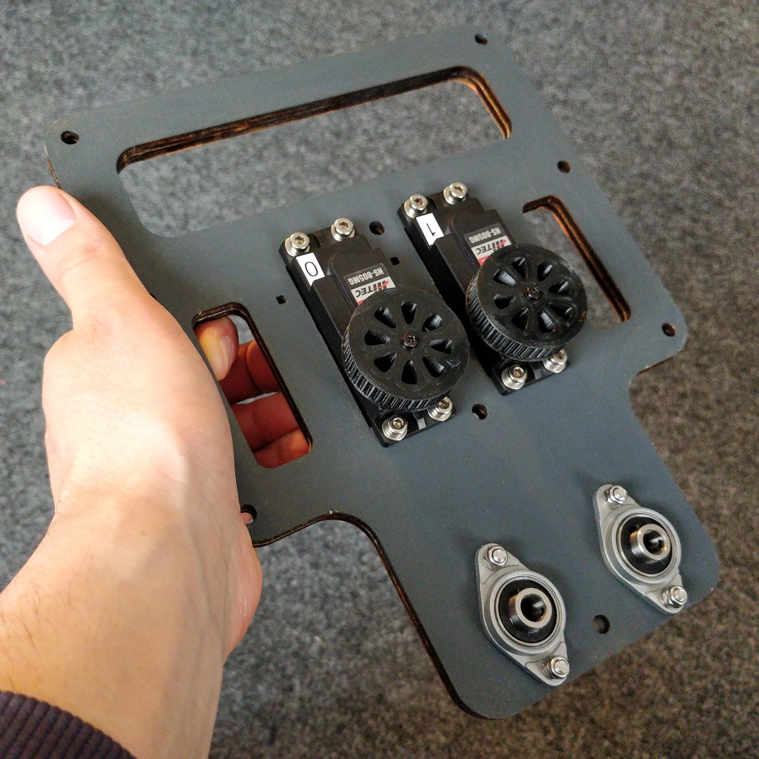
[picture p103: documentation/images/check_proper_motor_orientation.jpg]


Get the materials for hip/torso assembly. Check the threading (cut it, if not already done, as described in earlier sections). You will need the 60mm bolts.

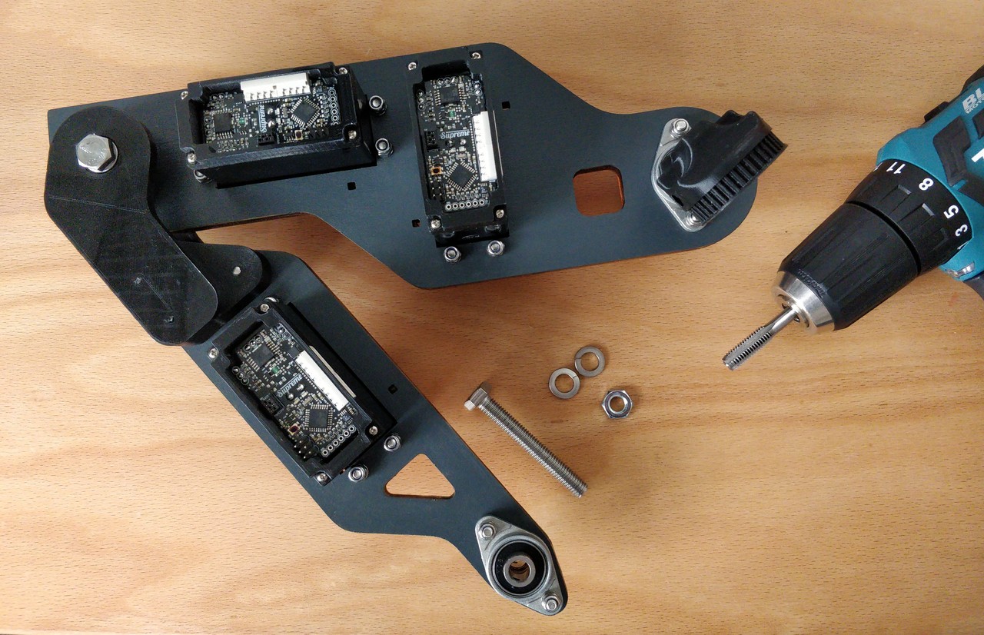
[picture p104: documentation/images/get_the_materials_for_hip_assembly.jpg]


Assemble the bolt and nuts and washers in the shown order. 3-4 mm need to be eaten by the spring washers.
Use the second hex nut for locking.

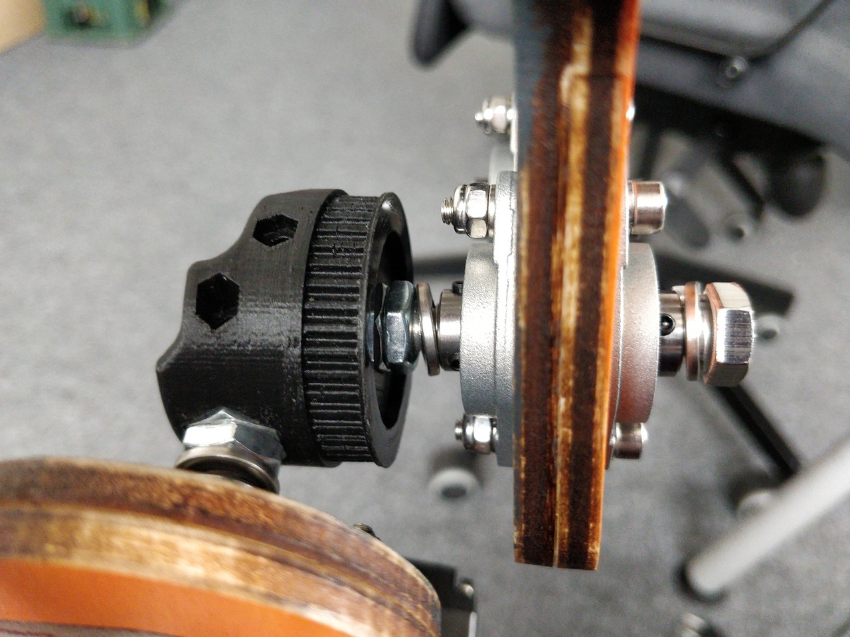
[picture p105: documentation/images/hip_axel_connector_to_torso_mount.jpg]


Repeat with the second leg.

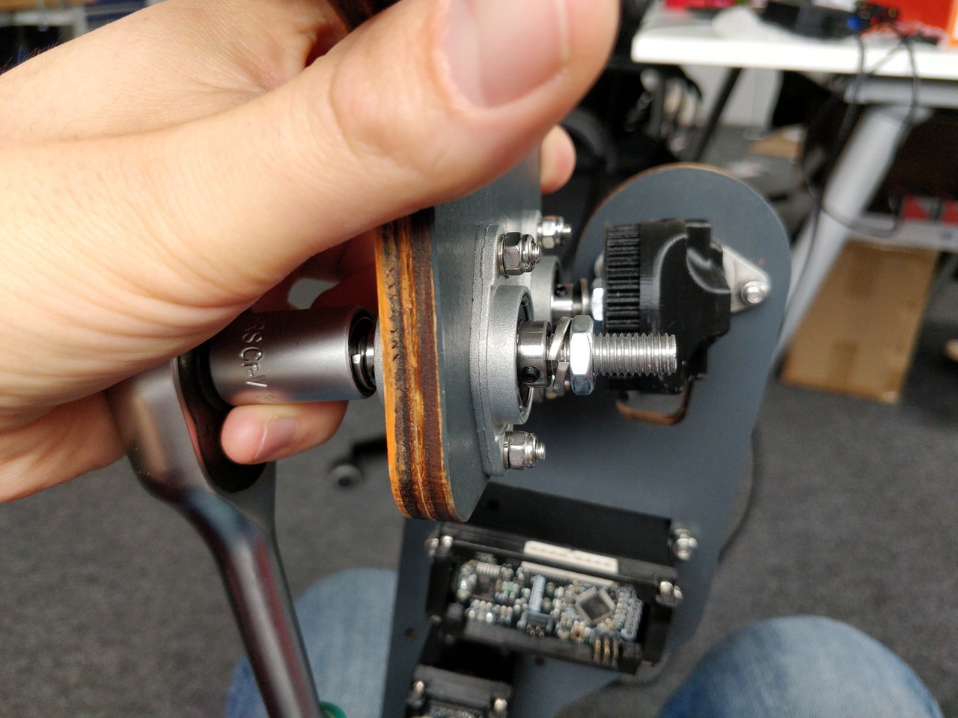
[picture p106: documentation/images/mount_second_leg.jpg]


This is the expected result.

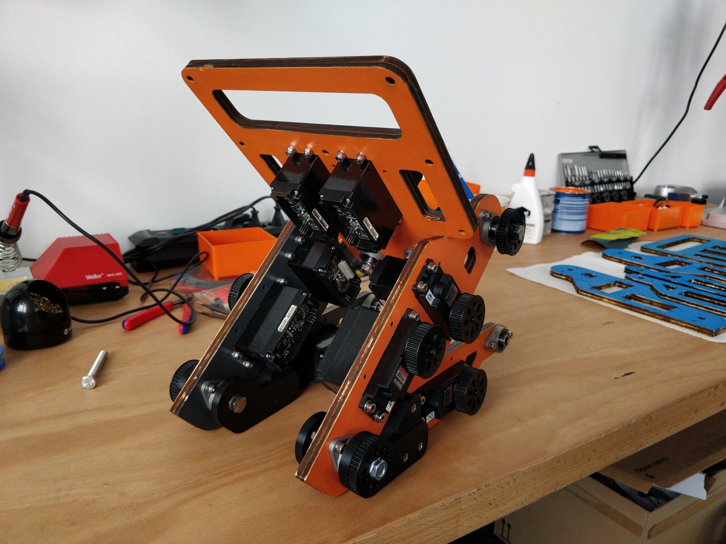
[picture p107: documentation/images/torso_and_legs_assembled.jpg]


=== Assembly of the Feet

==== Cardan Ankle Joint

Get the parts and tools needed for cardan joint assembly.

* pulley 33T with 4x M4 screw holes
* pulley 42T with 4x M4 screw holes
* cardan gimbal frame
* 8x M4 x 12mm cylinder head screws
* allen key M4
* taps M4 for drilling the threadings

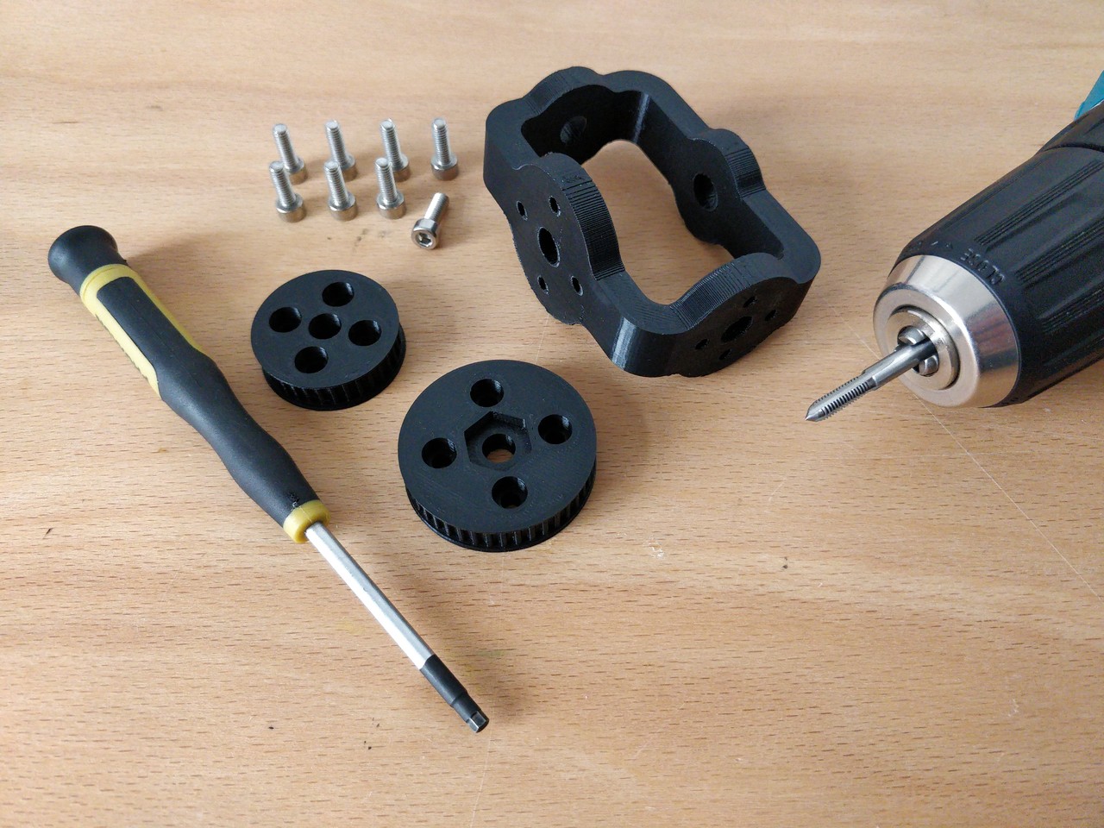
[picture p108: documentation/images/assemble_the_ankle_cardan_joint.jpg]


Drill the threadings using the M4 taps.

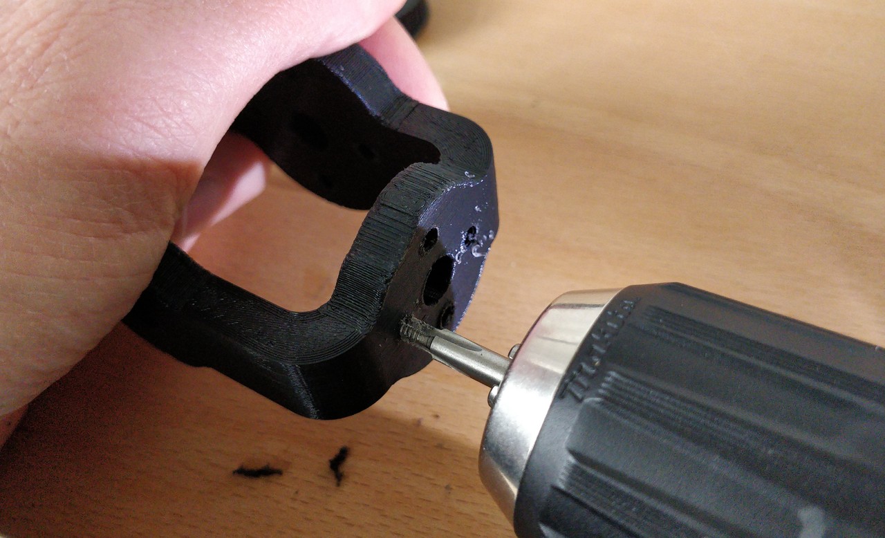
[picture p109: documentation/images/gimbal_threading.jpg]


Assemble the cardan joints using the M4 x 12mm screws.

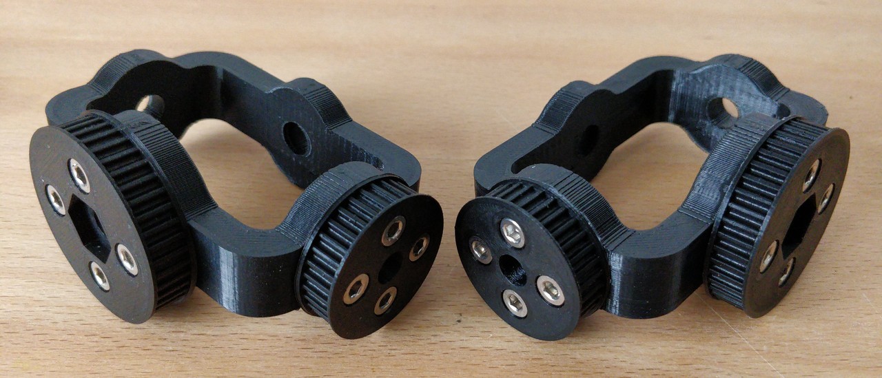
[picture p110: documentation/images/mount_pulleys_to_gimbal.jpg]


==== Prepare Foot

Mount the remaining bearing to the feet.

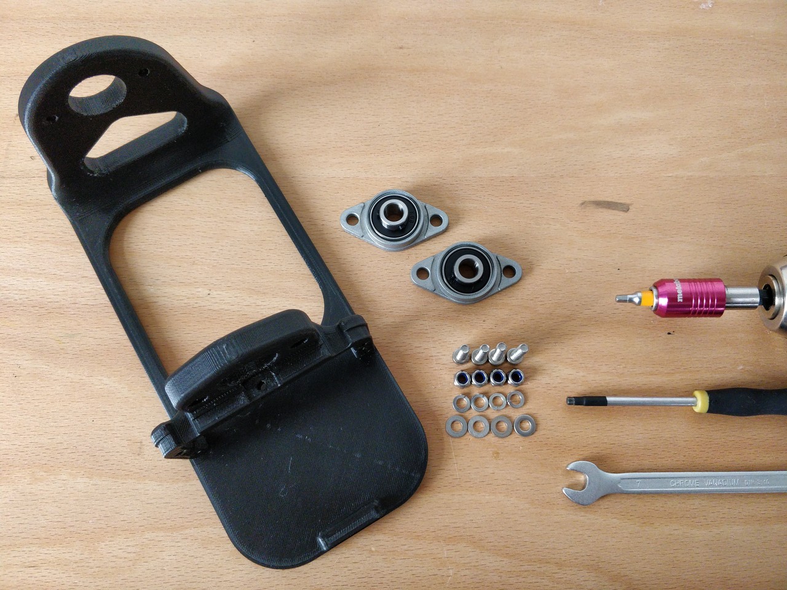
[picture p111: documentation/images/foot_assemble_bearings.jpg]


Insert the motors into the feet.

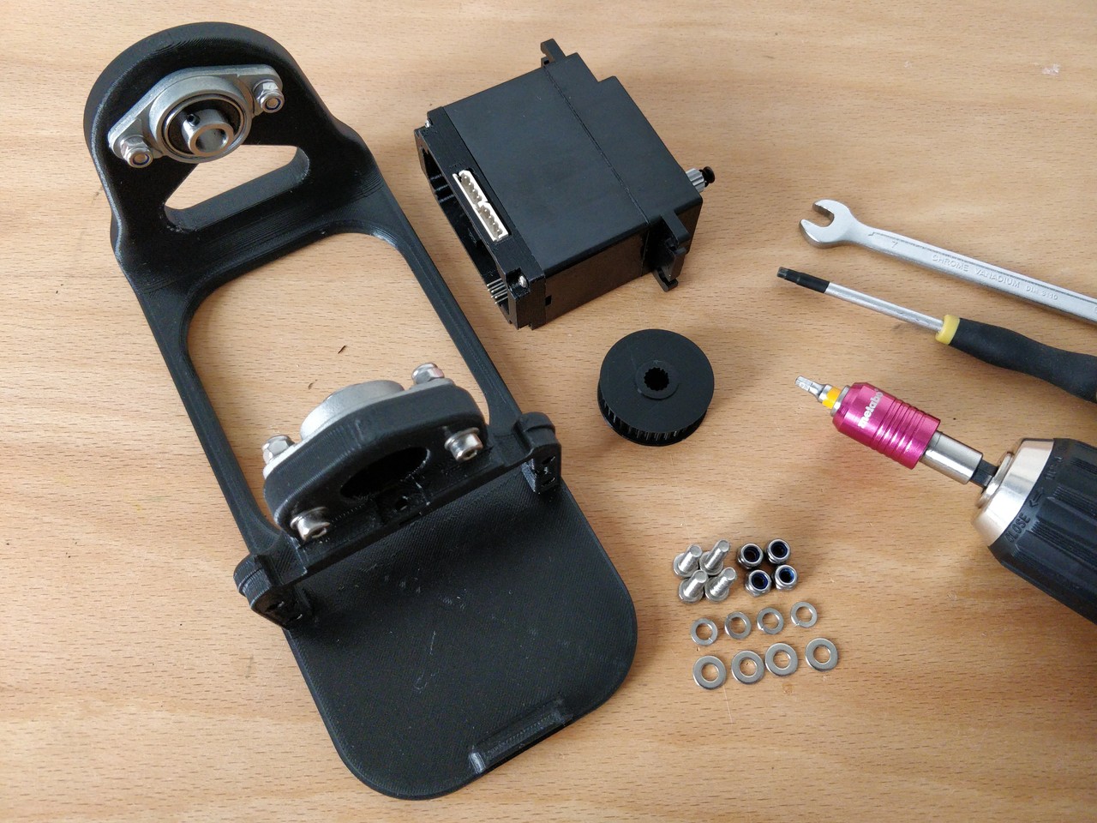
[picture p112: documentation/images/feet_insert_motors.jpg]

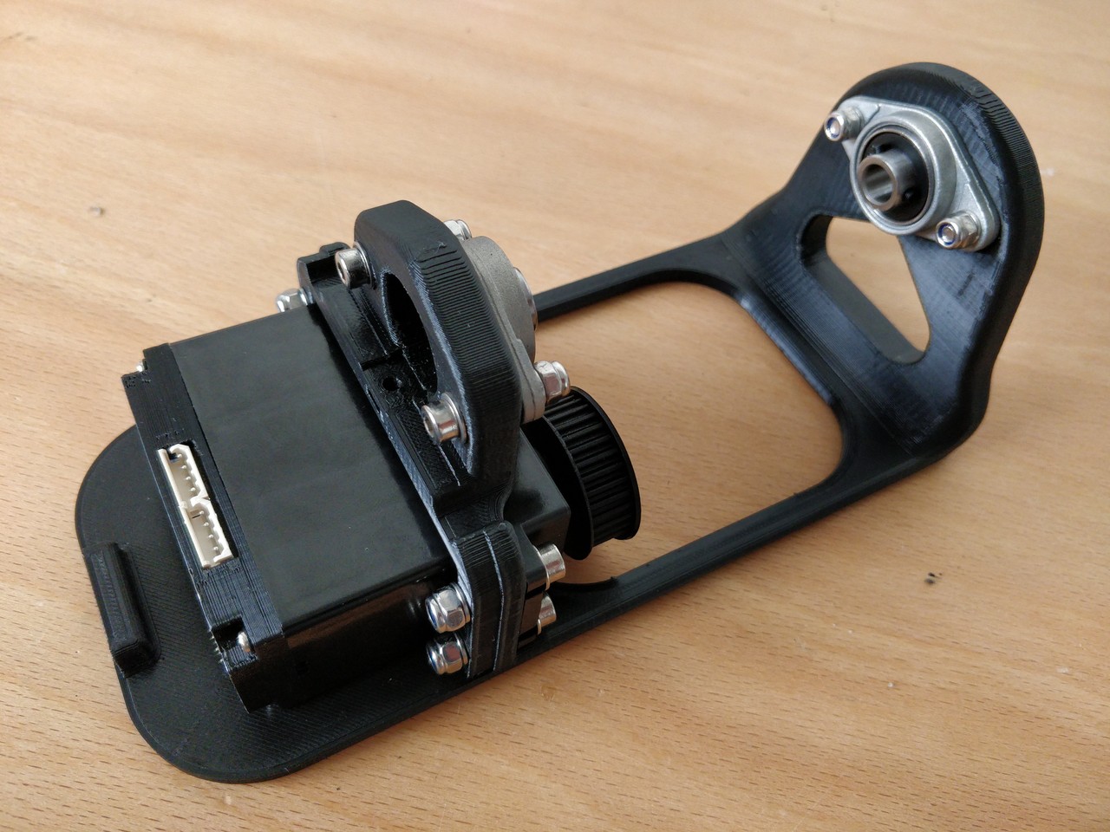
[picture p113: documentation/images/prepared_foot.jpg]


==== Foot assembly

Get all the tools and parts.

* assembled cardan joint
* preassembled foot
* spanner, socket wrench for M8
* M8 x 30mm and M8 x 40mm bolts
* M8 hex nuts
* M8 taps for cutting threadings
* spring and regular washers
* tooth belt GT3, 174 mm

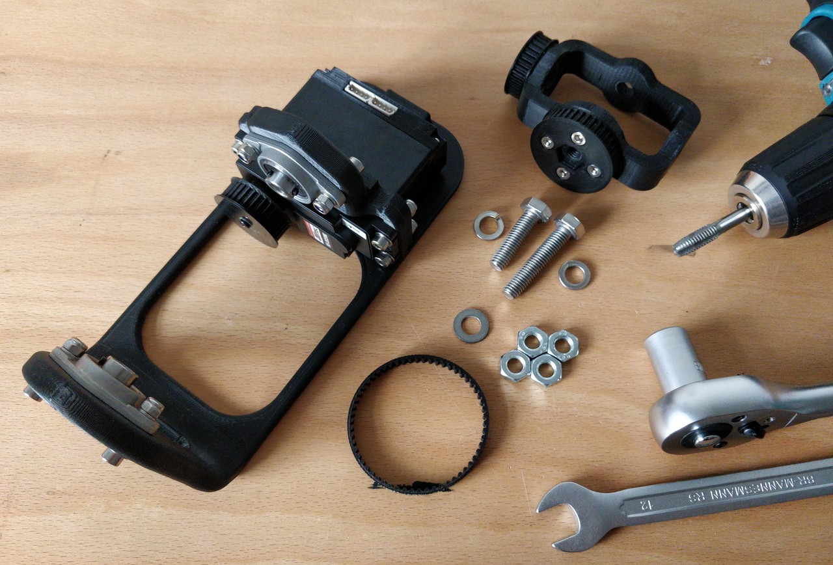
[picture p114: documentation/images/assemble_foot_prepare_tools.jpg]

*Step 1:* Begin with cutting the M8 threadings into the assembled cardan joint (front and back).

*Step 2:* Continue with inserting the 40mm bolt including the spring washer from the front side.

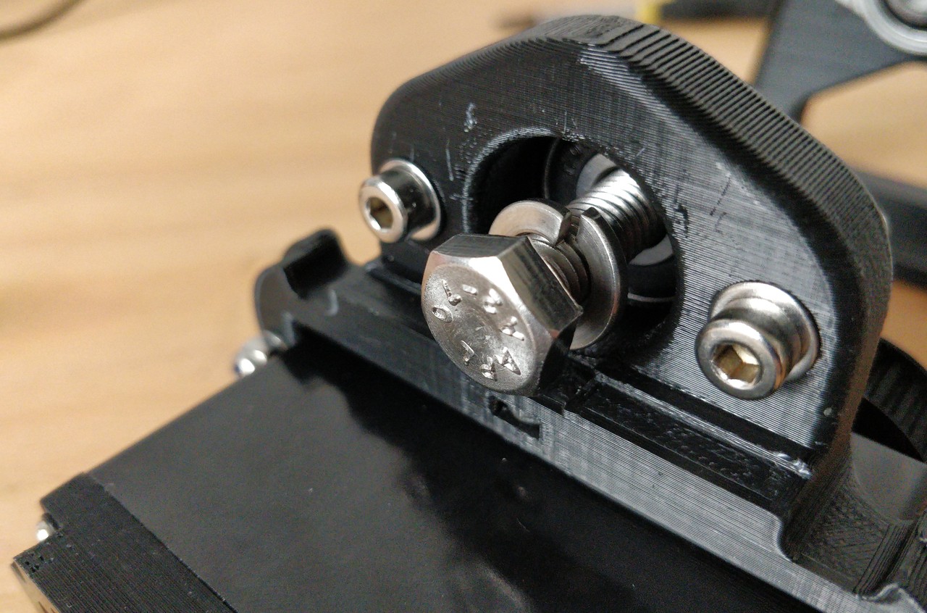
[picture p115: documentation/images/insert_bolt_and_spring_washer.jpg]


*Step 3:* Mount the cardan joint, pull the belt loosly over the cardan frame. Insert the 30mm bolt and second spring washer from the back of the foot (heel). Optionally use the regular washer to fill-up the play between cardan frame and heel mount. Use a pair of locked hex nuts for each bolt. The result should look like this. Repeat the process with the second foot.

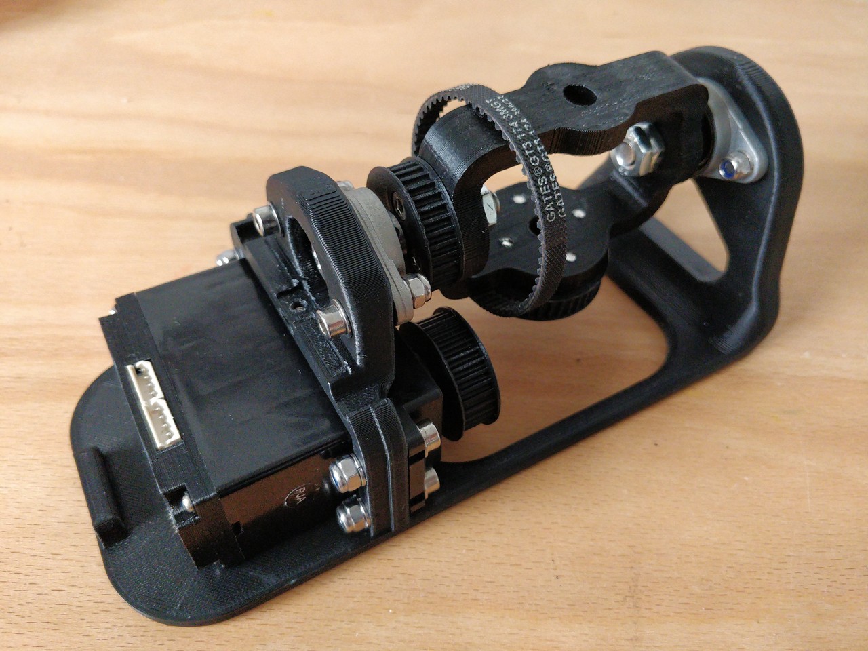
[picture p116: documentation/images/foot_result.jpg]


NOTE: The feet are perfectly idententical from the mechanical point of view. However, the IDs you assigned during motor software settings will define which one is the left and which one is the right foot.

=== Mouting feet

Get the two feet and the needed tools and prepare some space on your workbench to put the full robot there.

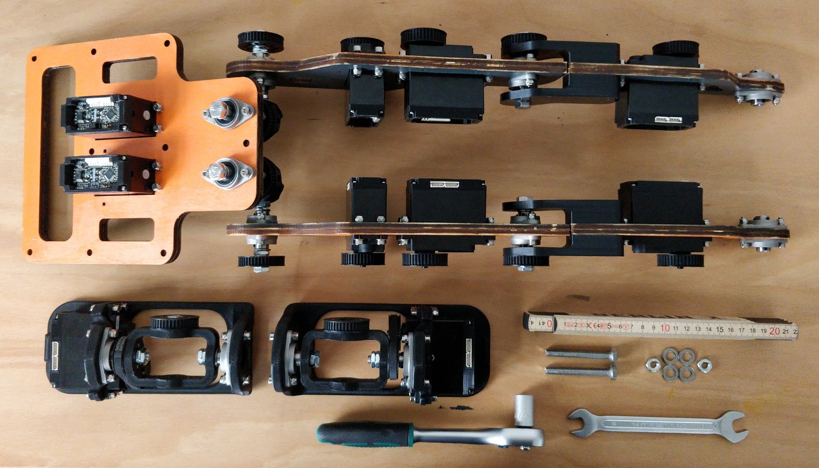
[picture p117: documentation/images/foot_mounting.jpg]


WARNING: Before mounting the feet, you need to pull over 1 tooth belt over each leg, which will be spanned in the next step, but the feet are too large to pull the belts over after mounting.

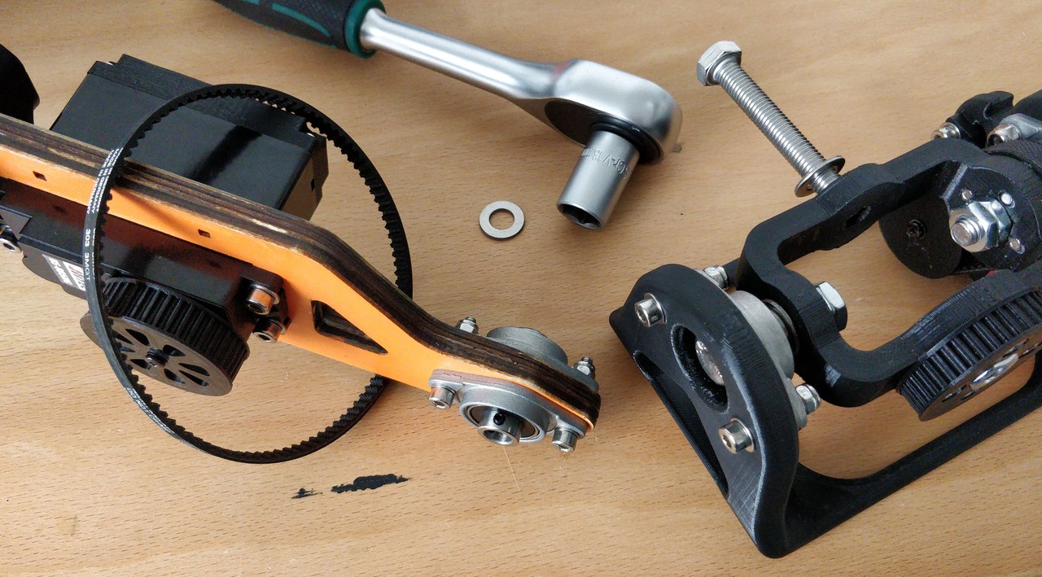
[picture p118: documentation/images/dont_forget_to_pull_over_belt.jpg]

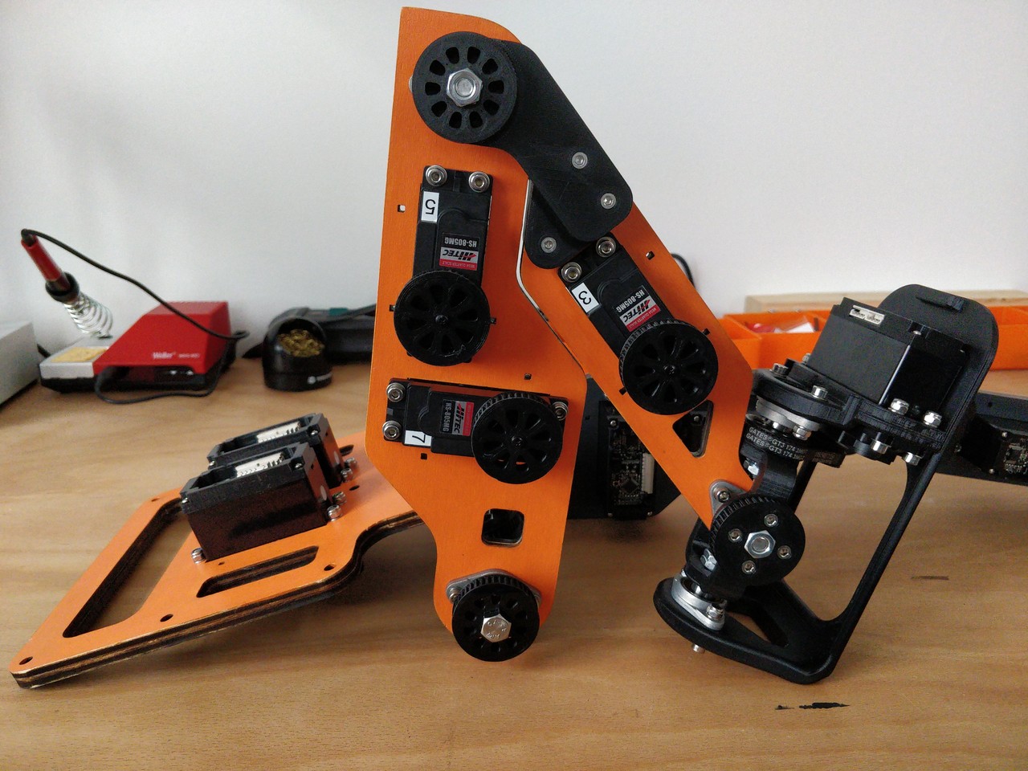
[picture p119: documentation/images/first_foot_mounted.jpg]

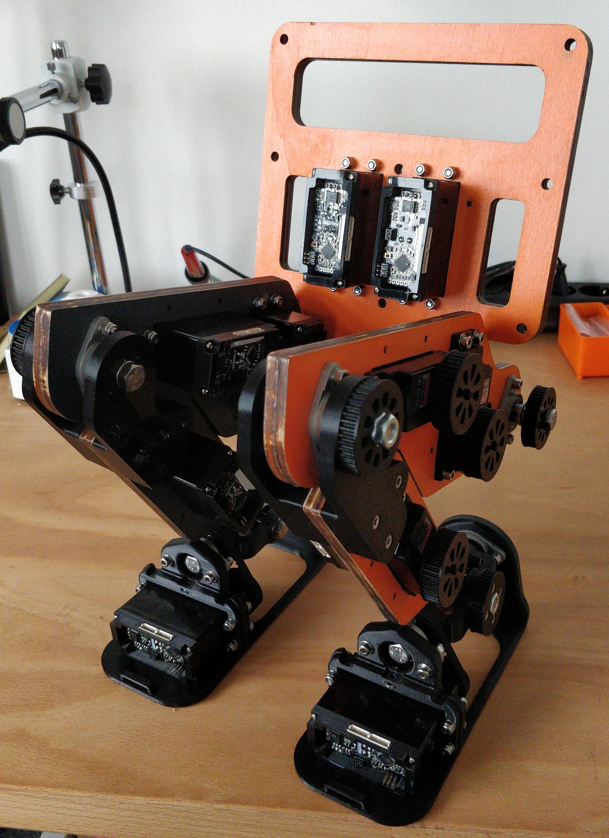
[picture p120: documentation/images/both_feet_mounted.jpg]


=== Cable confection
We recommend using officially supported MOLEX SPOX wire crimp tool, but we also know that theses devices may be quite expensive. However, if you already own a crimp tool it is worth trying if it can be used here, please verify carefully for proper connections and not cutting the insulation of the cable. The method described here is for users without access to appropriate crimp tools. Despite the fact that solder crimping is generally a questionable method for industrial standards, this is still a valid workaround in home manufacturing.

TIP: Also consider to buy third party cables (e.g. from Robotis) or feel free to change the type of connector.

==== List of Cable Lengths

[cols=3*,options=header]
|===
| No. | Length | Position
| 4   | 42cm | 2x thigh-to-shank, 2x hip-to-thigh
| 2   | 38cm | 2x shank-to-foot
| 3   | 16cm | 1x hip-to-hip, 2x thigh-to-thigh
|===

*Step 1:* Preparation: Cut the wires to their specific length given in the table above. Strip the wire ends approximately 2 mm. Twist the wires and pre-solder the wire ends and cut to 1.5 to 2mm. As a specific style the supply voltage carrying wire is denoted using a red insulation colored wire. GND and data lines are denoted with black cables. So for each cable you need 1 red and 3 black of a certain length. Repeat this with all the cables needed.

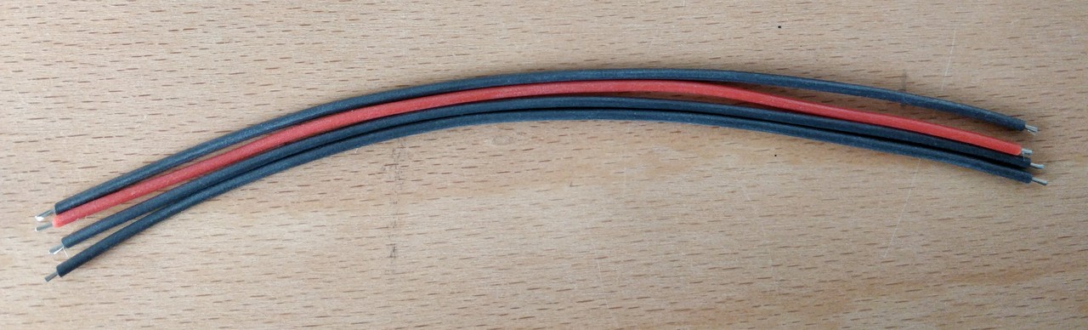
[picture p121: documentation/images/cut_wires_and_strip_ends.jpg]


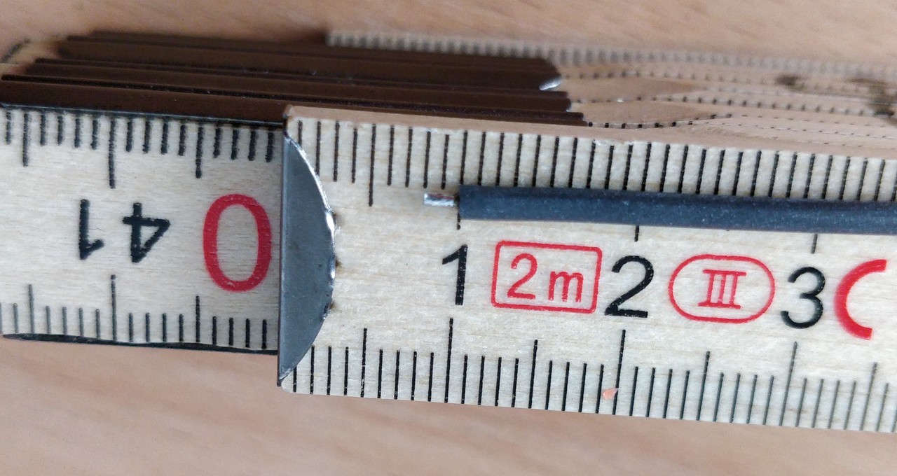
[picture p122: documentation/images/presolder_wire_ends_and_cut_to_2mm.jpg]


*Step 2:* Get the tools needed for cable confection.

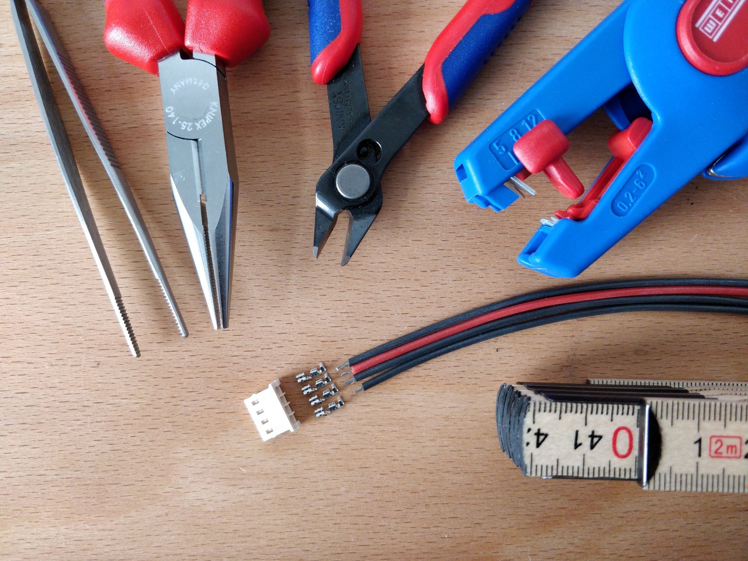
[picture p123: documentation/images/tools_for_wire_confection.jpg]


This is the recommented color code for the cable:

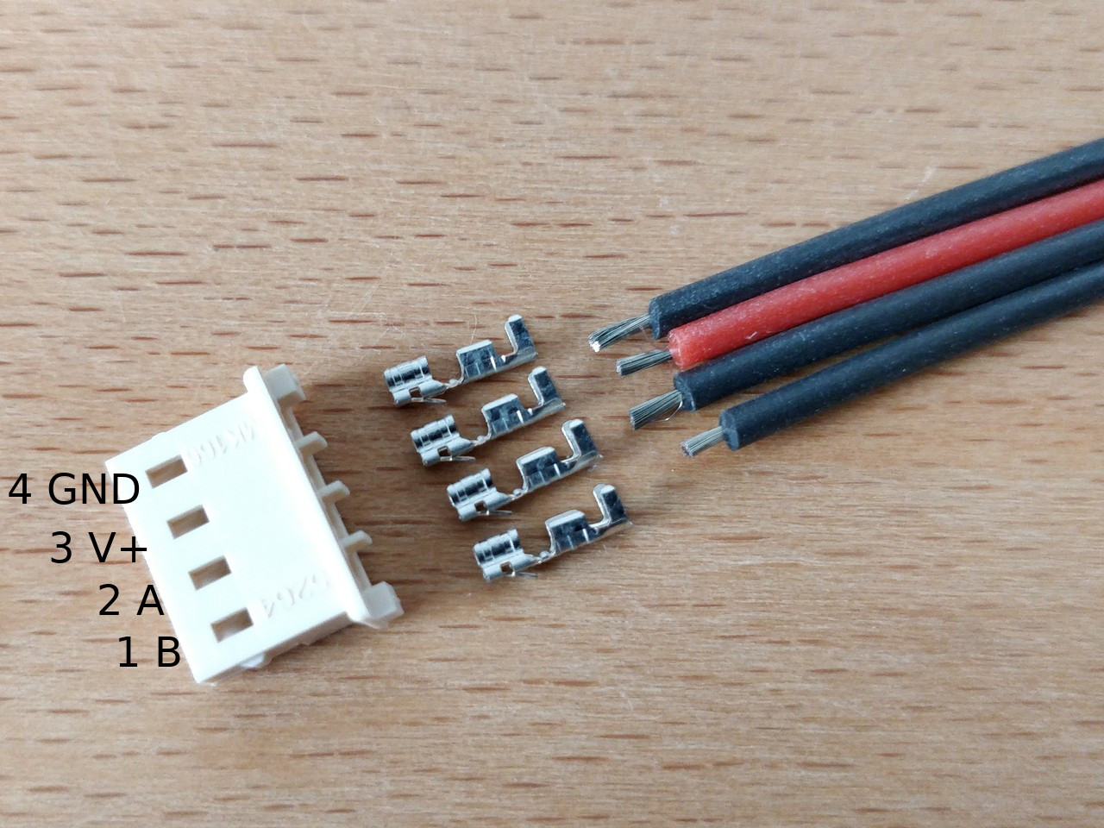
[picture p124: documentation/images/pin_assignment.jpg]


Use flat-nose pliers to crimp the metal terminal arms (outer) around the cables insulation. Don't cut the insulation, and don't crimp to strong, just enough to hold the wire in place.

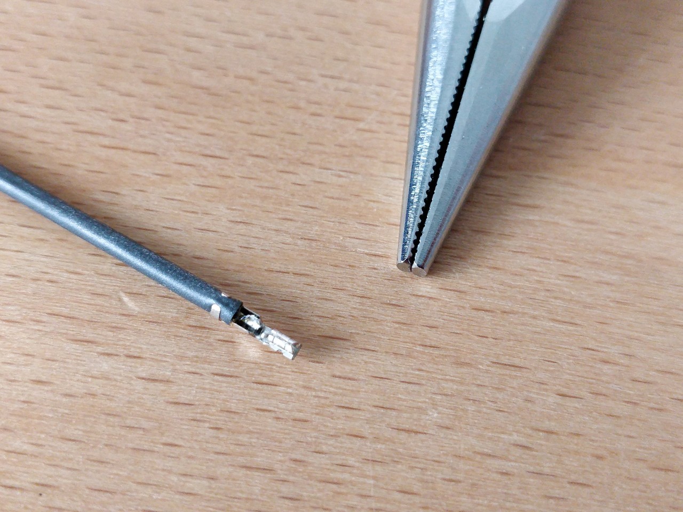
[picture p125: documentation/images/crimp_wire_insulation_with_outer_arms.jpg]


Solder the wire ends onto the inner terminal arms using, thin solder and fine tip.

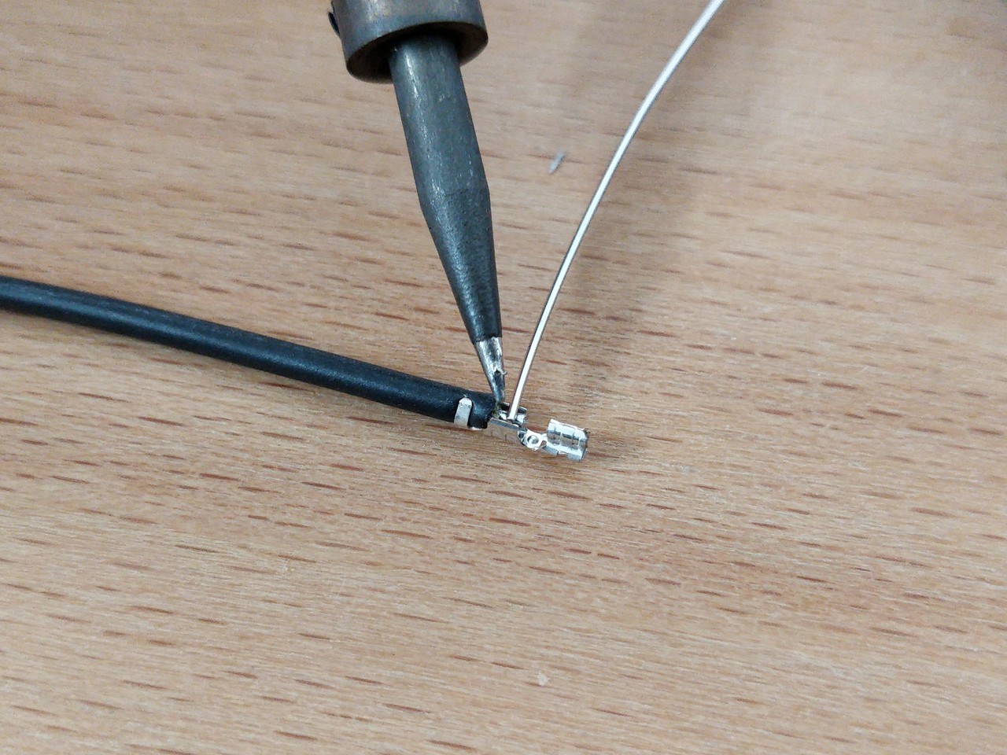
[picture p126: documentation/images/solder_wire_end_onto_inner_terminal_arms.jpg]

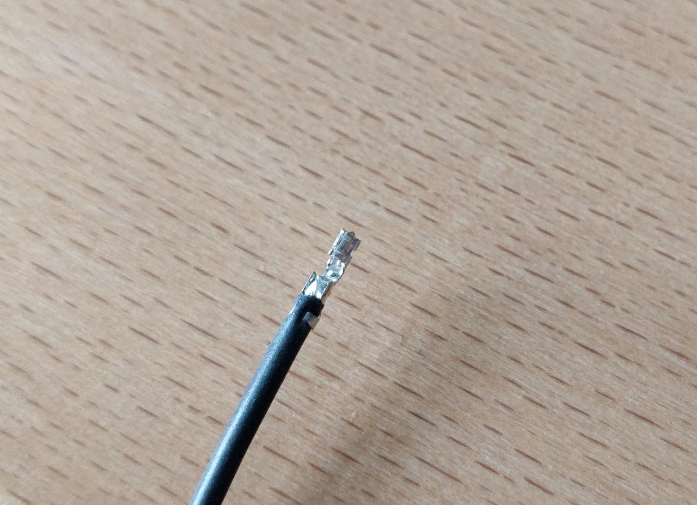
[picture p127: documentation/images/solder_wire_result.jpg]


Assemble wire in the shown way. You hear a little click each time a wire terminal locks into the socket.

TIP: Consider to use wire sleeving for the cables which connect joints and which are likely subject to mechanical wear.

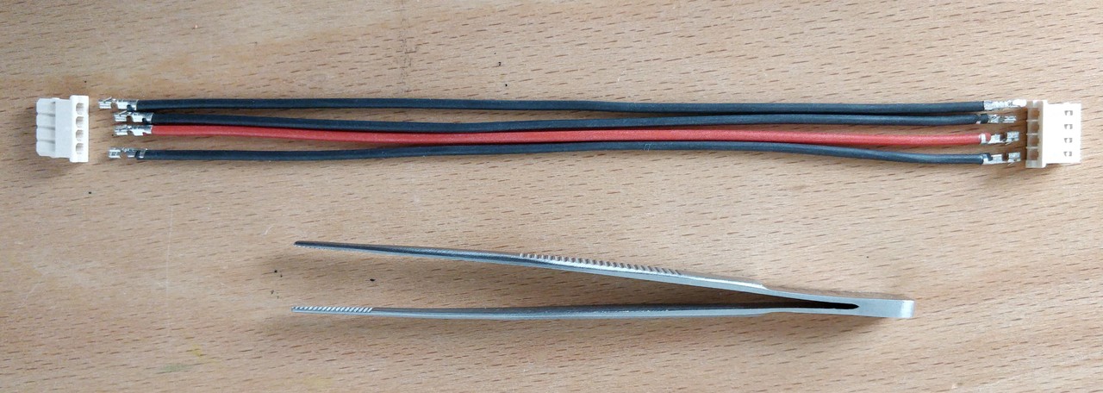
[picture p128: documentation/images/assembly_wire.jpg]


The bus system is symmetrical and benefits from twisted pair data wires for better signal quality. So gently twisting the data lines assures an approximately constant cable impedance over the full cable length and helps suppressing injected noise.

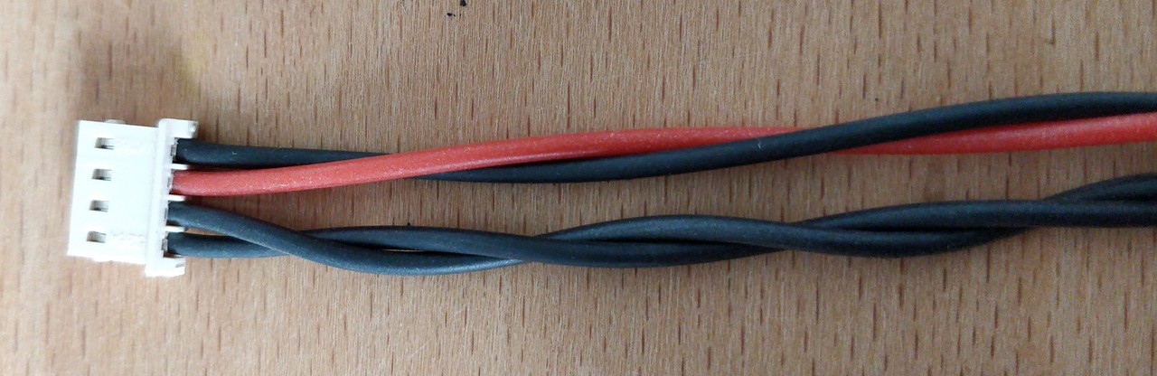
[picture p129: documentation/images/twist_data_lines.jpg]


NOTE: Check for correct pin assignment, if not sure, use a multimeter.

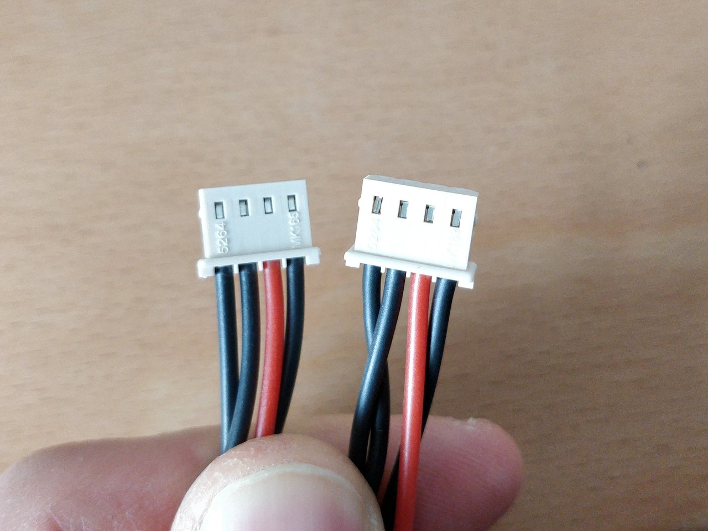
[picture p130: documentation/images/check_correct_pin_assignment.jpg]


==== Termination resistors

Insert termination resistors (220 Ohms) into sockets using two terminals and solder carefully without buring the plastic socket.

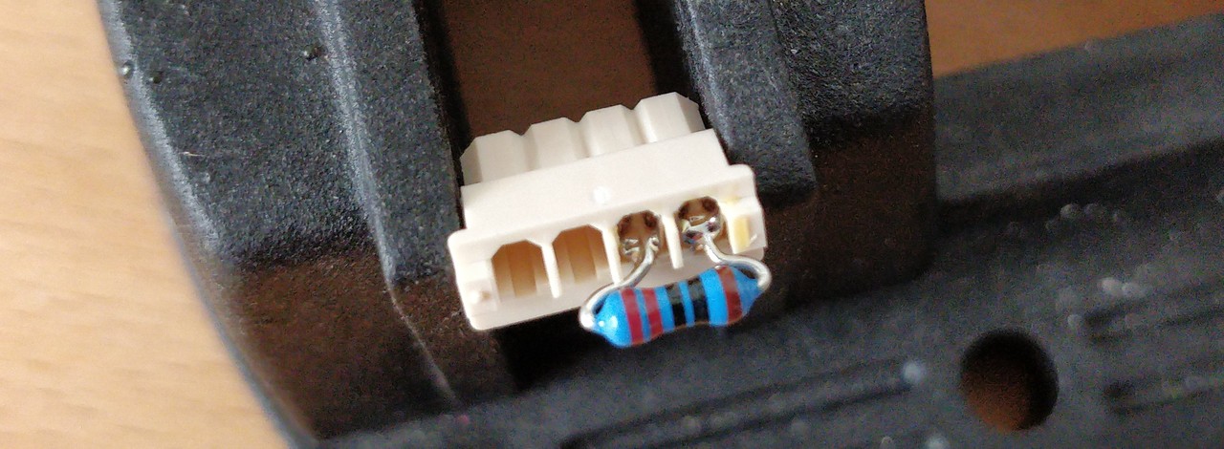
[picture p131: documentation/images/termination_resistors.jpg]


=== Cabling
Get all the cables, some 2mm width cable ties and a side-cutting pliers for processing the wiring of the robot's motors.

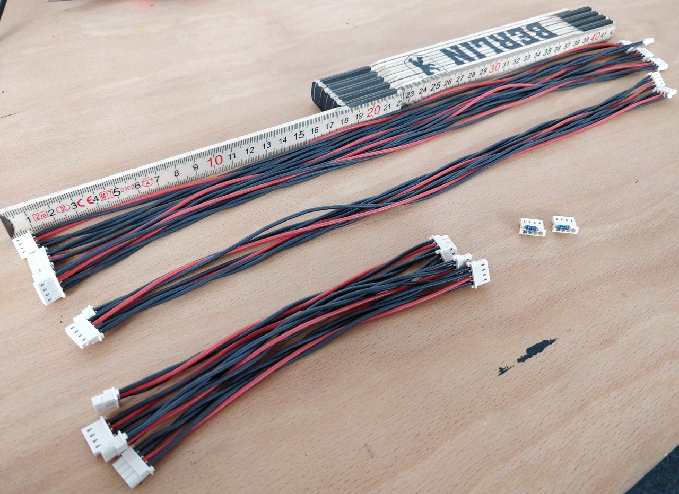
[picture p132: documentation/images/cable_result.jpg]

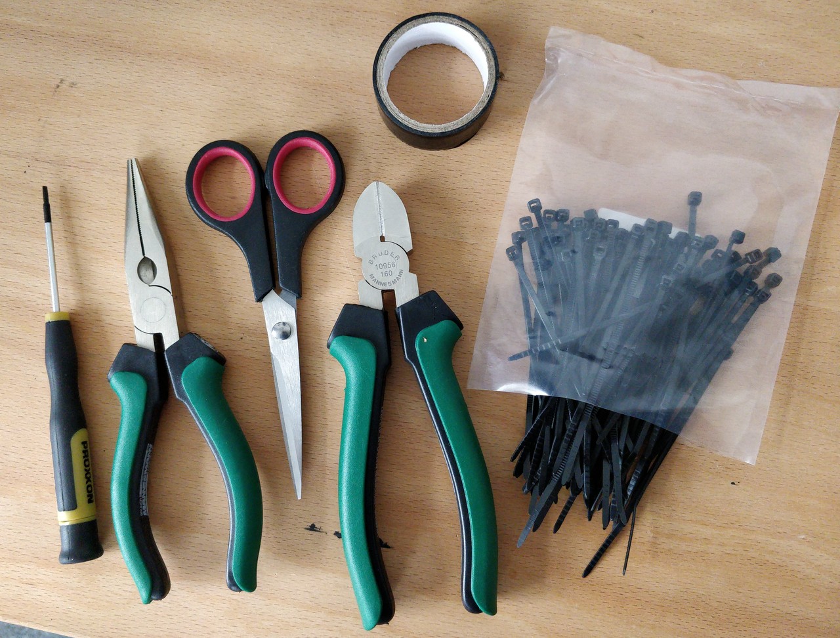
[picture p133: documentation/images/cables_tools.jpg]


Cabling must be done with special care and probably you need to correct it several times and watch how the cables fall and fold when the joints are moved. Avoid squeezed cables as they may cut and tear apart.

The general bus topology is a daisy chain. All motors are connected to the same bus. Avoid star connections, connect as a single line. Use termination resistors at both ends.

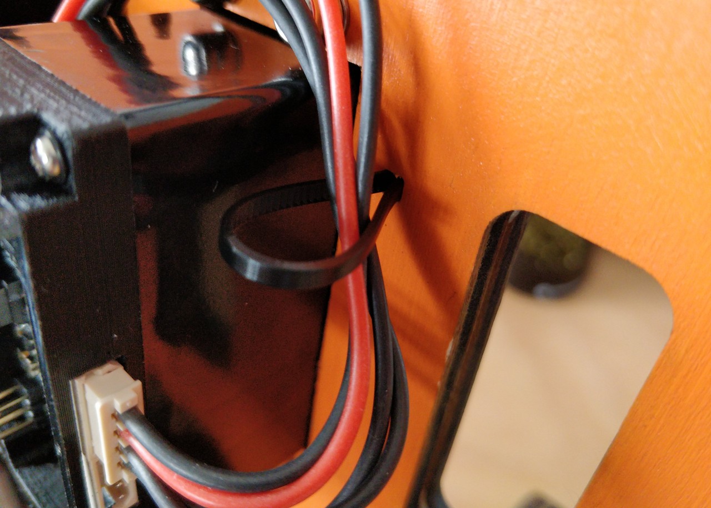
[picture p134: documentation/images/cables_using_ties.jpg]

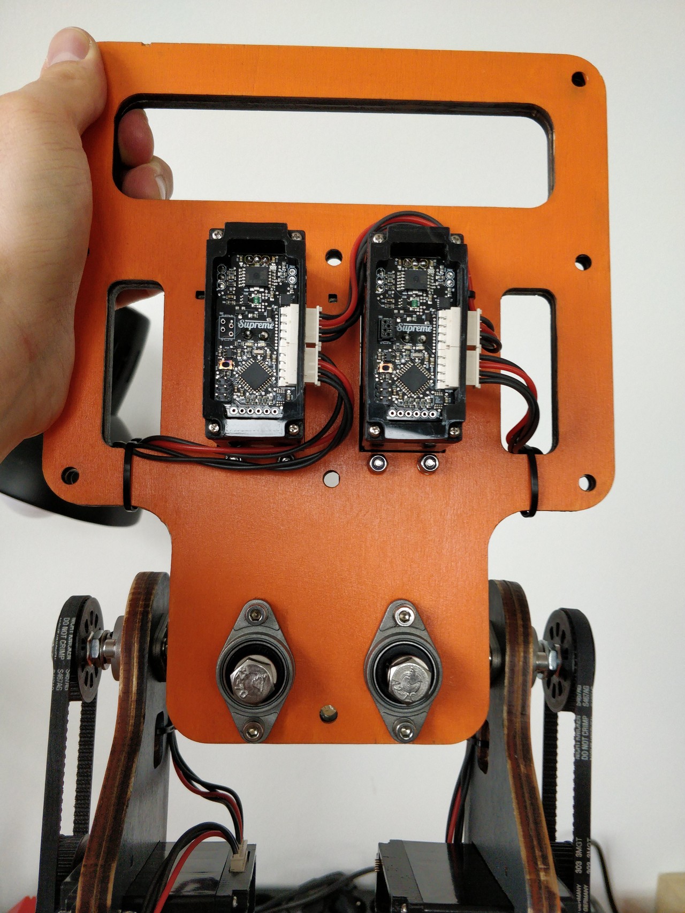
[picture p135: documentation/images/cables_top_front.jpg]

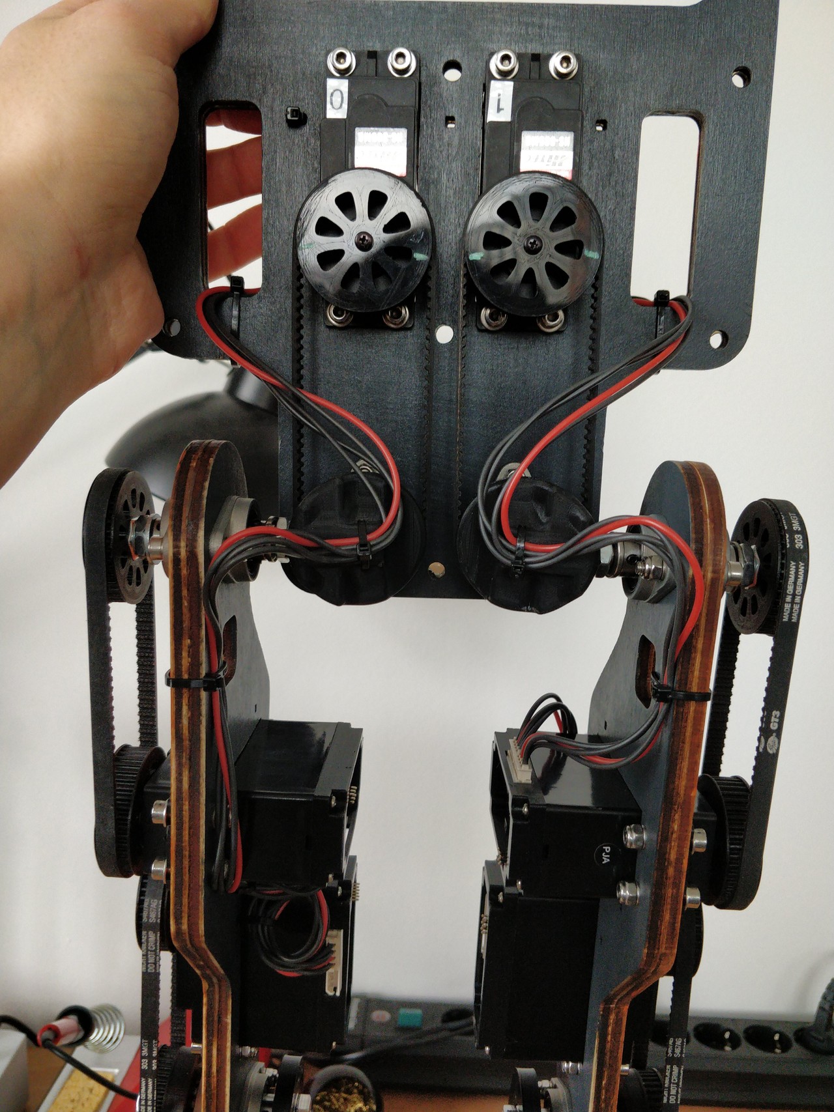
[picture p136: documentation/images/cables_top_back.jpg]

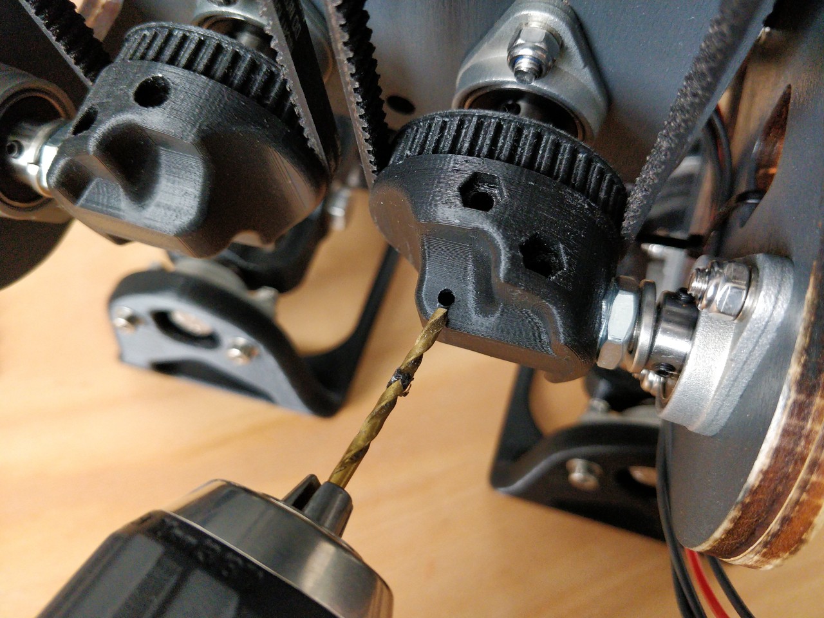
[picture p137: documentation/images/cables_drill_additional_hole.jpg]

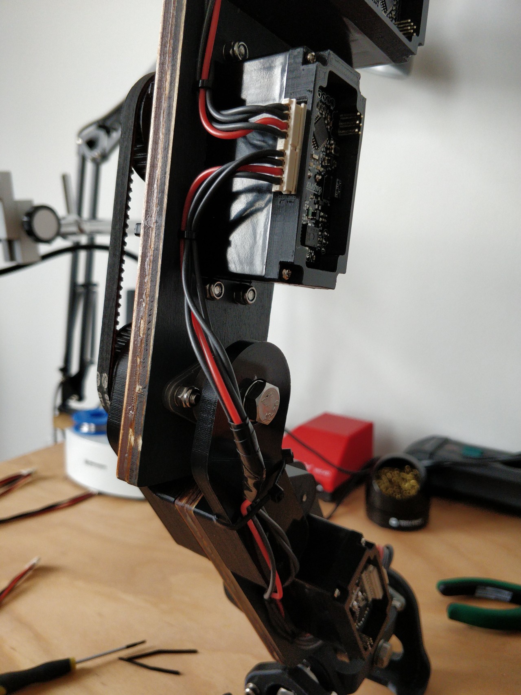
[picture p138: documentation/images/cables_knee.jpg]

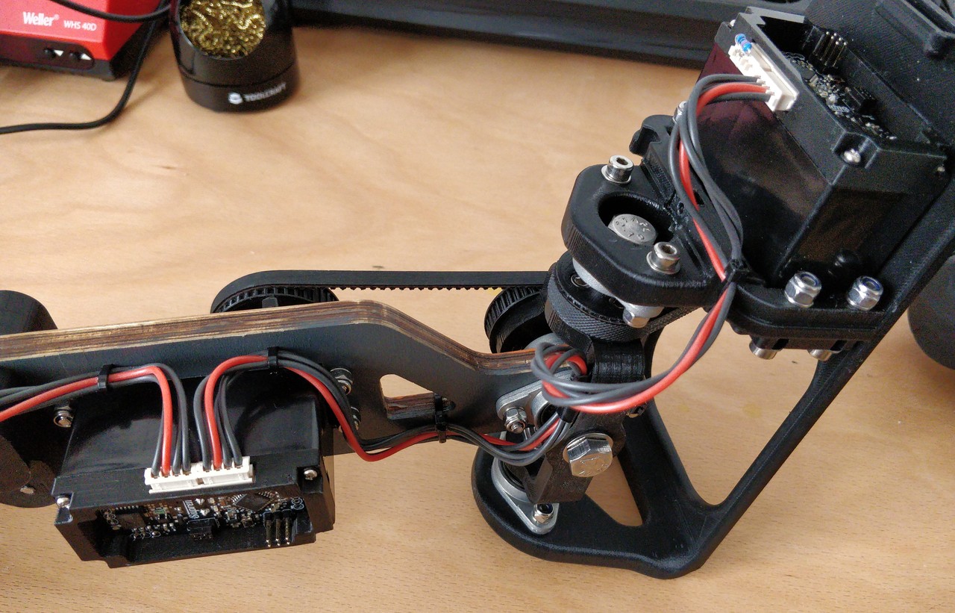
[picture p139: documentation/images/cables_shank_foot.jpg]

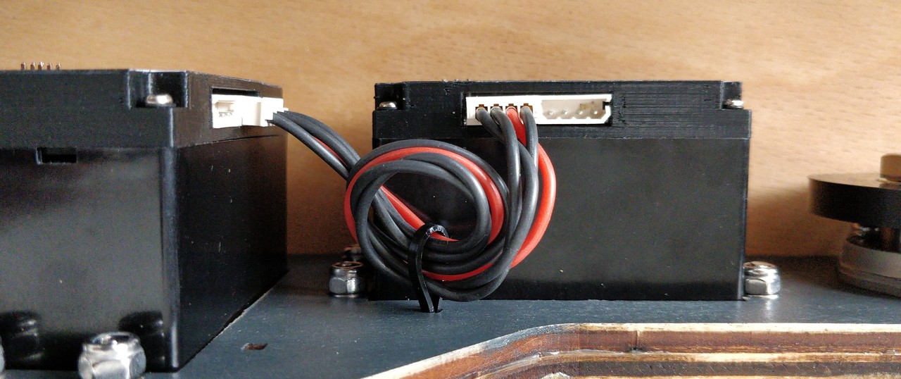
[picture p140: documentation/images/cables_detail.jpg]

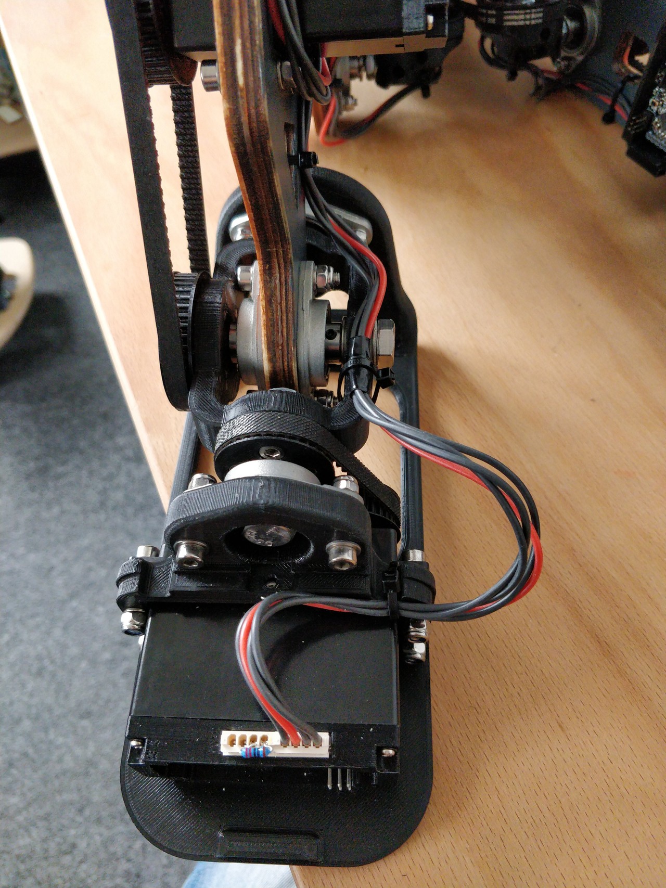
[picture p141: documentation/images/cables_shank_foot_2.jpg]


As the last step, insert the termination resistors at each end of the line.

=== Tooth Belt Mounting and Tensioning

Get the tooth belts. Take a breath and watch the video for mounting advice. Tightening belts will take a little bit of trial and error and gets more fluently with experience.

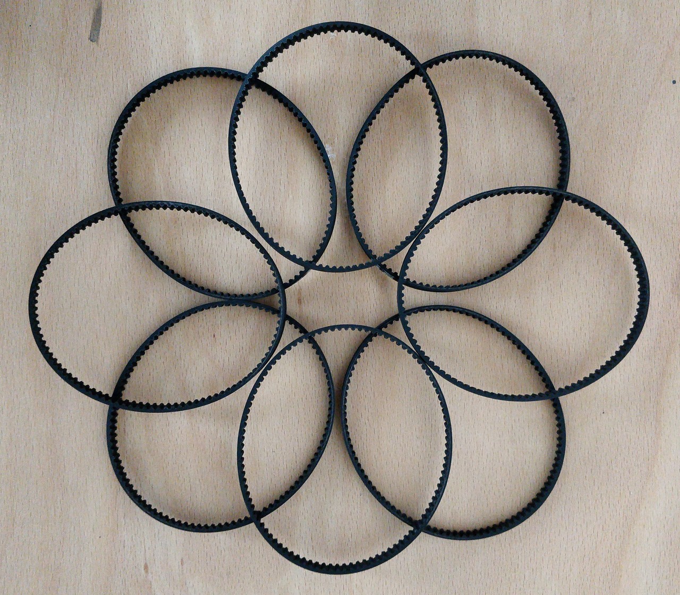
[picture p142: documentation/images/belt_flower.jpg]


video: https://www.youtube.com/watch?v=zkVwW5wzHFk[gretchen_assembly_tooth_belts_mounting]

video::zkVwW5wzHFk[youtube]

=== Optionals

==== Using felt for the soles

Optionally, you can add adhesive felt to the soles in order to improve the foot-to-ground contact.

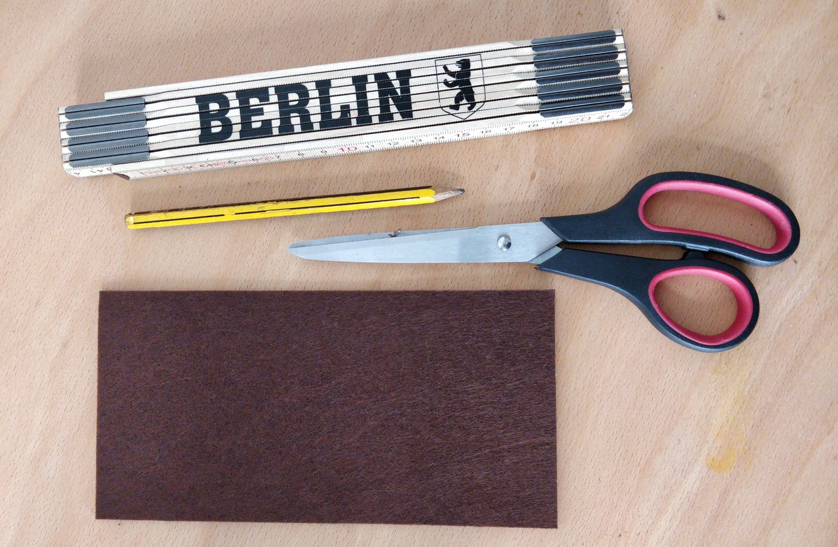
[picture p143: documentation/images/using_felt_for_feet.jpg]

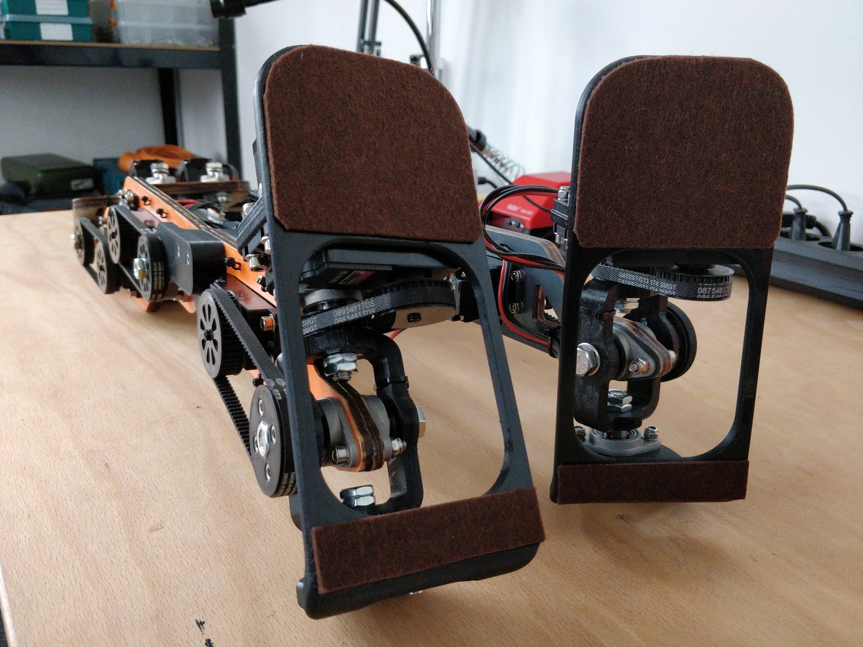
[picture p144: documentation/images/feet_with_adhesive_felt.jpg]


=== Done.

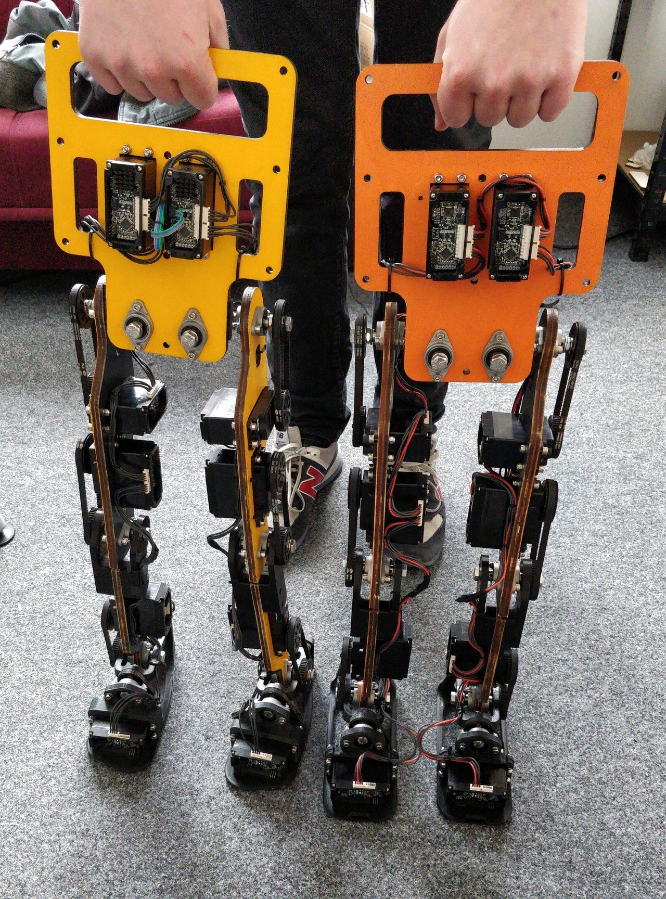
[picture p145: documentation/images/gretchen_assembly_finished.jpg]


== Known Issues

=== Hardware Issues

*2019-02-27:* The gluing of the wood parts is sometimes difficult. Especially the exact alignment. Screws help align, but have play. Suggestion: Several 3D-printed cones holding the wooden parts aligned during gluing.

*2019-02-28:* Using bolts with heads on both ends of the hip connector means that when it comes to (temporary) removal of the leg from the hip (e.g. for maintenance), the threading of the hip (PLA, plastic) will be stressed, it would be better to use headless bolds here, to be able to remove the leg without removing the bolt from the plastic part.

*2019-03-22:* The bus connectors of the sensorimotor boards are a little too far out of the boards and this makes it sometimes hard to insert the motors in the wooden parts which need to have little tolerances for better belt tension.

*2019-03-28:* The bolts for the heel axis are too long and cut into the wooden shank part. There must be added a save mechanical limit. Workaround: insert some damper (felt or similar) to absorb the impact and limit the damage to the wood.

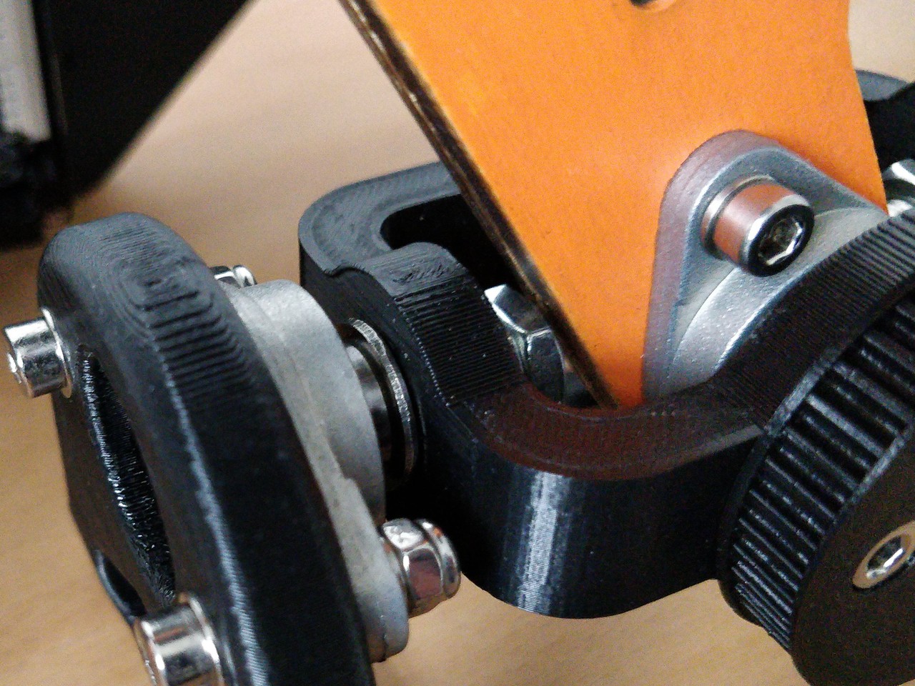
[picture p146: documentation/images/issue_04_no_save_limit_nut_cutting_in_heel.jpg]


*2019-03-29:* The temperature sensors are very tightly packet in the motor box. If they get too close to the motor pin than a short circuit is likely, which may result in a irreversibly damaged/dead processor of the sensorimotor as soon as the H-bridge is powered for the first time. Workaround: Double check for short circuits and don't push too tight when closing the motor cover. This may indicate that your motor is prone to this problem. You may have to vary the position of the temp-sensor as shown in the picture. Don't connect voltage to boards with unsolved shortcircuits.

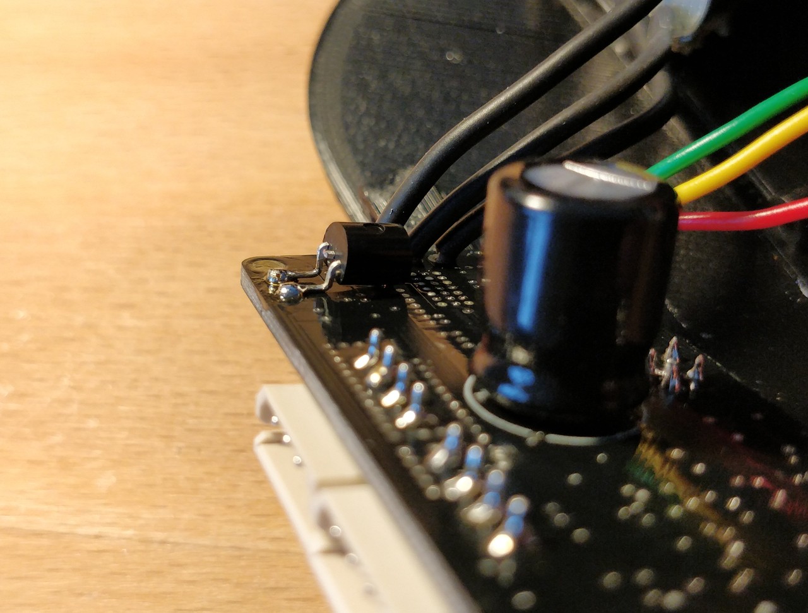
[picture p147: documentation/images/issue_05_tempsensor_too_close_to_motor_wire.jpg]
