aibrainag/Gretchen/why_gretchen.pdf

Gretchen Humanoids for Everyone.

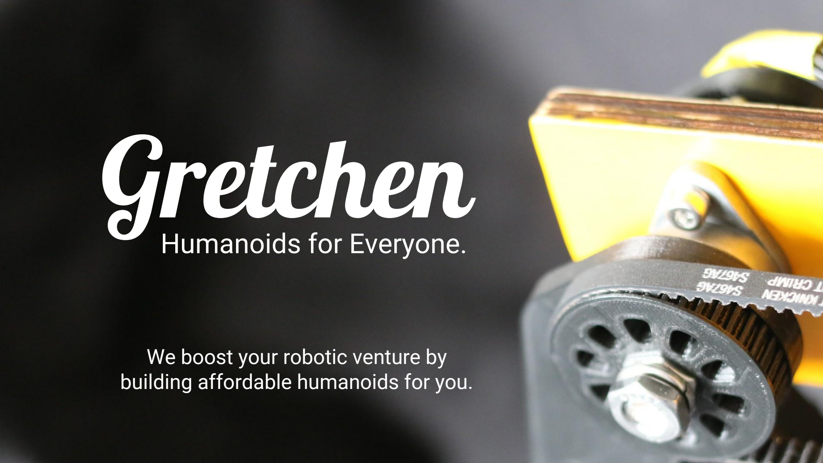
[picture p148: page 1]

### We boost your robotic venture by

building affordable humanoids for you.

# Gretchen

Robot Development Platform

### Humanoid Robots can be amazing general purpose helpers but are…

hard to build and expensive.

# The Problem

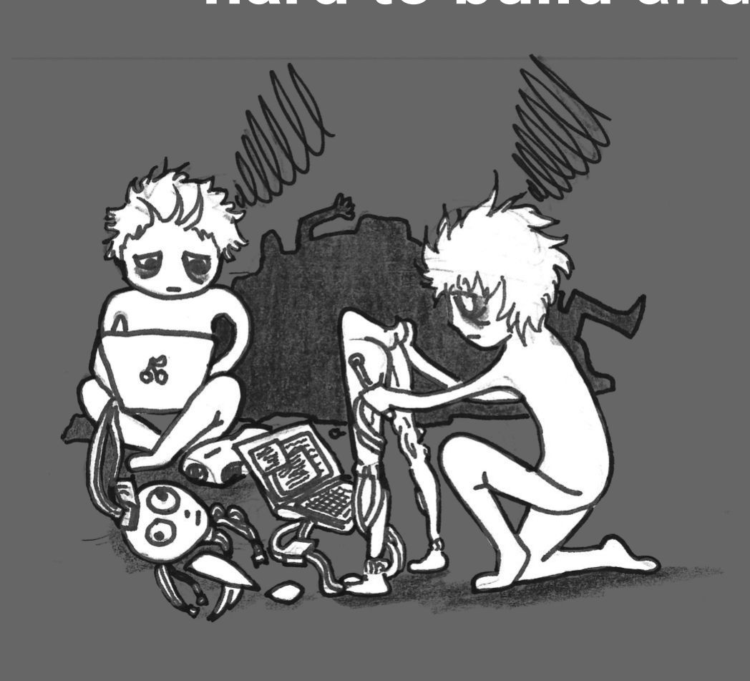
[picture p149: figure]
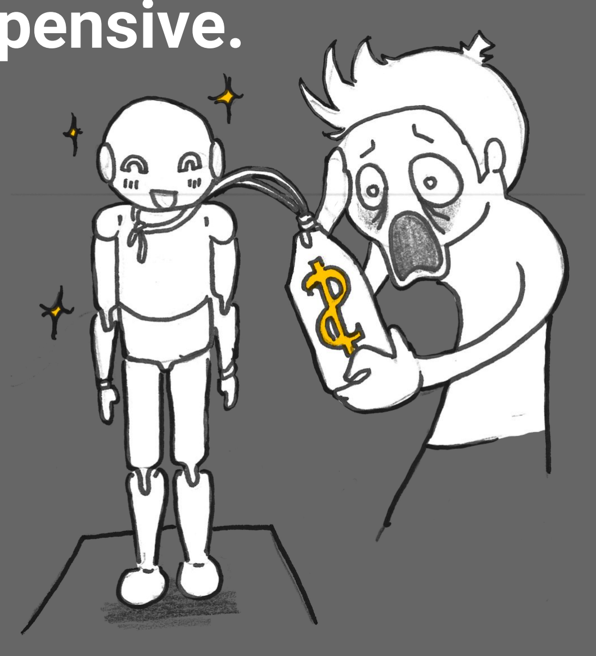
[picture p150: figure]

So any ventures with Humanoid Robots suffer from:

- High financial risk
- Long development times
- Lack of specialists
- Uneconomic business
models

currently solved with:

- Developing from scratch
- Buying expensive hardware
- Using incapable toy robots
- Keep on dreaming their idea

# Gretchen

# Our Solution

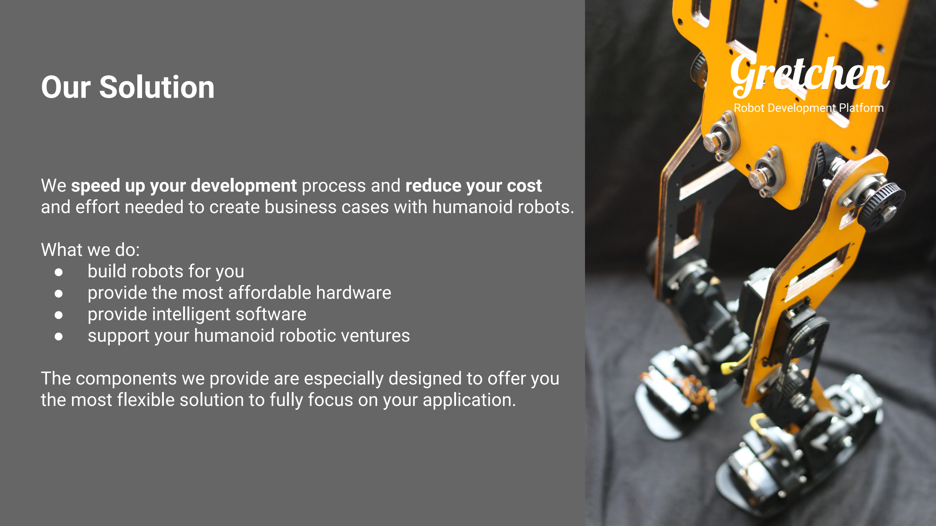
[picture p151: page 3]

Robot Development Platform

We speed up your development process and reduce your cost and effort needed to create business cases with humanoid robots.

What we do:
- build robots for you
- provide the most affordable hardware
- provide intelligent software
- support your humanoid robotic ventures

The components we provide are especially designed to offer you the most flexible solution to fully focus on your application.

# Gretchen

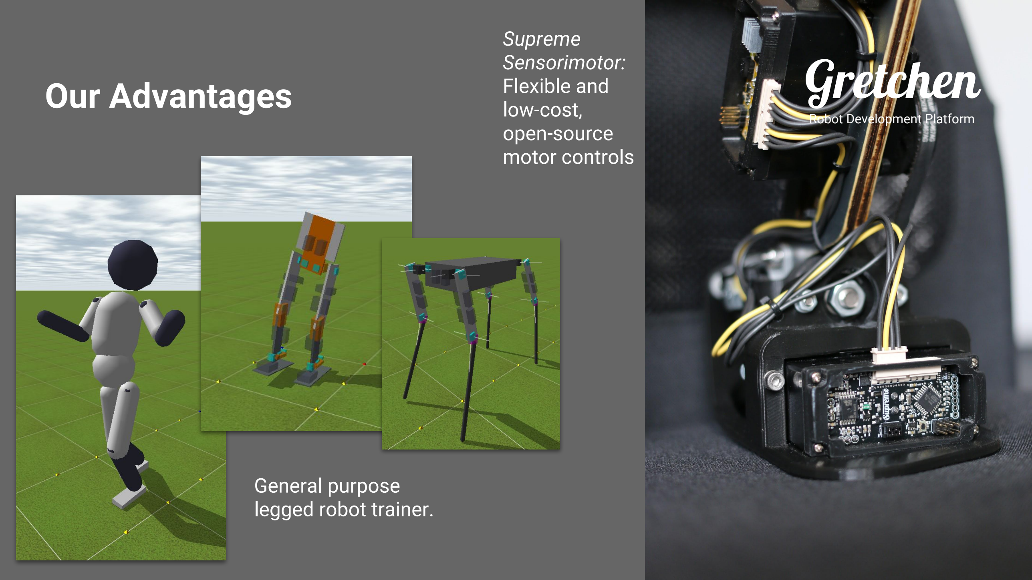
[picture p152: page 4]

Robot Development Platform Our Advantages

General purpose
legged robot trainer.

Supreme Sensorimotor:

| Flexible and low-cost, open-source
| | motor controls

# Gretchen

Robot Development Platform

# Product Line

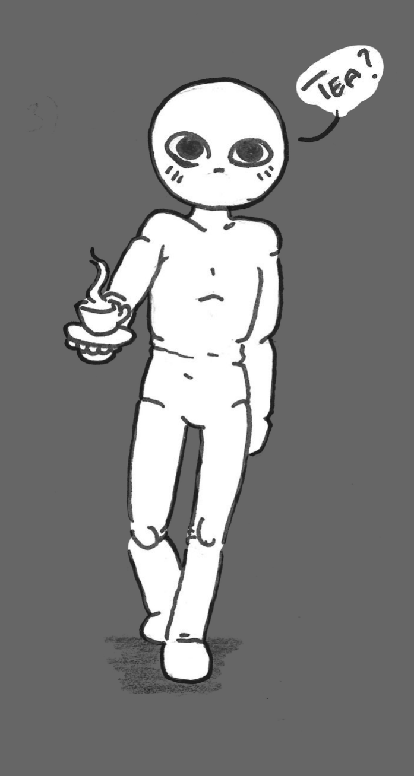
[picture p153: figure]
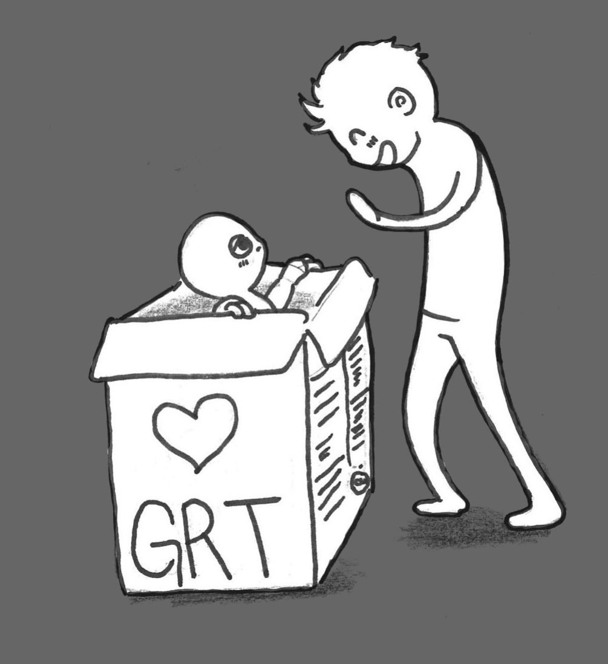
[picture p154: figure]
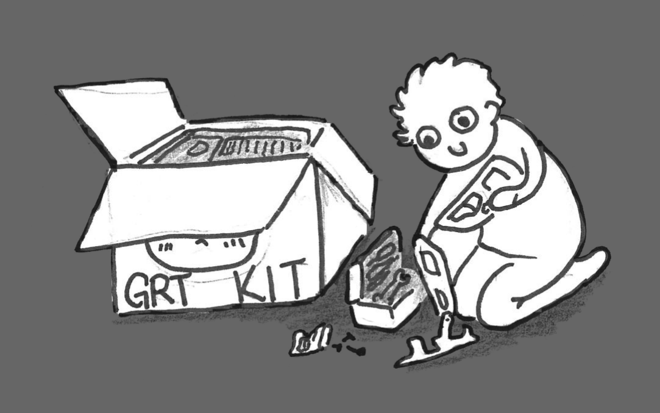
[picture p155: figure]

Construction Kit | Fully assembled | Application Design

# Gretchen

# Development Milestones

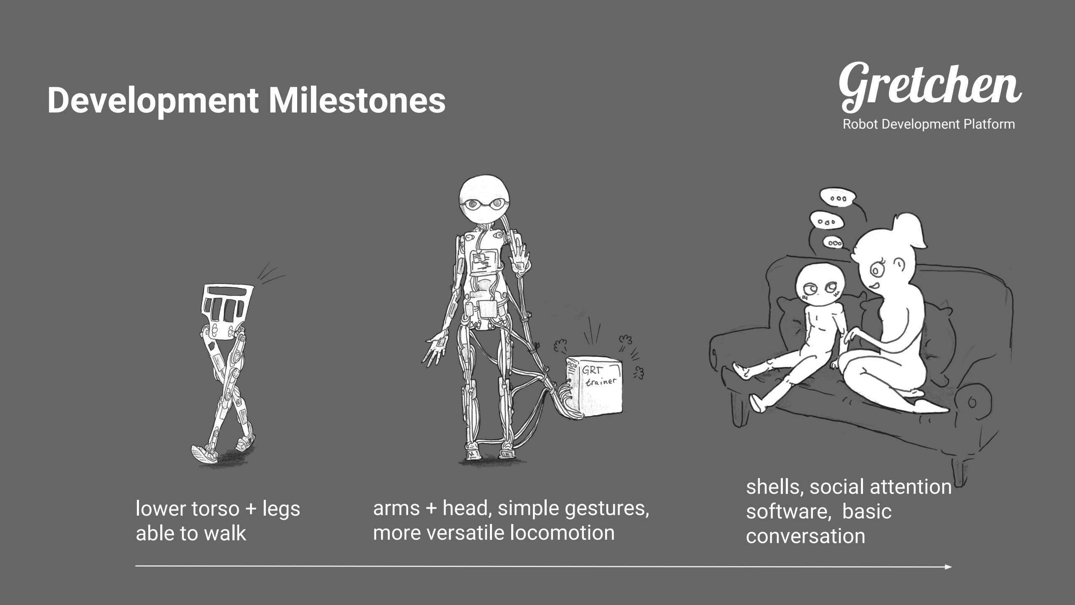
[picture p156: page 6]

Robot Development Platform

lower torso + legs
able to walk

arms + head, simple gestures, more versatile locomotion

shells, social attention
software, basic
conversation

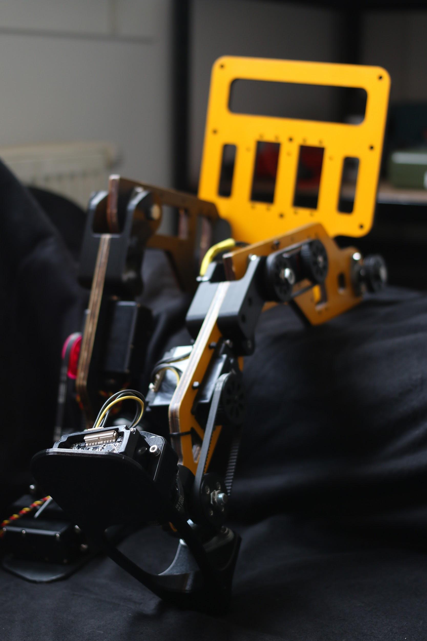
[picture p157: figure]

# Gretchen

Robot Development Platform

As AIbrain,

… we build perceptive humanoid robots, … and develop their applications,

### … with the most affordable solutions … to boost your robotics venture

### … and finally seek to bring humanoid

robots in every home and company.
