aibrainag/Gretchen/documentation/datasheets/KFL-08_foto.jpg

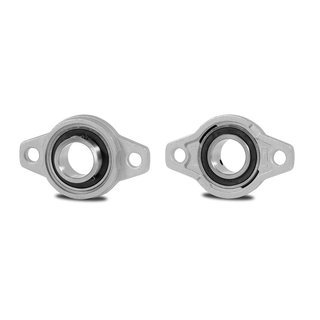
documentation/datasheets/KFL-08_foto.jpg
