aibrainag/Gretchen/documentation/datasheets/KFL-08_front.jpg

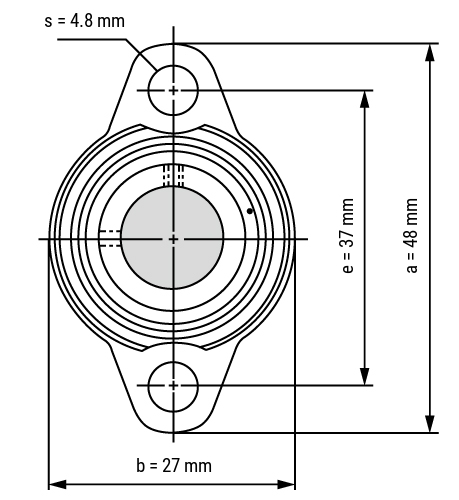
documentation/datasheets/KFL-08_front.jpg
