aibrainag/Gretchen/documentation/datasheets/KFL-08_side.jpg

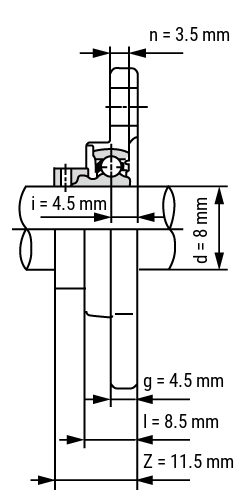
documentation/datasheets/KFL-08_side.jpg
