aibrainag/Gretchen/documentation/datasheets/sensor-GY-291.sch.jpg

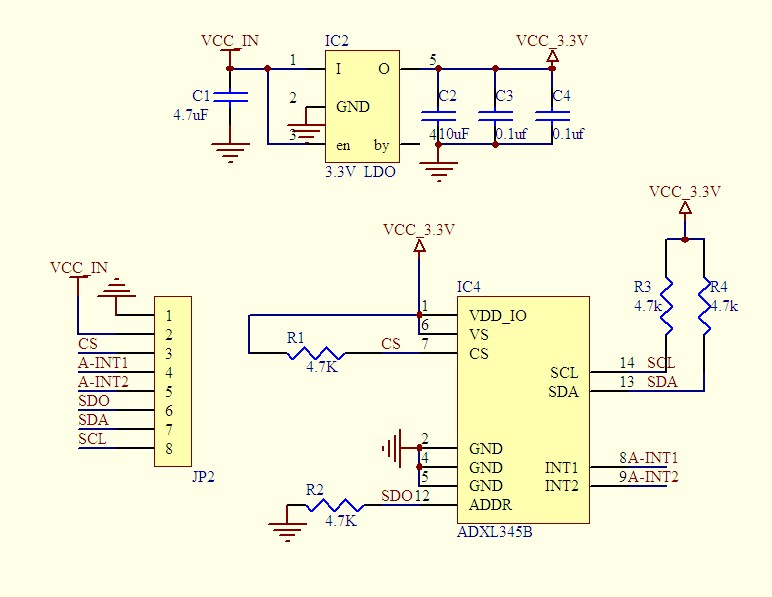
documentation/datasheets/sensor-GY-291.sch.jpg
