aibrainag/Gretchen/documentation/images/sensorimotor_ready.jpg

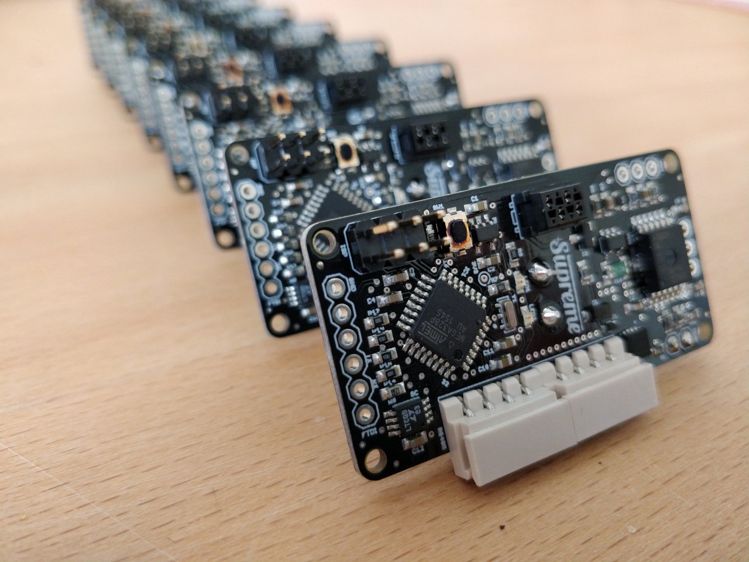
documentation/images/sensorimotor_ready.jpg
