aibrainag/Gretchen/pictures/2018-08-27_grt_dev0.png

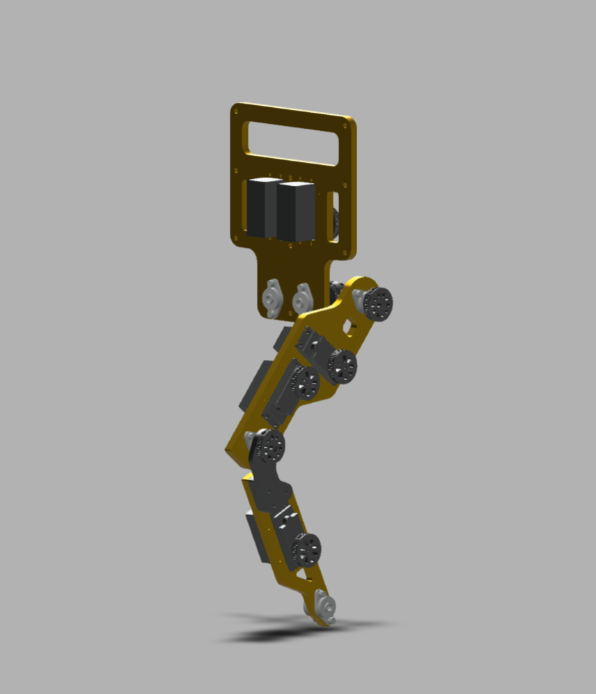
pictures/2018-08-27_grt_dev0.png
