aibrainag/Gretchen/pictures/gretchen_standing.jpg

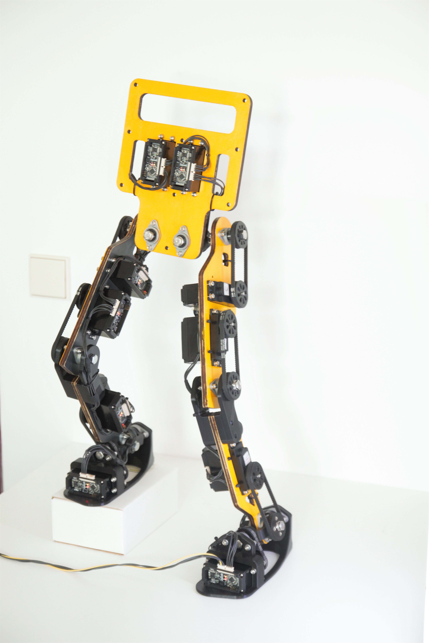
pictures/gretchen_standing.jpg
