aibrainag/Gretchen/pictures/matthias_gretchen.jpg

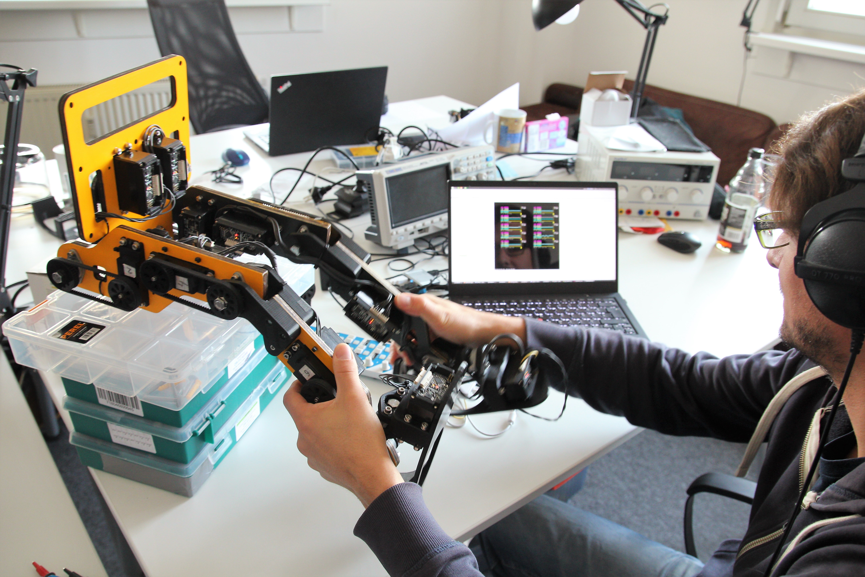
pictures/matthias_gretchen.jpg
