aibrainag/Gretchen/hardware/grt_dev0.bom.ods

Position | Anzahl / lfm | Preis | Preis auf Anzahl | Distributor | Art.-Nr. | Herstellerbezeichnung
Plywood 5mm, 1m² | 1 | 15,00 € | 15,00 € | Hardware Store |  | (to be lasercut or milled)
Flange Pillow Block Bearing KFL08 | 20 | 3,78 € | 75,60 € | Kugellager-Express | KFL-08-ST | Miniatur-Flanschlager KFL08 / Welle: 8 mm (Silber-Serie)
Timing Belt GT3, U=303mm, D=6mm | 8 | 7,01 € | 56,08 € | Zahnriemen24 | 313151 | Gates POWERGRIP® GT3 303-3MGT-6
Timing Belt GT3, U=174mm, D=6mm | 2 | 6,21 € | 12,42 € | Zahnriemen24 | 313127 | Gates POWERGRIP® GT3 174-3MGT-6
Hitec Servo Motor | 10 | 55,00 € | 550,00 € | Hitec-Multiplex | -
Belt-Idler (optional) | 24 | 1,40 € | 33,60 € | Via Amazon | - | GT2 Toothless-Idler Aluminium Dual ballbearing 3 mm Bore, 6mm width
Felt for Feet | 2 | 3,00 € | 6,00 € | Hardware Store | -
Nuts + Bolts
M8 DIN 439, Hex nut, flat form A2 | 28 | 0,07 € | 2,07 € | SC-Normteile | AV2-0439-2-080-100 | Hex Nut (flat Form), M8, DIN 439 / ISO 4035 - stainless Steel A2 (V2A)
M8 DIN 127, Split Lock Spring Washers | 16 | 0,01 € | 0,22 € | Schrauben-niro.de | USF M8 A2 DIN 127 | DIN 127 M8 Form B; Material A1; Ø max: 14,8 mm; Ø min: 8,1 mm
M8 DIN 912, Threaded Bolt, L=70mm, Hex Head, A2 | 2 | 0,25 € | 0,49 € | Schrauben-niro.de | GWSM8x70 A2 sk | DIN 933 M8 x 70 mm A2-70 hex SW13
M8 DIN 912, Threaded Bolt, L=60mm, Hex Head, A2 | 6 | 0,22 € | 1,34 € | Schrauben-niro.de | GWSM8x60 A2 sk | DIN 933 M8 x 60 mm A2-70 hex SW13
M8 DIN 912, Threaded Bolt, L=40mm, Hex Head, A2 | 2 | 0,13 € | 0,27 € | Schrauben-niro.de | GWSM8x40 A2 sk | DIN 933 M8 x 40 mm A2-70 hex SW13
M8 DIN 912, Threaded Bolt, L=30mm, Hex Head, A2 | 2 | 0,13 € | 0,26 € | Schrauben-niro.de | GWSM8x30 A2 sk | DIN 933 M8 x 30 mm A2-70 hex SW13
M4 DIN 912, Threaded Bolt, L=40mm, Cylinder head, A2 | 4 | 0,07 € | 0,29 € | Schrauben-niro.de | ZKSM4x40 A2 zy | DIN 912 M4x40 rd mm A2-50 Cylinder head, hex socket 3 mm
M4 DIN 912, Threaded Bolt, L=30mm, Cylinder head, A2 | 2 | 0,05 € | 0,10 € | Schrauben-niro.de | ZKSM4x30 A2 zy | DIN 912 M4x30 rd mm A2-50 Cylinder head, hex socket 3 mm
M4 DIN 912, Threaded Bolt, L=25mm, Cylinder head, A2 | 16 | 0,04 € | 0,66 € | Schrauben-niro.de | ZKSM4x25 A2 zy | DIN 912 M4x25 rd mm A2-50 Cylinder head, hex socket 3 mm
M4 DIN 912, Threaded Bolt, L=20mm, Cylinder head, A2 | 48 | 0,04 € | 1,76 € | Schrauben-niro.de | ZKSM4x20 A2 zy | DIN 912 M4x20 rd mm A2-70 Cylinder head, hex socket 3 mm
M4 DIN 912, Threaded Bolt, L=12mm, Cylinder head, A2 | 16 | 0,02 € | 0,38 € | Schrauben-niro.de | ZKSM4x12 A2 zy | DIN 912 M4x12 rd mm A2-70 Cylinder head, hex socket 3 mm
M4 DIN 985, Locknut | 64 | 0,02 € | 1,16 € | Schrauben-niro.de | KMU M4 A2 sk | DIN 985 Material: A2-70 SW: 7; mit Polyamidklemmteil, niedrige Form (Standard)
M4 DIN 125, Standard Washer | 48 | 0,00 € | 0,19 € | Schrauben-niro.de | USS M4 A2 DIN 125 | DIN 125 M4 Ø max: 9 mm Ø min: 4,3 mm Thickness: 0,8 mm
M4 DIN 127, Split Lock Spring Washers | 80 | 0,00 € | 0,22 € | Schrauben-niro.de | USF M4 A2 DIN 127 | DIN 127 M4 Form B, Material A1; Ø max: 7,6 mm; Ø min: 4,1 mm
M2 DIN 912, Threaded Bolt, L=30mm, Hex Head, A2 | 20 | 0,09 € | 1,88 € | Schrauben-niro.de | ZKSM2x30 A2 zy | DIN 912 M2x30 rd mm A2-50 Cylinder head, hex socket 1,5 mm
3D Printed Parts
Pulley for D1 Spline (Hitec Motor) 42T | 8 | 3,00 € | 24,00 € | Supreme/Hannah Parts | - | TODO estimate price by material usage
Pulley for D1 Spline (Hitec Motor) 33T | 2 | 3,00 € | 6,00 € | AIBrain/Gretchen Parts | - | TODO estimate price by material usage
Pulley, M8 Hexnut | 2 | 3,00 € | 6,00 € | Supreme/Hannah Parts | - | TODO estimate price by material usage
Hip X/Y with integrated Pulley | 2 | 6,00 € | 12,00 € | Supreme/Hannah Parts | - | TODO estimate price by material usage
Knee outer, with integrated Pulley | 2 | 6,00 € | 12,00 € | AIBrain/Gretchen Parts | - | TODO estimate price by material usage
Knee inner | 2 | 6,00 € | 12,00 € | AIBrain/Gretchen Parts | - | TODO estimate price by material usage
Foot | 2 | 10,00 € | 20,00 € | AIBrain/Gretchen Parts | - | TODO estimate price by material usage
Gimbal | 2 | 2,00 € | 4,00 € | AIBrain/Gretchen Parts | - | TODO estimate price by material usage
Pulley 42T M4 screw | 2 | 2,00 € | 4,00 € | AIBrain/Gretchen Parts | - | TODO estimate price by material usage
Pulley 33T M4 screw | 2 | 2,00 € | 4,00 € | AIBrain/Gretchen Parts | - | TODO estimate price by material usage
Belt-Tensioner (optional) | 12 | 1,00 € | 12,00 € | Supreme/Hannah Parts | - | TODO estimate price by material usage
Electronics
Sensorimotorplatine Rev. 1.1 | 10 | 42,00 € | 420,00 € | Supreme/Hannah Parts | -
Accel-Sensor ADXL 345 breakout (optional) | 1 | 5,00 € | 5,00 € | Amazon | - | z.B. GY-291
Temperature Sensor | 10 | 0,67 € | 6,70 € | Reichelt | KTY 81-110 | Temperatursensor, PTC, 1 kOhm, -55...+150°C
Electrolytic Capacitor | 10 | 0,23 € | 2,30 € | Reichelt | FM-A 220U 35A | E-Cap radial, 220 uF, 35 V, 105°C, low ESR
Cabling
Data cable, silicone, black | 20 | 1,86 € | 37,20 € | Conrad | 606649 | SIL-SIFF 1X0,25 (0,05MM TINNED) BLACK
Data cable, silicone, red | 5 | 1,86 € | 9,30 € | Conrad | 606608 | SIL-SIFF 1X0,25 (0,05MM TINNED) RED
Molex Sockets for Sensorimotor | 20 | 0,14 € | 2,80 € | Reichelt | MOLEX 22057045 | Molex Stiftleiste 90° - Mini-SPOX - 1x4-polig – Stecker (10 x 2 Sockets)
Molex SPOX Plug 4pin | 20 | 0,08 € | 1,60 € | Reichelt | MOLEX 50375043 | Molex Crimpgehäuse - Mini-SPOX - 1x4-polig – Buchse
Molex SPOX crimp terminals | 100 | 0,08 € | 8,00 € | Reichelt | MOLEX 8701040 | Molex Crimpkontakt - Mini-SPOX – Buchse (including some spare)
Pinheader 2x3 pin | 10 | 0,14 € | 1,40 € | Reichelt | MPE 087-2-006 | Stiftleisten gerade 2x3
Termination resistor | 6 | 0,08 € | 0,49 € | Reichelt | METALL 220 | Resistor, 220 Ohm, 0207, 0,6 W, 1%
Sleeving | 2 | 1,34 € | 2,68 € | Reichelt | LAPP 61721260 | SILVYN® BRAID PA6 - 6 mm, schwarz
cable ties | 50 | 0,01 € | 0,50 € | Hardware Store |  | slim, small-sized, 2mm width, black
Color + Glue
Color Yellow | 1 | 2,19 € | 2,19 € | Conrad | 209346 | REVELL AQUA LUFTHANSA-GELB SEIDENMATT
Color Anthrazit | 1 | 2,19 € | 2,19 € | Conrad | 209321 | REVELL AQUA ANTHRAZIT MATT
Loctite | 1 | 7,00 € | 7,00 € | Hardware Store | - | e.g. Loctite 243 Threadlocker medium strength 5 ml
Wood glue | 1 | 5,00 € | 5,00 € | Hardware Store | - | e.g. Pattex/Ponal Express, 100ml
 |  | nur 3dp
Summe: | 1.373,47 € | 116,00 €
 |  |  |  |  | 0,053333333333333
 |  |  |  |  | Filament cost per g
