aibrainag/Gretchen/hardware/export/camera_gimbal_intel/gimbal_bearing_adapter v10.stl

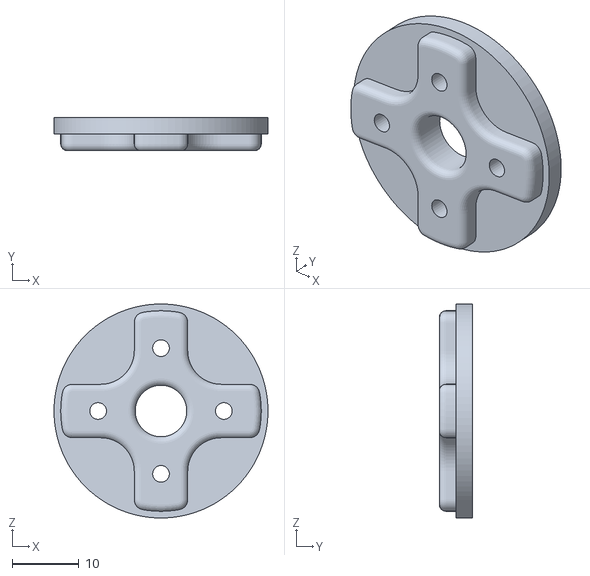
[picture p166: CAD file, 2019-07-08]
hardware/export/camera_gimbal_intel/gimbal_bearing_adapter v10.stl
32.0 x 5.00 x 32.0
