aibrainag/Gretchen/hardware/export/dxf_contour/grt_torso_contour_20180826.dxf

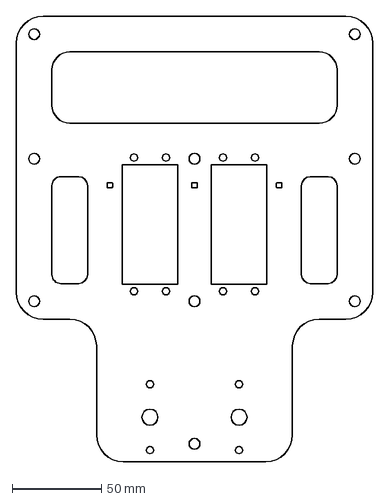
[picture p167: CAD file, 2019-02-26]
hardware/export/dxf_contour/grt_torso_contour_20180826.dxf
200.0 x 250.0 mm
