aibrainag/Gretchen/hardware/export/grt_foot_motor_pulley_33T_20190328.stl

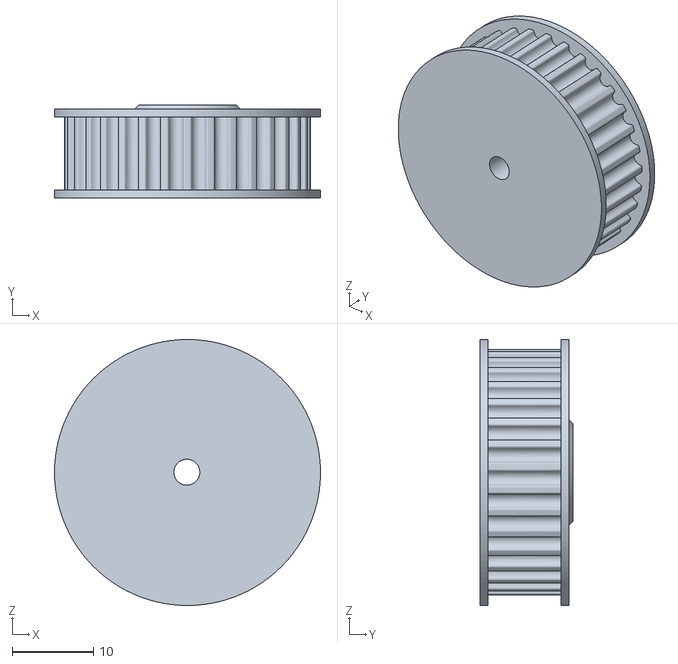
[picture p168: CAD file, 2019-03-28]
hardware/export/grt_foot_motor_pulley_33T_20190328.stl
32.8 x 11.5 x 32.8
