aibrainag/Gretchen/hardware/export/shells/thigh_1_inner_upper.stl

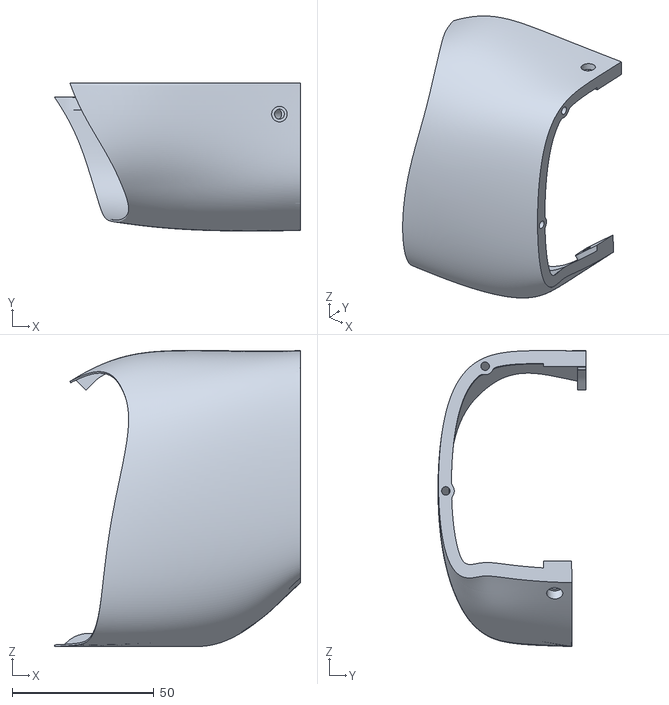
[picture p169: CAD file, 2019-06-23]
hardware/export/shells/thigh_1_inner_upper.stl
87.0 x 52.3 x 104.6
