aibrainag/Gretchen/hardware/export/camera_gimbal_intel/gimbal_upper_intel v26.stl

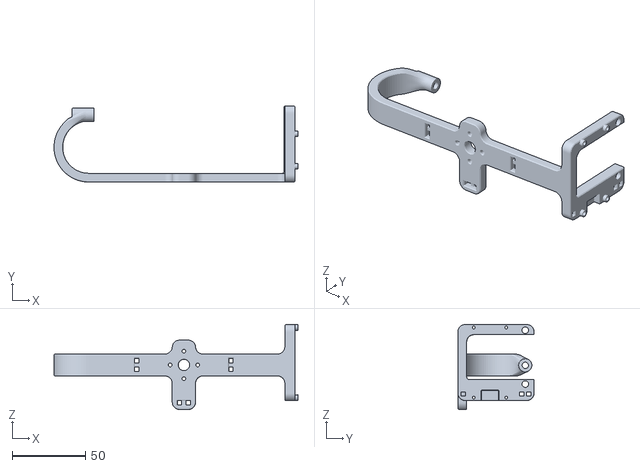
[picture p170: CAD file, 2019-07-08]
hardware/export/camera_gimbal_intel/gimbal_upper_intel v26.stl
166.6 x 52.0 x 58.1
