aibrainag/Gretchen/hardware/export/dxf_contour/grt_shank_contour_20190218.dxf

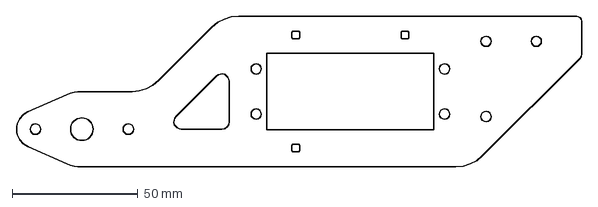
[picture p171: CAD file, 2019-02-26]
hardware/export/dxf_contour/grt_shank_contour_20190218.dxf
225.0 x 60.0 mm
