aibrainag/Gretchen/hardware/export/grt_cardan_joint_pulley_33T_20190328.stl

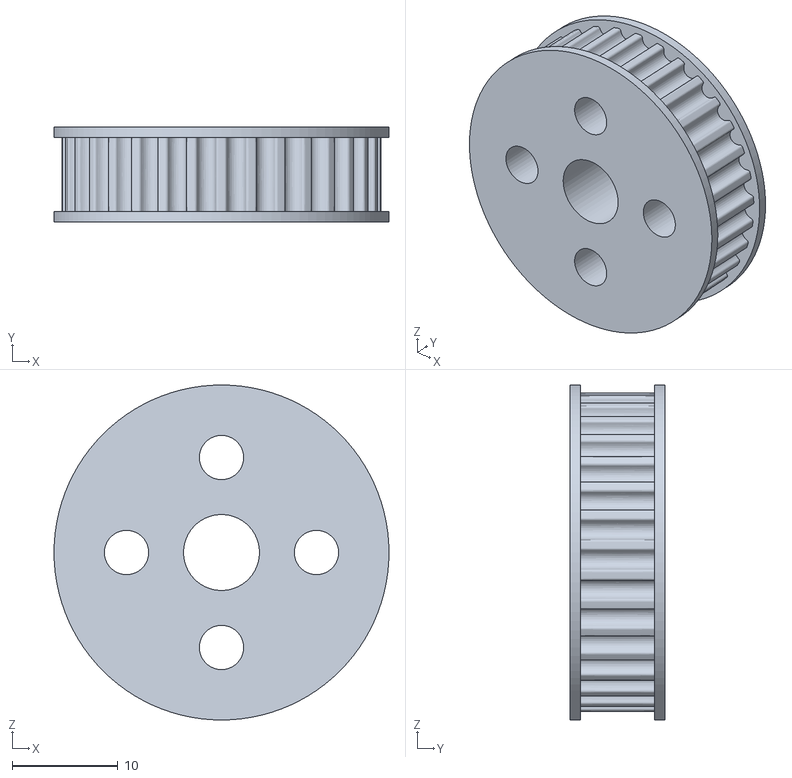
[picture p172: CAD file, 2019-03-28]
hardware/export/grt_cardan_joint_pulley_33T_20190328.stl
31.8 x 9.00 x 31.8
