aibrainag/Gretchen/hardware/export/shells/thigh_adapter_front.stl

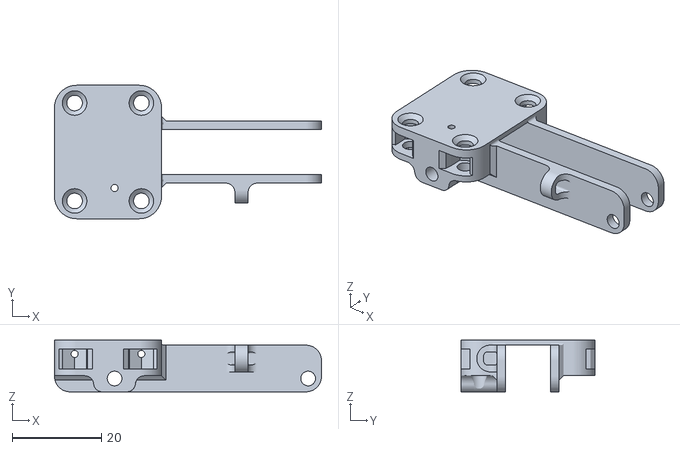
[picture p173: CAD file, 2019-06-23]
hardware/export/shells/thigh_adapter_front.stl
60.0 x 30.0 x 11.6
