aibrainag/Gretchen/hardware/export/belt-tightener.stl

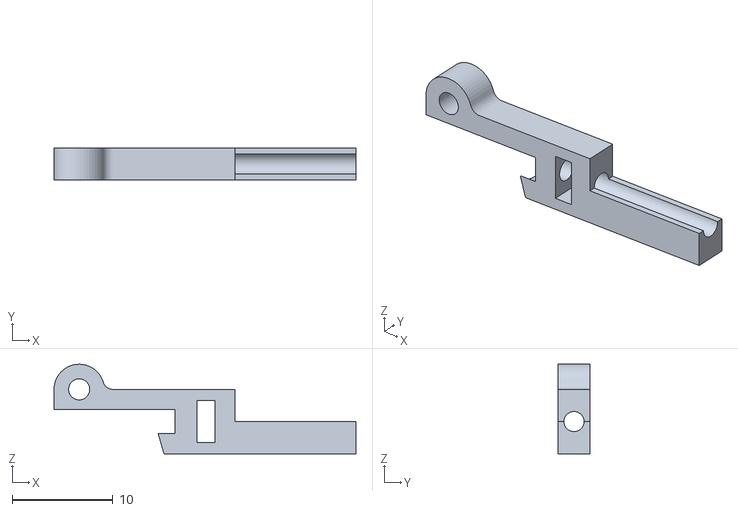
[picture p174: CAD file, 2019-03-28]
hardware/export/belt-tightener.stl
30.0 x 3.20 x 8.90
