aibrainag/Gretchen/hardware/export/camera_gimbal_intel/bearing_holder_v20.stl

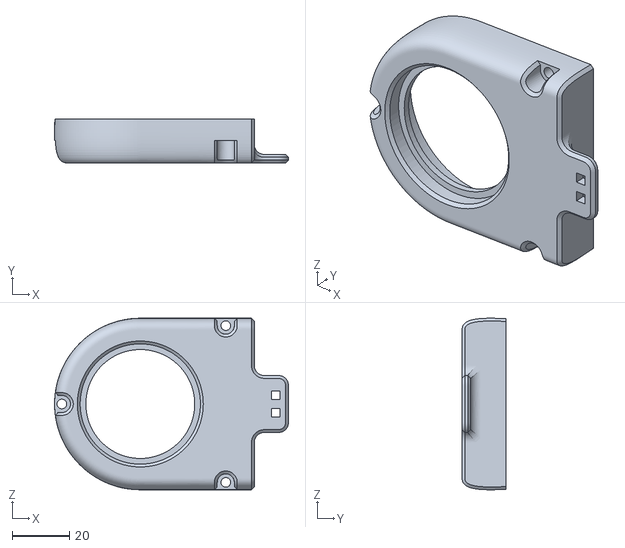
[picture p175: CAD file, 2019-07-08]
hardware/export/camera_gimbal_intel/bearing_holder_v20.stl
82.1 x 15.4 x 60.2
