aibrainag/Gretchen/hardware/export/dxf_contour/grt_torso_contour_20190218.dxf

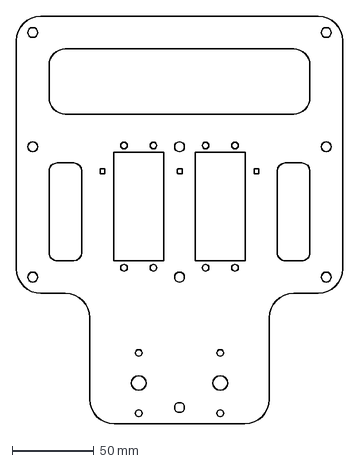
[picture p176: CAD file, 2019-02-26]
hardware/export/dxf_contour/grt_torso_contour_20190218.dxf
200.0 x 250.0 mm
