aibrainag/Gretchen/hardware/export/shells/thigh_3_outer_upper (M).stl

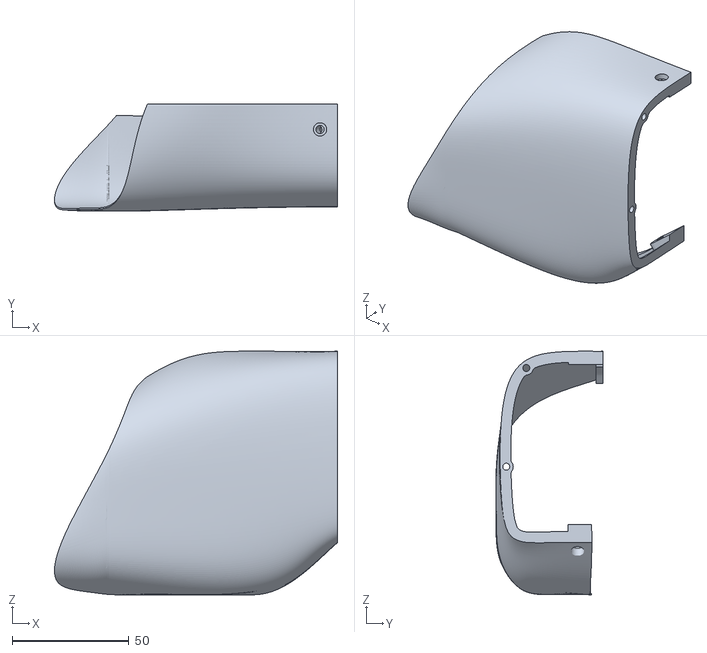
[picture p177: CAD file, 2019-06-23]
hardware/export/shells/thigh_3_outer_upper (M).stl
121.4 x 46.1 x 104.5
