aibrainag/Gretchen/hardware/export/camera_gimbal_intel/gimbal_inner_intel v11.stl

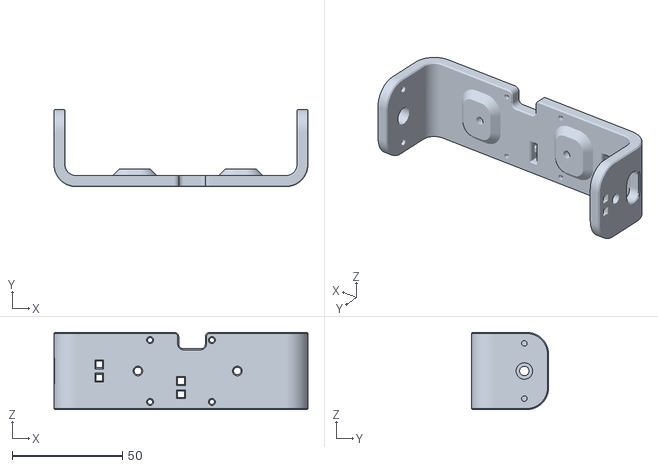
[picture p178: CAD file, 2019-07-08]
hardware/export/camera_gimbal_intel/gimbal_inner_intel v11.stl
115.0 x 35.0 x 35.0
