aibrainag/Gretchen/hardware/export/supreme_GT3_pulley_42T_7mm_d1_spline_20190307.stl

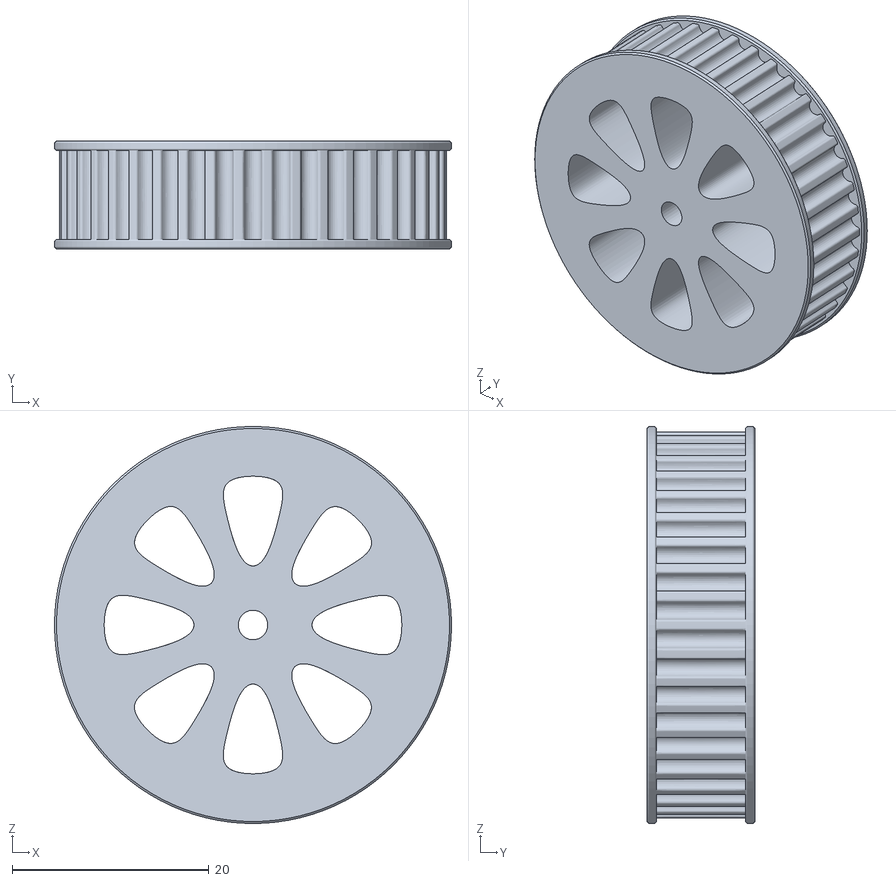
[picture p180: CAD file, 2019-03-28]
hardware/export/supreme_GT3_pulley_42T_7mm_d1_spline_20190307.stl
40.3 x 11.0 x 40.3
