aibrainag/Gretchen/hardware/export/camera_gimbal_intel/gimbal_base_intel v17.stl

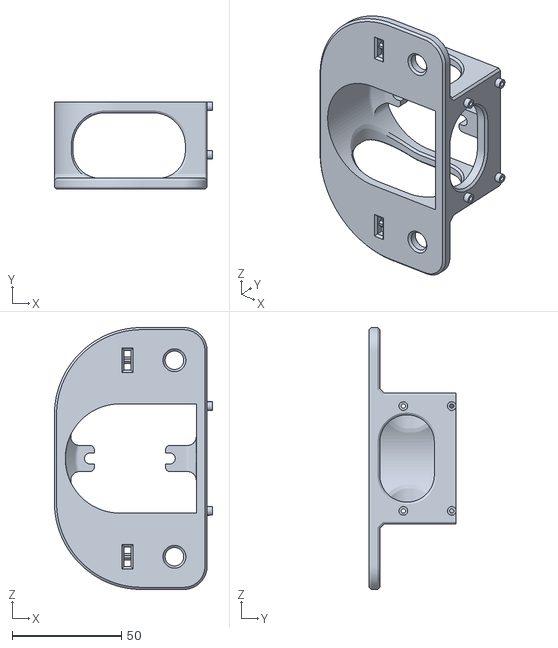
[picture p181: CAD file, 2019-07-08]
hardware/export/camera_gimbal_intel/gimbal_base_intel v17.stl
72.5 x 40.0 x 120.0
