aibrainag/Gretchen/hardware/export/dxf_contour/grt_thigh_contour_20180826.dxf

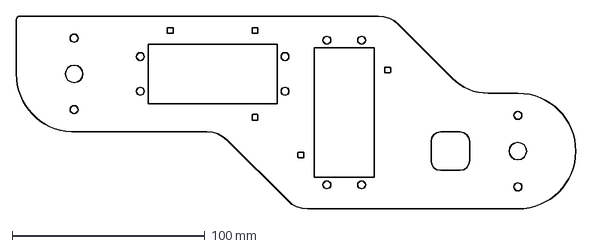
[picture p182: CAD file, 2019-02-26]
hardware/export/dxf_contour/grt_thigh_contour_20180826.dxf
290.0 x 100.0 mm
