aibrainag/Gretchen/hardware/export/grt_cardan_joint_pulley_42T_20190328.stl

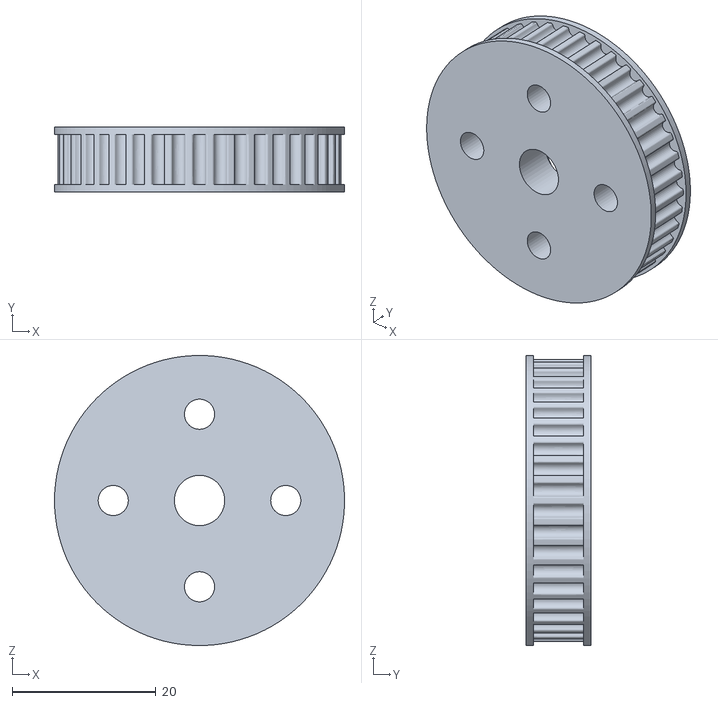
[picture p183: CAD file, 2019-03-28]
hardware/export/grt_cardan_joint_pulley_42T_20190328.stl
40.3 x 9.00 x 40.3
