aibrainag/Gretchen/hardware/export/shells/shank_3_inner_upper (M).stl

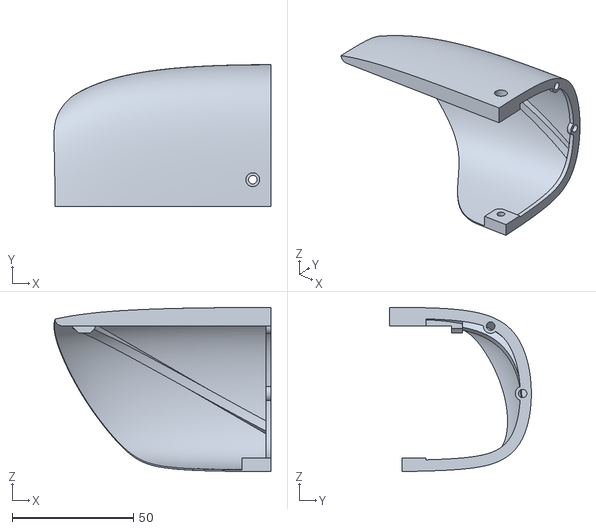
[picture p184: CAD file, 2019-06-23]
hardware/export/shells/shank_3_inner_upper (M).stl
89.5 x 58.5 x 67.7
