aibrainag/Gretchen/hardware/export/dxf_contour/grt_shank_contour_20180826.dxf

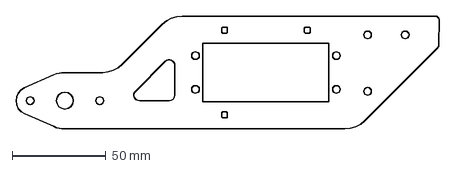
[picture p185: CAD file, 2019-02-26]
hardware/export/dxf_contour/grt_shank_contour_20180826.dxf
225.0 x 60.0 mm
