aibrainag/Gretchen/hardware/export/grt_cardan_joint_20190218.stl

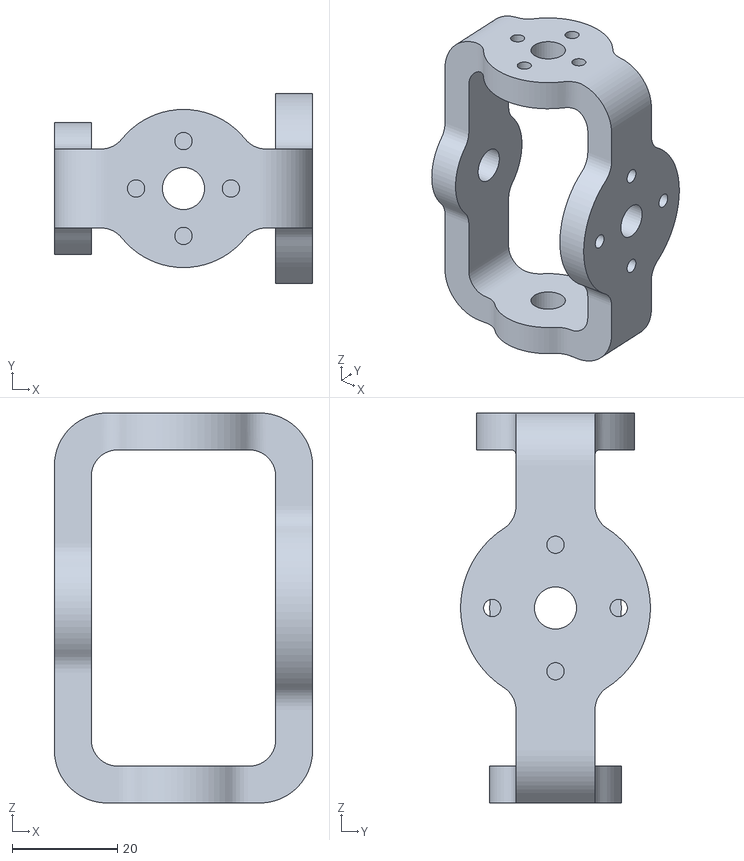
[picture p186: CAD file, 2019-02-26]
hardware/export/grt_cardan_joint_20190218.stl
49.0 x 36.0 x 74.0
