aibrainag/Gretchen/hardware/export/shells/Foot Shell.stl

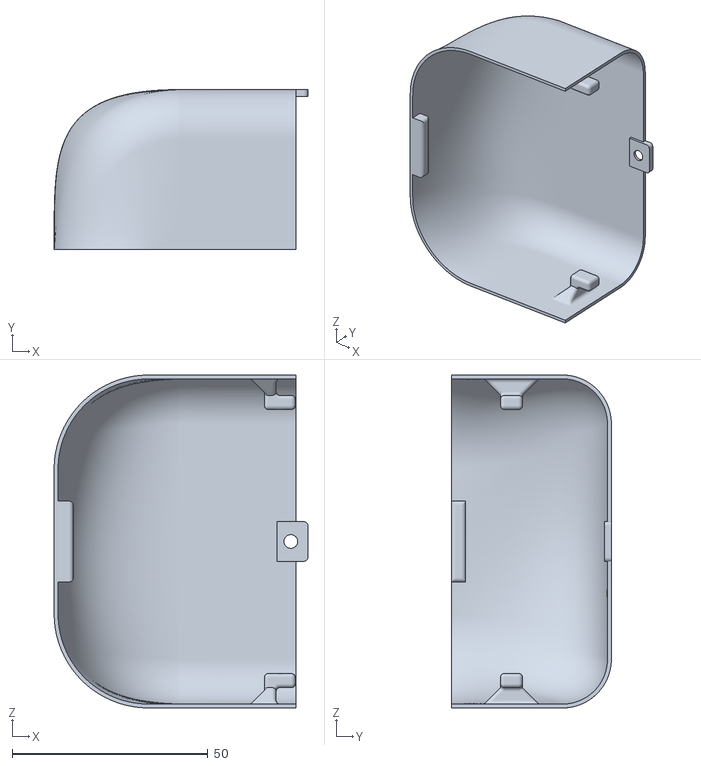
[picture p187: CAD file, 2019-06-23]
hardware/export/shells/Foot Shell.stl
64.8 x 40.8 x 85.0
