aibrainag/Gretchen/hardware/export/grt_knee_20190213.stl

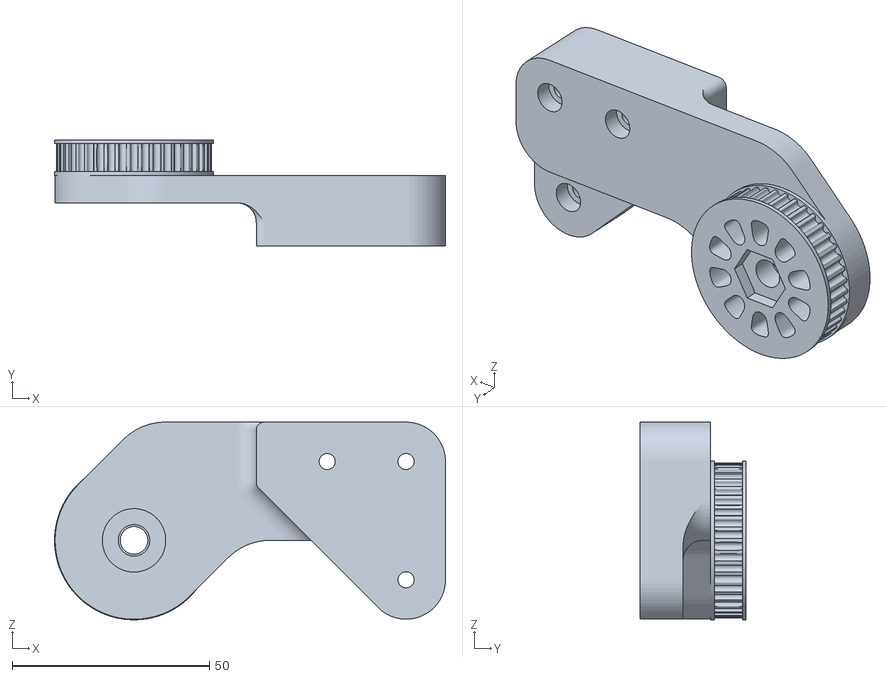
[picture p188: CAD file, 2019-02-26]
hardware/export/grt_knee_20190213.stl
99.2 x 27.0 x 50.2
