aibrainag/Gretchen/hardware/export/shells/shank_1_outer_upper (M).stl

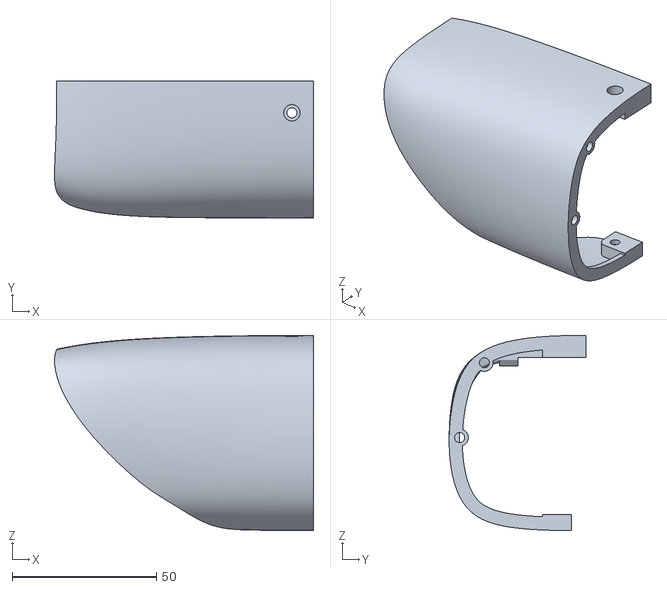
[picture p189: CAD file, 2019-06-23]
hardware/export/shells/shank_1_outer_upper (M).stl
89.9 x 47.5 x 67.8
