aibrainag/Gretchen/hardware/export/shells/thigh_adapter_back_inner(M).stl

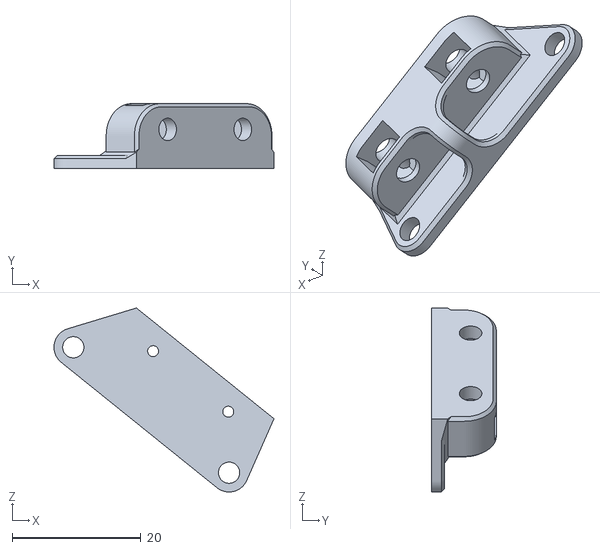
[picture p190: CAD file, 2019-06-23]
hardware/export/shells/thigh_adapter_back_inner(M).stl
34.2 x 10.0 x 28.6
