aibrainag/Gretchen/hardware/export/grt_knee_20180829.stl

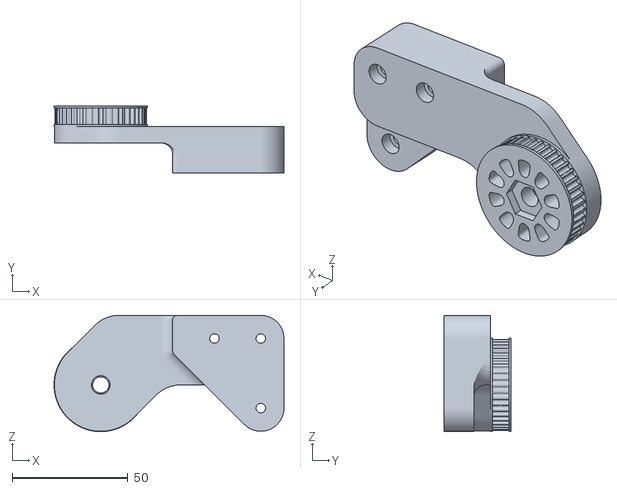
[picture p191: CAD file, 2019-02-26]
hardware/export/grt_knee_20180829.stl
99.2 x 29.0 x 50.2
