aibrainag/Gretchen/hardware/export/grt_knee_inner_20180830.stl

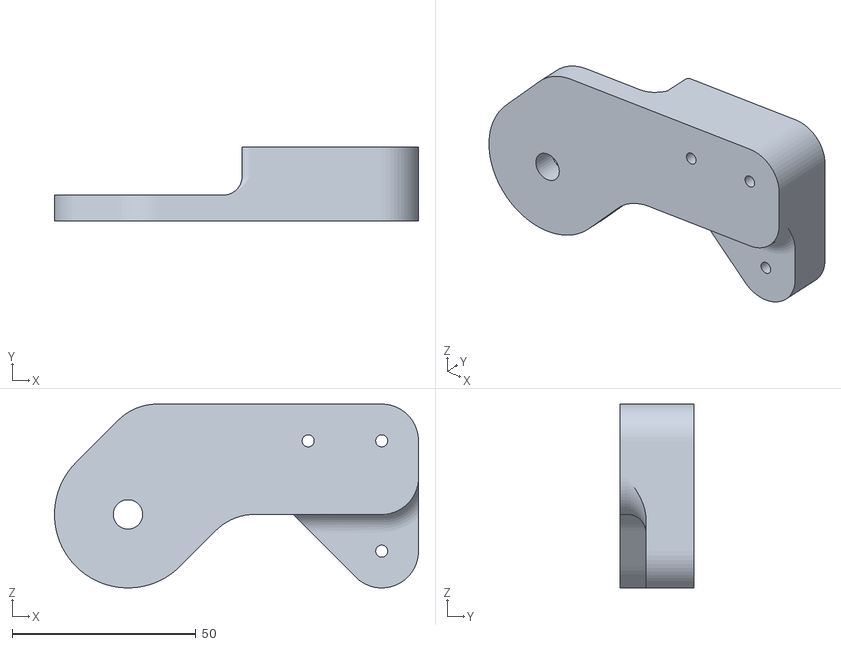
[picture p192: CAD file, 2019-02-26]
hardware/export/grt_knee_inner_20180830.stl
99.0 x 20.0 x 50.0
