aibrainag/Gretchen/hardware/export/shells/shank_4_inner_lower (M).stl

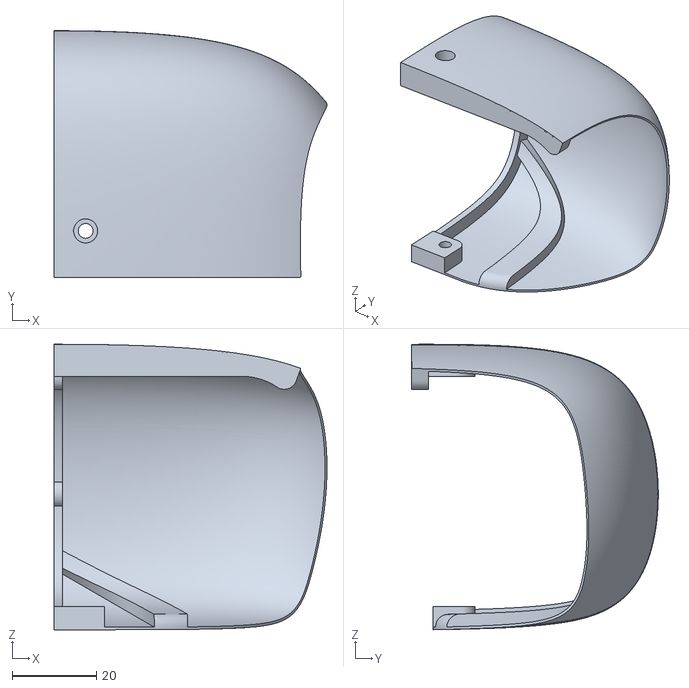
[picture p193: CAD file, 2019-06-23]
hardware/export/shells/shank_4_inner_lower (M).stl
64.7 x 58.5 x 67.7
