aibrainag/Gretchen/hardware/export/supreme_GT3_pulley_42T_7mm_axel_connector_20190121.stl

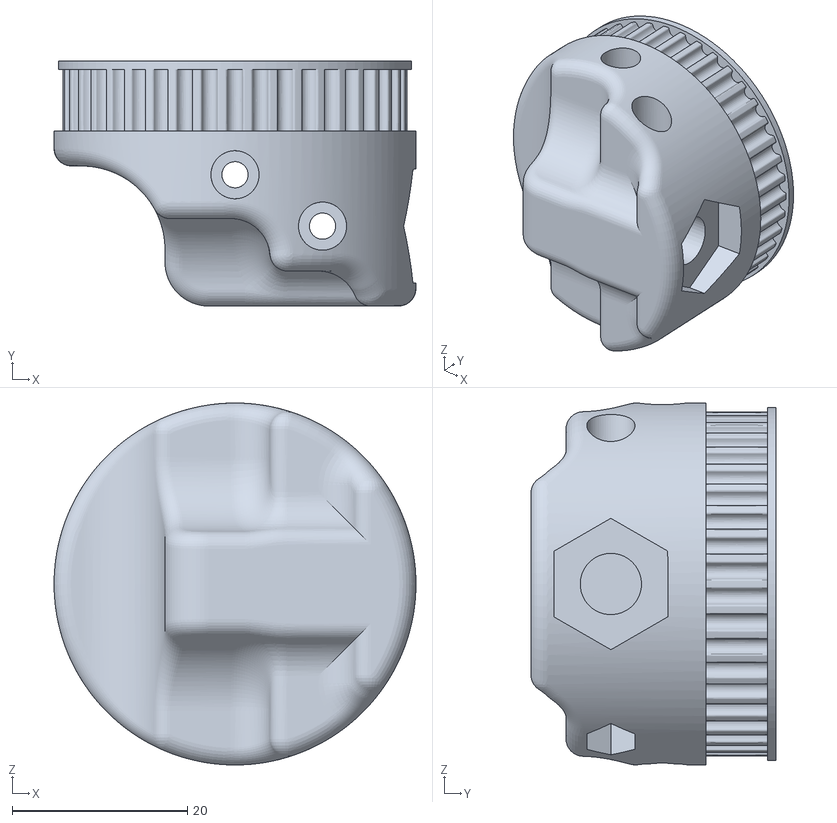
[picture p194: CAD file, 2019-02-26]
hardware/export/supreme_GT3_pulley_42T_7mm_axel_connector_20190121.stl
41.3 x 28.0 x 41.3
