aibrainag/Gretchen/hardware/export/shells/shank_adapter_back.stl

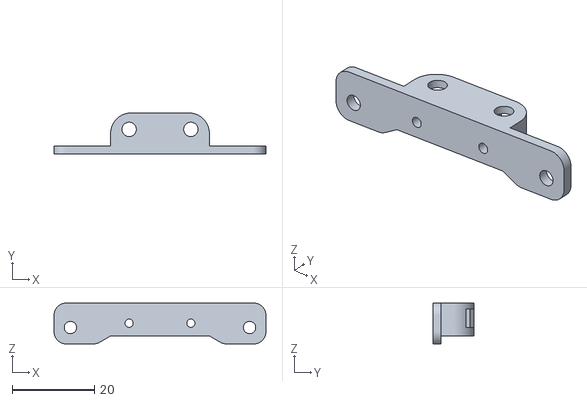
[picture p195: CAD file, 2019-06-23]
hardware/export/shells/shank_adapter_back.stl
51.5 x 10.0 x 9.95
