aibrainag/Gretchen/hardware/export/shells/shank_2_outer_lower.stl

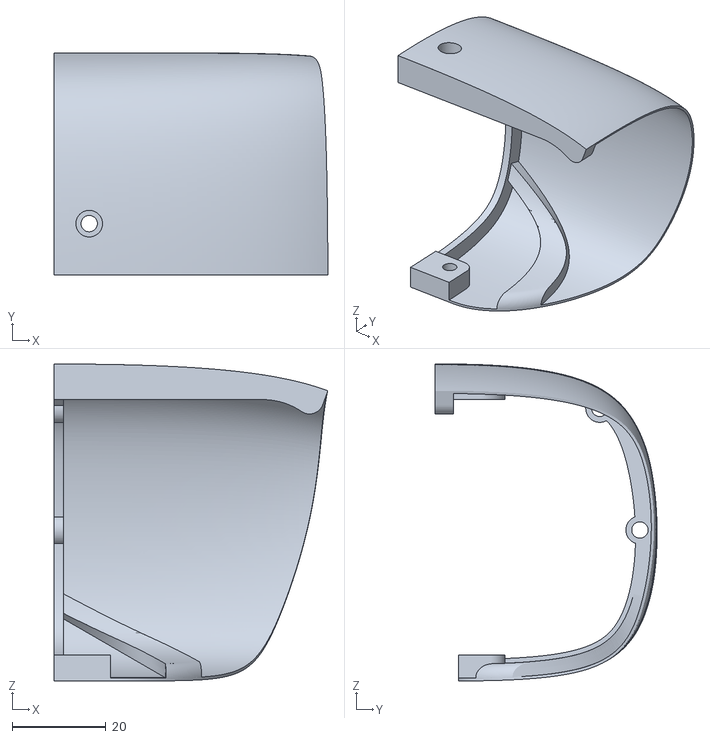
[picture p196: CAD file, 2019-06-23]
hardware/export/shells/shank_2_outer_lower.stl
58.5 x 47.5 x 67.8
