aibrainag/Gretchen/hardware/export/supreme_Hitec_HS805_MG_cap_20190121.stl

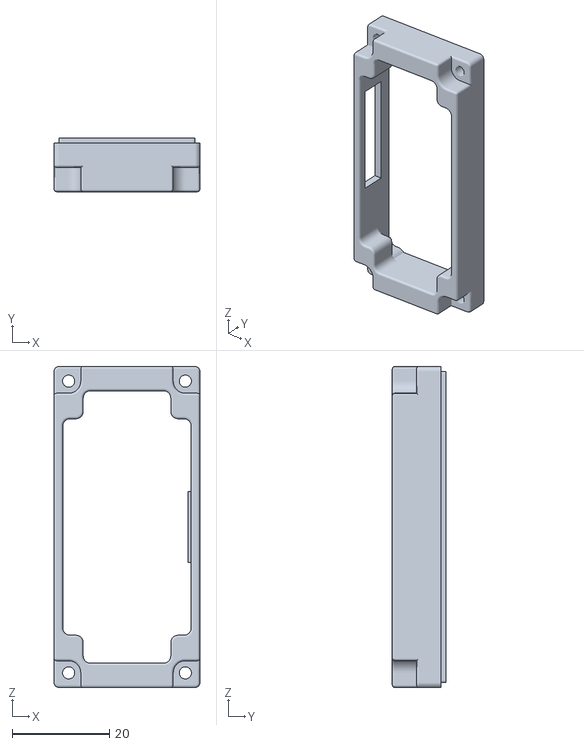
[picture p197: CAD file, 2019-02-26]
hardware/export/supreme_Hitec_HS805_MG_cap_20190121.stl
30.0 x 11.0 x 66.0
