aibrainag/Gretchen/hardware/export/simple_spacer.stl

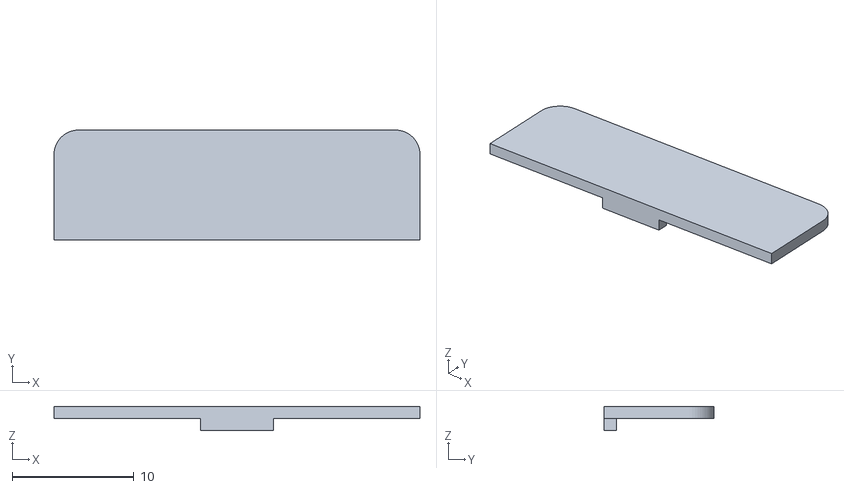
[picture p198: CAD file, 2019-02-26]
hardware/export/simple_spacer.stl
30.0 x 9.00 x 2.00
