aibrainag/Gretchen/hardware/export/shells/shank_adapter_front.stl

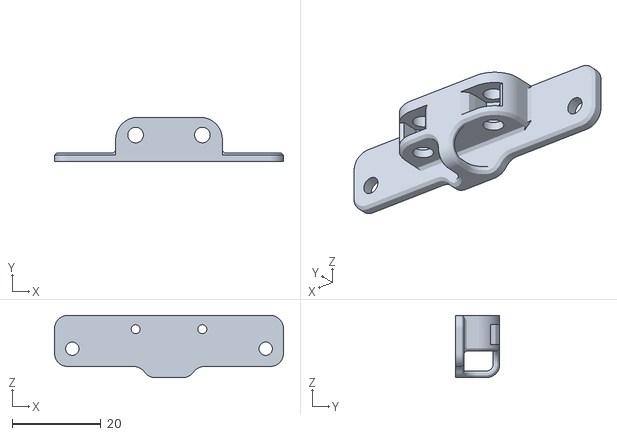
[picture p199: CAD file, 2019-06-23]
hardware/export/shells/shank_adapter_front.stl
51.5 x 10.0 x 14.0
