aibrainag/Gretchen/hardware/export/shells/thigh_4_outer_lower (M).stl

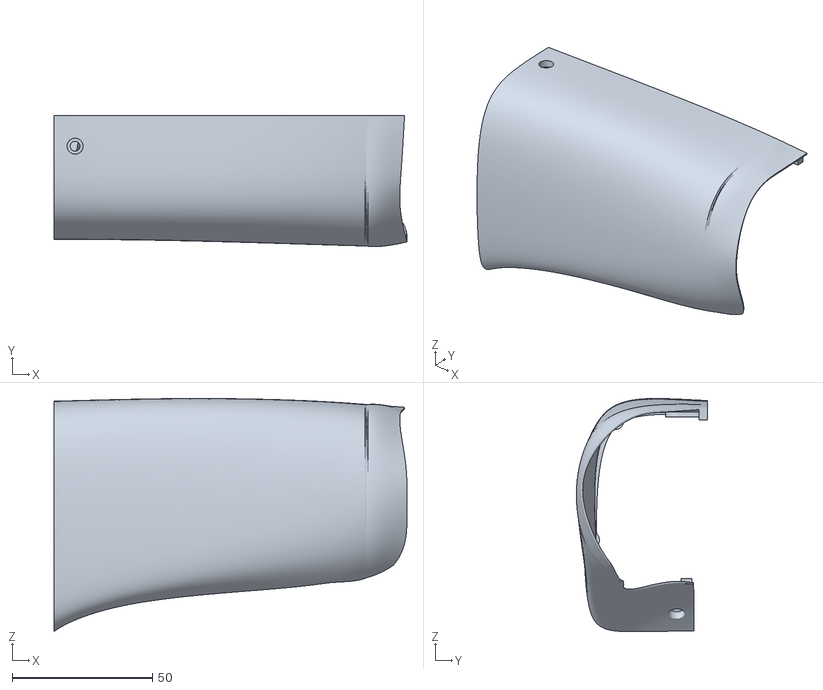
[picture p200: CAD file, 2019-06-23]
hardware/export/shells/thigh_4_outer_lower (M).stl
125.9 x 46.8 x 83.1
