aibrainag/Gretchen/hardware/export/shells/Rect foot.stl

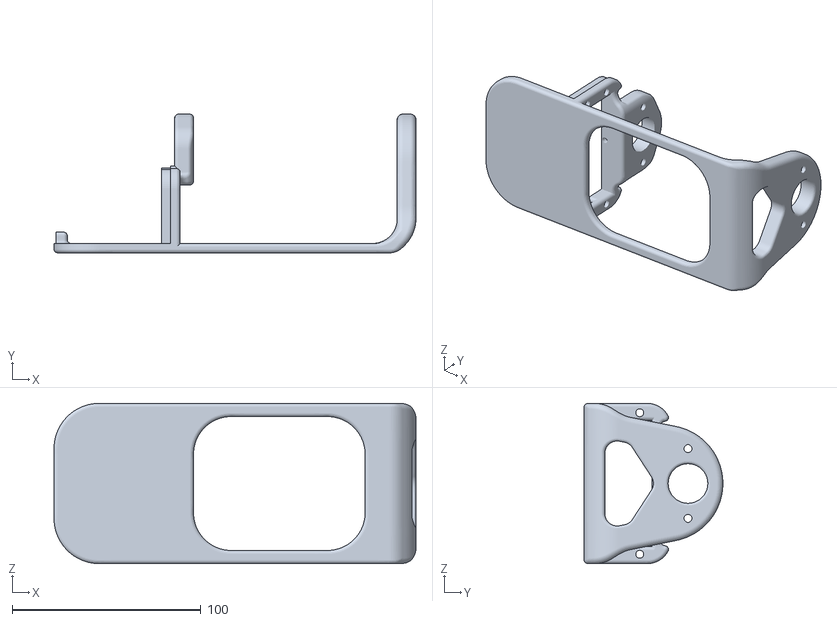
[picture p201: CAD file, 2019-06-23]
hardware/export/shells/Rect foot.stl
192.0 x 73.6 x 85.0
