aibrainag/Gretchen/(list of files, cad)

Other CAD files:
hardware/export/shells/thigh_3_outer_upper.stl
hardware/export/shells/shank_1_outer_upper.stl
hardware/export/shells/shank_3_inner_upper.stl
hardware/export/shells/shank_2_outer_lower (M).stl
hardware/export/shells/shank_4_inner_lower.stl
hardware/export/shells/thigh_1_inner_upper (M).stl
hardware/export/shells/thigh_adapter_back_outer.stl
hardware/export/shells/thigh_4_outer_lower.stl
hardware/export/supreme_GT3_pulley_42T_7mm_M8_nut_20190121.stl
hardware/parts/Flange_Bearing_Drills.f3d
hardware/parts/Hitec_HS-805MG.f3d
hardware/parts/belt-tightener.f3d
hardware/parts/camera_gimbal_intel/bearing_holder.f3d
hardware/parts/camera_gimbal_intel/gimbal_base_intel.f3z
hardware/parts/camera_gimbal_intel/gimbal_bearing_adapter.f3d
hardware/parts/flange_bearing.f3d
hardware/parts/grt_cardan_joint_20190218.f3d
hardware/parts/grt_cardan_joint_pulley_33T_20190328.f3d
hardware/parts/grt_cardan_joint_pulley_42T_20190328.f3d
hardware/parts/grt_foot_motor_pulley_33T_20190328.f3d
hardware/parts/grt_knee_20190218.f3z
hardware/parts/grt_knee_inner_20190218.f3z
hardware/parts/grt_lower_torso_20190218.f3d
hardware/parts/grt_shank_20190218.f3z
hardware/parts/grt_thigh_20190218.f3d
hardware/parts/simple_spacer.f3d
hardware/parts/supreme_GT3_pulley_42T_7mm_M8_nut_20190121.f3d
hardware/parts/supreme_GT3_pulley_42T_7mm_axel_connector_20190121.f3d
hardware/parts/supreme_GT3_pulley_42T_7mm_d1_spline_20190218.f3d
hardware/parts/supreme_Hitec_HS805_MG_cap_20190121.f3d
hardware/parts/supreme_hitec_HS805-MG_contour.f3d
