aibrainag/Gretchen/documentation/images/assembly_overview.jpg

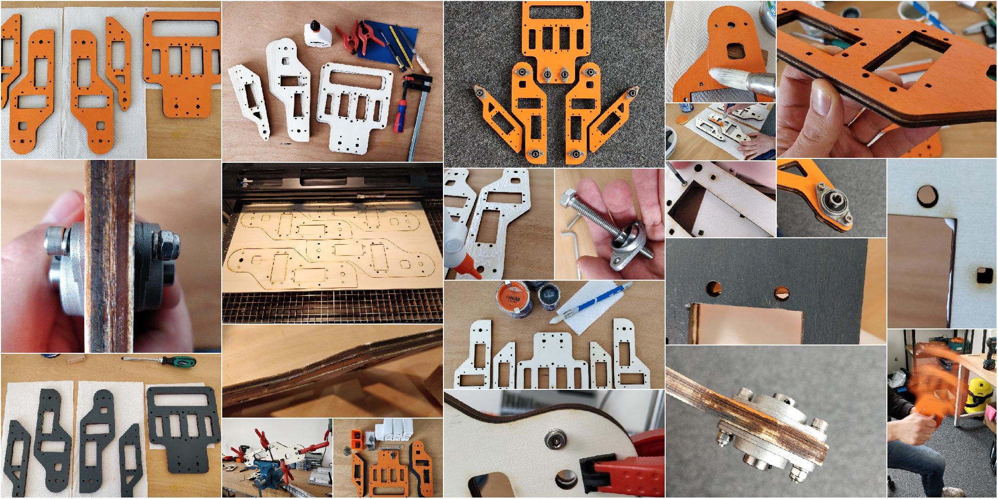
documentation/images/assembly_overview.jpg
