aibrainag/Gretchen/(commit log)

2019-02-26 documentation section for mounting bearings.
2019-02-26 Added first chunk of 3d parts.
    [Flange_Bearing_Drills.f3d, Hitec_HS-805MG.f3d, flange_bearing.f3d, grt_cardan_joint_20190218.f3d, grt_knee_20190218.f3z, grt_knee_inner_20190218.f3z, grt_lower_torso_20190218.f3d, grt_shank_20190218.f3z]
2019-02-26 adding export files for part manufacturing and bom.
    [grt_cardan_joint_20190218.stl, grt_dev0.bom.ods, grt_dynamic foot_20180902.stl, grt_foot_cardan_20190218.stl, grt_knee_20180829.stl, grt_knee_20190213.stl, grt_knee_inner_20180830.stl, grt_shank_contour_20180826.dxf]
2019-02-27 Added submodules from supreme machines for sensorimotor software.
2019-02-27 Added section for mounting knee.
2019-03-01 Adding section for assembly of hex nut pulleys for hips.
2019-03-07 Finished section about assembling the hip.
2019-03-11 documentation: desoldering motor boards.
2019-03-12 Added section on soldering the throughhole parts to sensorimotor.
2019-03-12 Added sensorimotor assembly videos and updated gretchen bom.
    [grt_dev0.bom.ods]
2019-03-13 started section about installing sensorimotors.
2019-03-14 finished section about installing sensorimotor into motorbox.
2019-03-20 added section about leg assembly.
2019-03-21 Added pictures and videos for flashing fuses and setting ids.
2019-03-22 section for mounting the legs to the lower torso.
2019-03-26 updated bom.
    [grt_dev0.bom.ods]
2019-03-28 added fusion360 constructions for recently updated parts.
    [belt-tightener.f3d, grt_cardan_joint_pulley_33T_20190328.f3d, grt_cardan_joint_pulley_42T_20190328.f3d, grt_foot_motor_pulley_33T_20190328.f3d]
2019-03-28 removed depricated foot.
    [grt_dynamic foot_20180902.stl]
2019-03-28 Added stl exports of parts.
    [belt-tightener.stl, grt_cardan_joint_pulley_33T_20190328.stl, grt_cardan_joint_pulley_42T_20190328.stl, grt_foot_motor_pulley_33T_20190328.stl, supreme_GT3_pulley_42T_7mm_d1_spline_20190307.stl]
2019-03-28 Adding doc part for cable confection and foot assembly.
2019-03-28 updated bom/partlist and known issues
    [grt_dev0.bom.ods]
2019-03-29 finishing alpha of assembly manual.
2019-05-15 Added files for Gretchens shells and new feet. The stl files aswell as the fusion 360 files are included. For a full documentation of the design process, manufacturing and assembly, view the attached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
    [Foot Shell.stl, Rect foot.stl, shank_1_outer_upper (M).stl, shank_1_outer_upper.stl, shank_2_outer_lower (M).stl, shank_2_outer_lower.stl, shank_3_inner_upper (M).stl, shank_3_inner_upper.stl]
2019-07-08 Added Fusion & STL Files for the camera gimbal, using the intel realsense camera. e
    [Foot Shell.stl, Rect foot.stl, bearing_holder.f3d, bearing_holder_v20.stl, gimbal_base_intel v17.stl, gimbal_base_intel.f3z, gimbal_bearing_adapter v10.stl, gimbal_bearing_adapter.f3d]
